sadekbaroudi/fingerpunch/firmware/README.md

# Firmware

This has moved to:
https://github.com/sadekbaroudi/qmk_firmware/tree/master/keyboards/fingerpunch/FIRMWARE.md

General readme for fingerpunch configuration options can be found here:
https://github.com/sadekbaroudi/qmk_firmware/tree/master/keyboards/fingerpunch/README.md
