sadekbaroudi/fingerpunch/keyboards/vikropad/README.md

# vikropad

The PCB and details can be found in the [vik github repository](https://github.com/sadekbaroudi/vik/tree/master/pcb/vikropad/)

The cases can be found in the `cases` directory in this repository.
