sadekbaroudi/fingerpunch/keycaps/CMY/README.md

# Cylindrical Minimal Y (CMY)

These are keycaps that are a standard 18mm width, but only 15.4mm height. The intent is to have some comfortable keycaps to be used with keyboard designs that utilize minimal Y spacing.

There is support for the following switch types:  
* MX
* Choc v1
* KS-27 and KS-33

Note: I do not recommend these for keyboards that have standard 19mm pcb vertical spacing. These will leave a gap between the keycaps, and will not be as comfortable. That said, you can definitely use them on standard spacing if you like!

## Build pics

MX:  
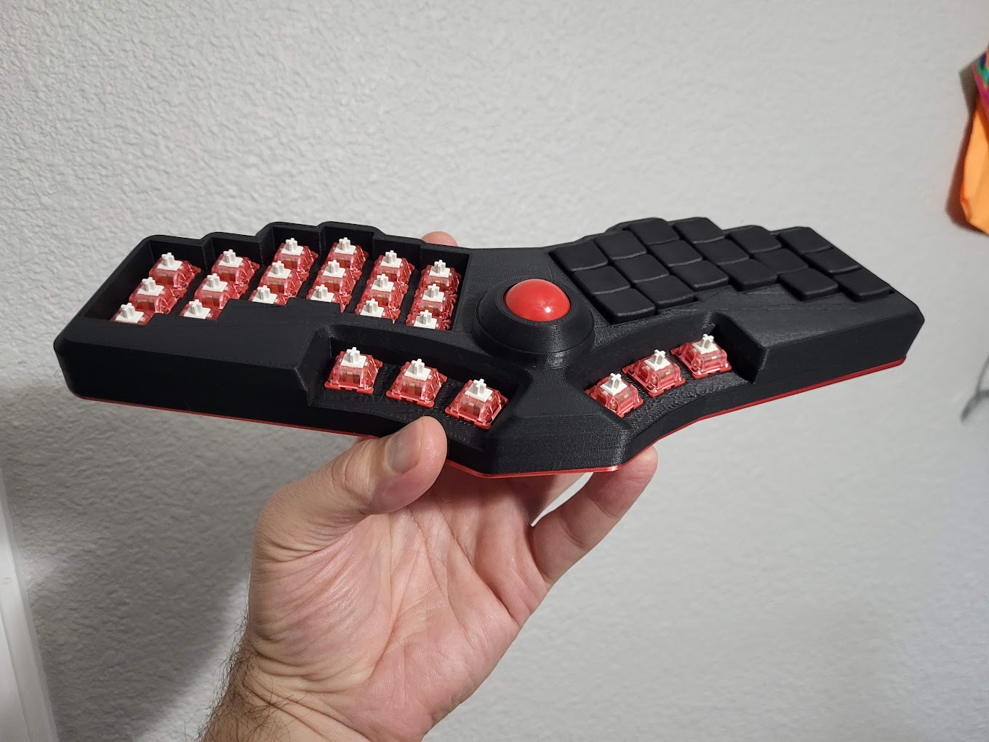
[picture p8: keycaps/CMY/images/build-mx-5-degree.jpg]
mx5


Choc:  
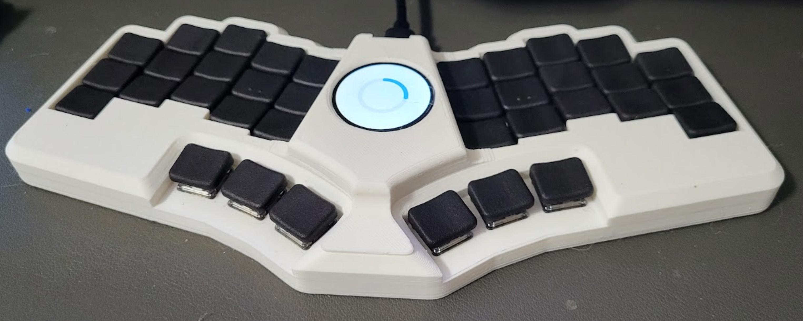
[picture p9: keycaps/CMY/images/build-choc-5-degree.jpg]
choc5


KS-33:  
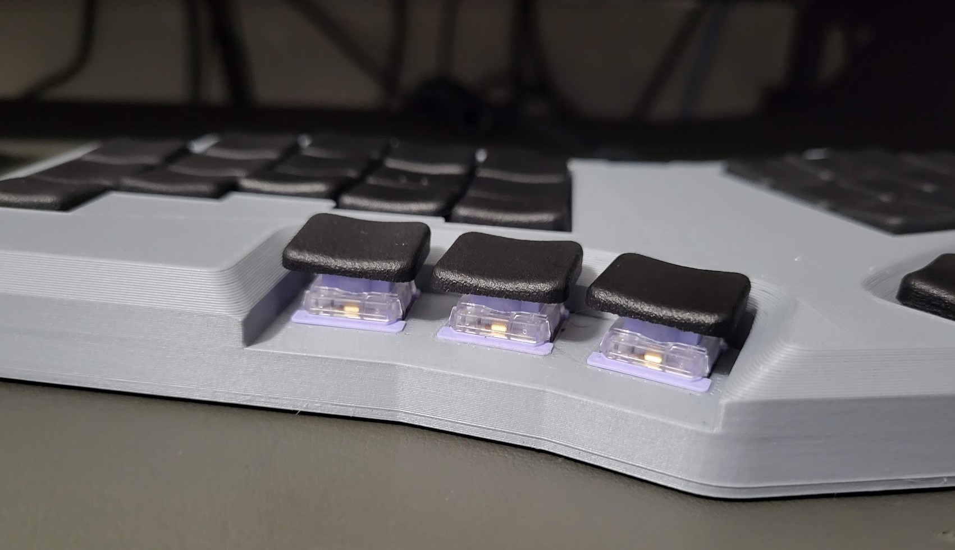
[picture p10: keycaps/CMY/images/build-ks33-5-degree.jpg]
ks33-5


## Renders

For the renders below, note that non-sculpted thumbs are not pictured. If you'd like to use non-sculpted thumbs, you can use the 12 degree R2/R4 keys. They make for good thumb keys.

### Homing

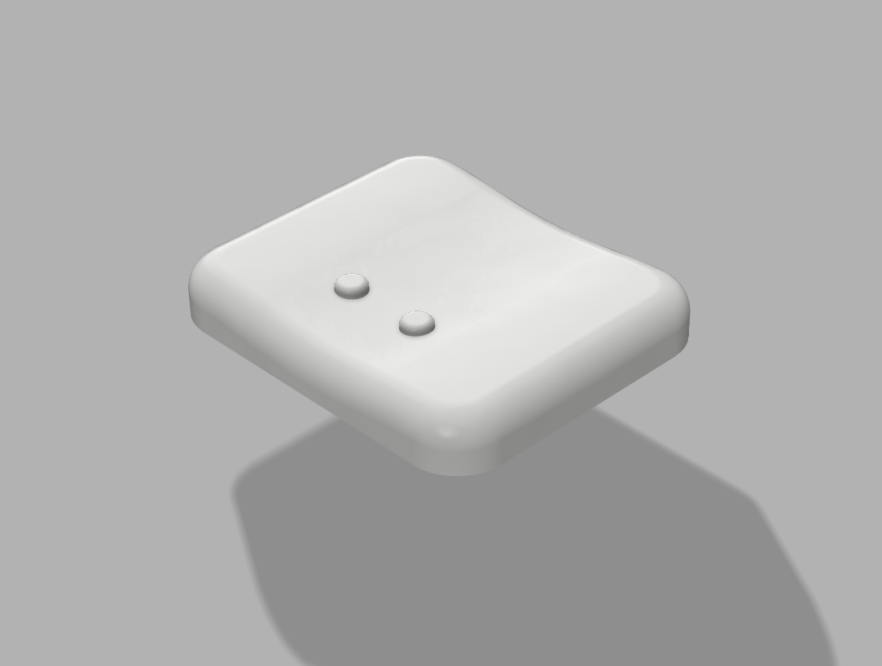
[picture p11: keycaps/CMY/images/CMY-homing.png]
CMY-homing


### 5 degree vertical tilt

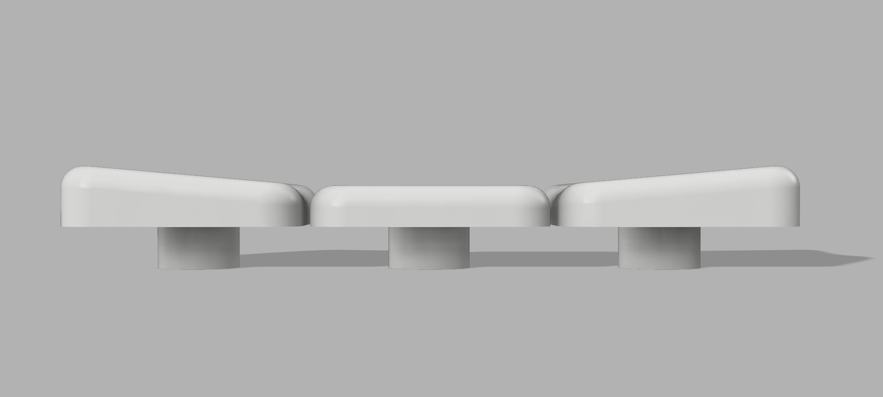
[picture p12: keycaps/CMY/images/CMY-5-lateral-side.png]
CMY-5-lateral-side


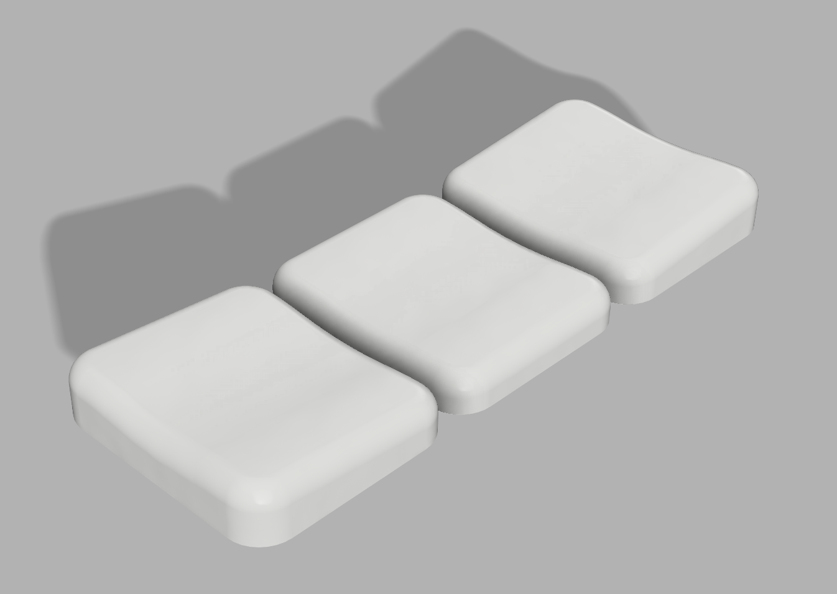
[picture p13: keycaps/CMY/images/CMY-5-lateral-45corner.png]
CMY-5-lateral-45corner


### 12 degree vertical tilt

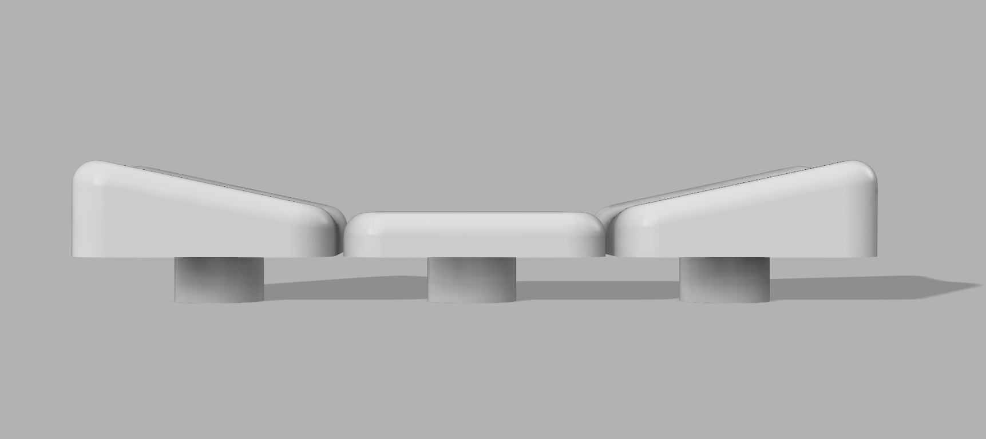
[picture p14: keycaps/CMY/images/CMY-12-lateral-side.png]
CMY-12-lateral-side


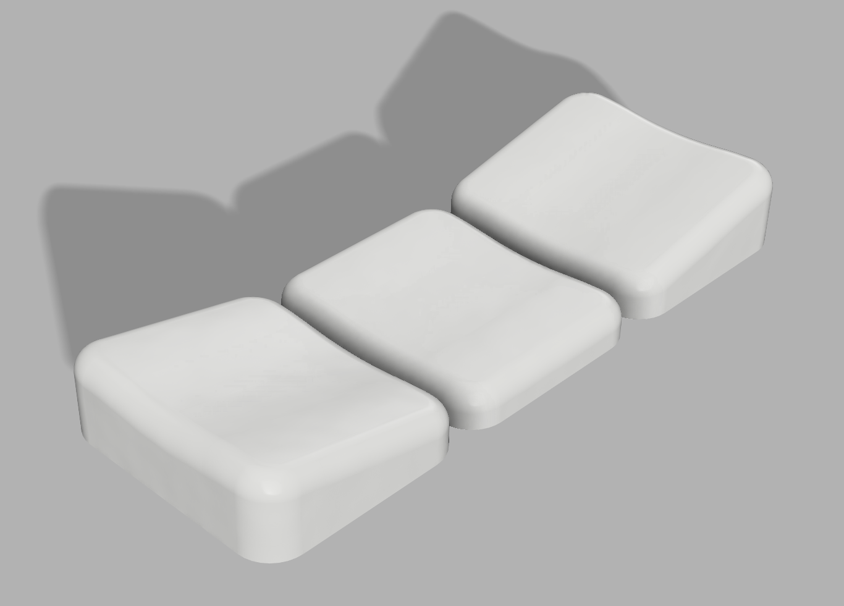
[picture p15: keycaps/CMY/images/CMY-12-lateral-45corner.png]
CMY-12-lateral-45corner


### 12 degree edge columns

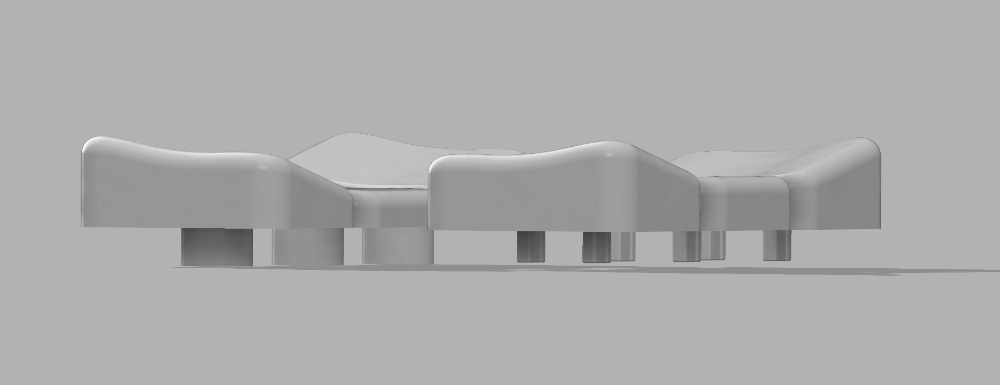
[picture p16: keycaps/CMY/images/CMY-12-edge-col-45flat.png]
CMY-12-edge-col-45flat


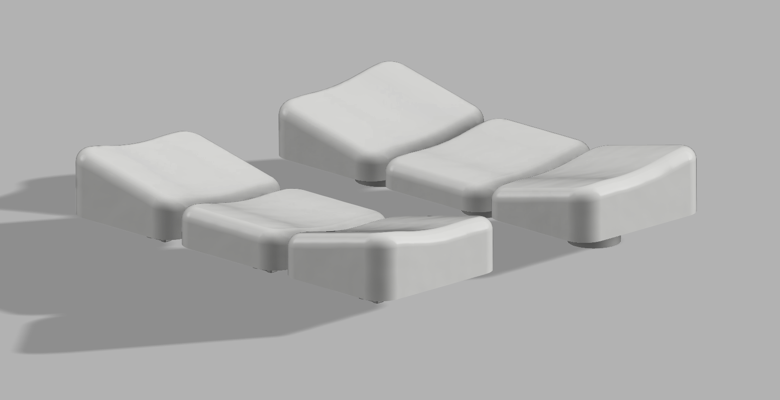
[picture p17: keycaps/CMY/images/CMY-12-edge-col-corner.png]
CMY-12-edge-col-corner


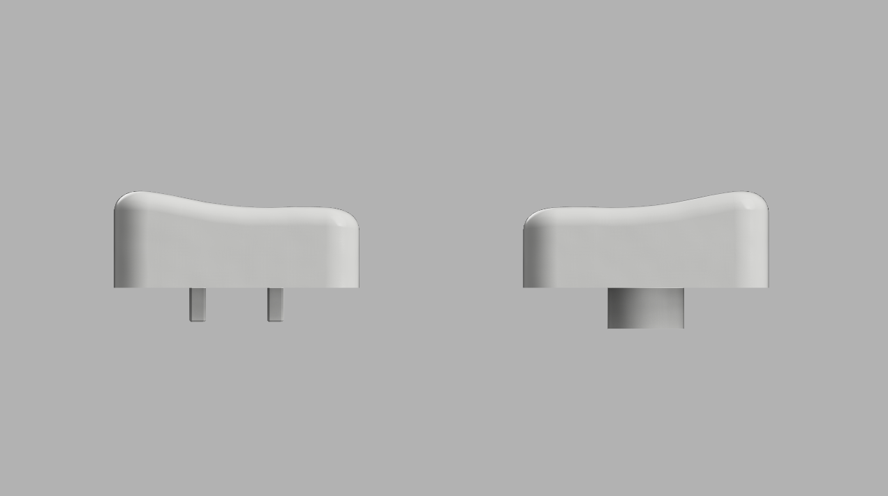
[picture p18: keycaps/CMY/images/CMY-12-edge-col-front.png]
CMY-12-edge-col-front


### 12 degree vertical tilt flat ends

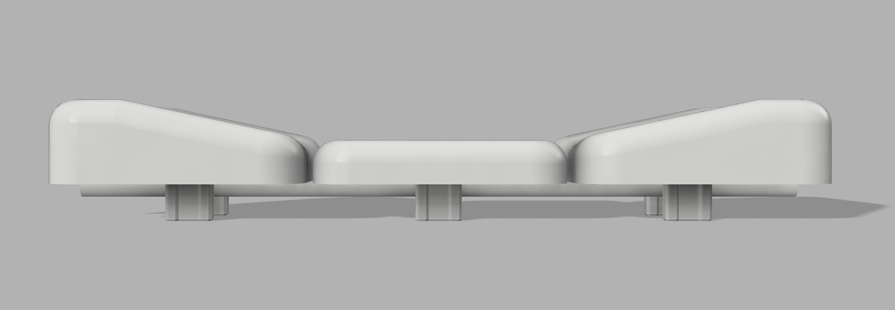
[picture p19: keycaps/CMY/images/CMY-12-flat-ends-lateral-side.png]
CMY-12-flat-ends-lateral-side


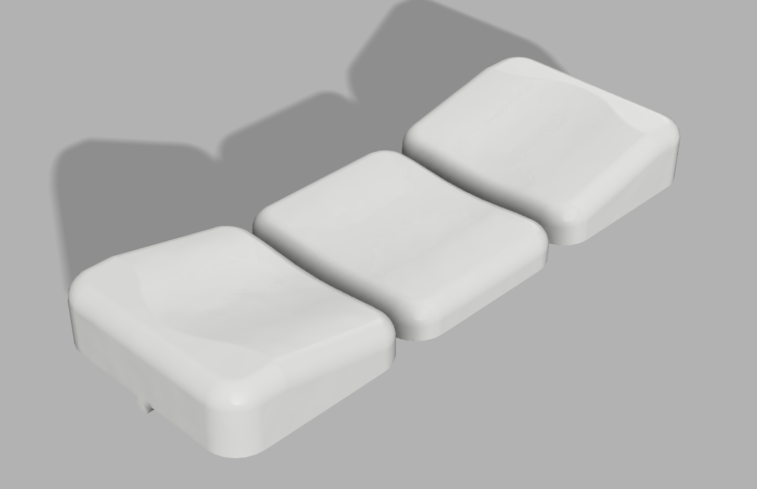
[picture p20: keycaps/CMY/images/CMY-12-flat-ends-lateral-45corner.png]
CMY-12-flat-ends-lateral-45corner


### Sculpted thumbs

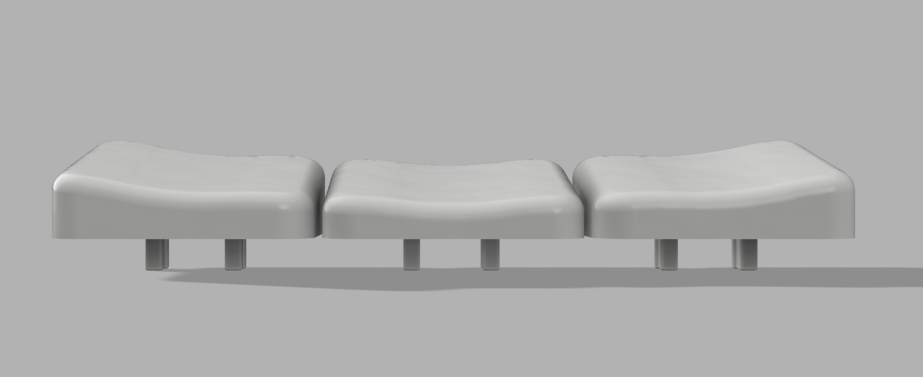
[picture p21: keycaps/CMY/images/CMY-12-sculpted-thumbs-front.png]
CMY-12-sculpted-thumbs-front


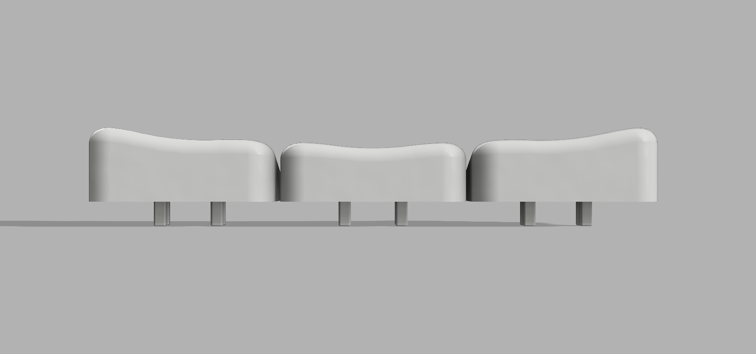
[picture p22: keycaps/CMY/images/CMY-12-sculpted-thumbs-back.png]
CMY-12-sculpted-thumbs-back


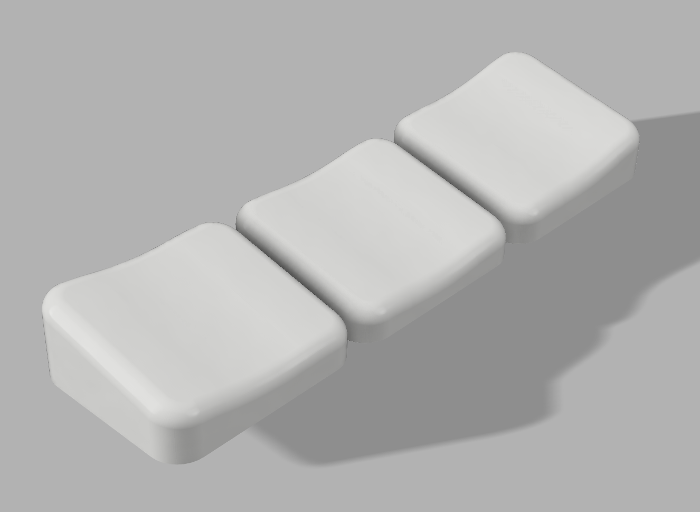
[picture p23: keycaps/CMY/images/CMY-12-sculpted-thumbs-45corner.png]
CMY-12-sculpted-thumbs-45corner


### Other

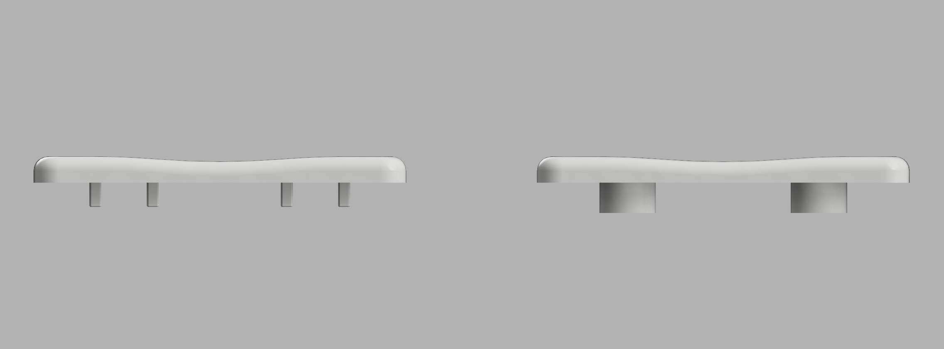
[picture p24: keycaps/CMY/images/CMY-2U-front.png]
CMY-2U-front


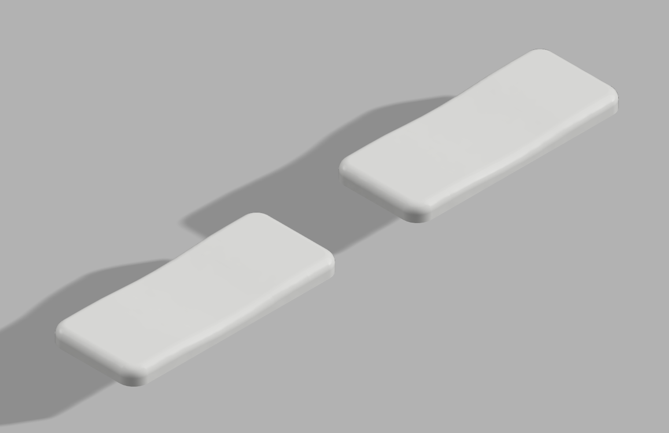
[picture p25: keycaps/CMY/images/CMY-2U-45corner.png]
CMY-2U-45corner
