sadekbaroudi/fingerpunch/keyboards/stenographobe/README.md

# stenographobe

http://fingerpunch.xyz/product/stenographobe
