sadekbaroudi/fingerpunch/keyboards/rock-on/README.md

# Rock On

https://fingerpunch.xyz/product/rock-on/
