sadekbaroudi/fingerpunch/keyboards/kucheza/byomcu/README.md

# kucheza byomcu

This is a limited edition pcb, very few of these were made, so it's very likely you should be looking at the other versions (e.g. v1 folder)
