sadekbaroudi/fingerpunch/3d-models/display-housings/ili9341/README.md

# ILI9341 display

This is a housing for a commonly found display. You can incorporate the housing into another object, and it accepts M2 heat set inserts to screw in the display. However, it is a press fit design, so you don't need them.

Purchased from:  
https://www.aliexpress.us/item/2251832829271342.html

## product image

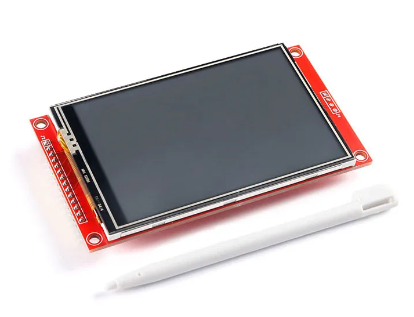
[picture p29: 3d-models/display-housings/ili9341/images/ili9341-4inch.png]
sample-image
