sadekbaroudi/fingerpunch/keyboards/vikropad/cases/README.md

# vikropad case

## choc and gateron low profile

### images

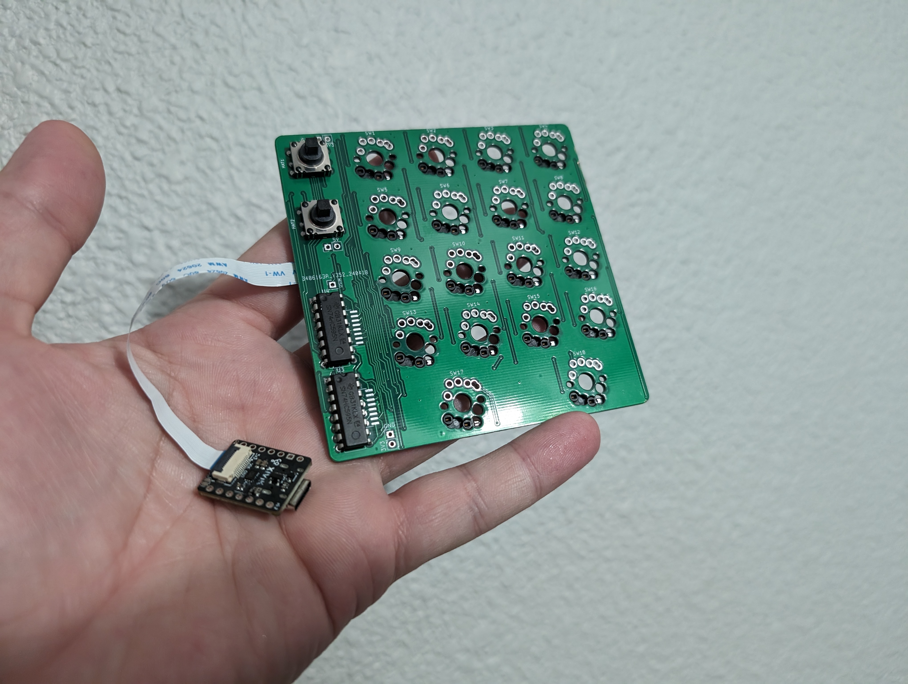
[picture p30: keyboards/vikropad/cases/choc-glp/images/vikropad-pcb-assembled.jpg]
vikropad-pcb-assembled

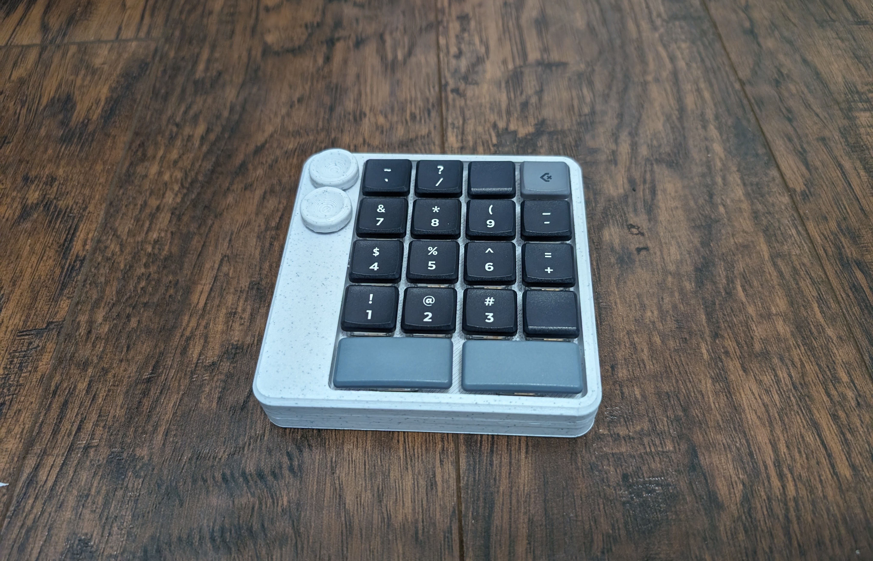
[picture p31: keyboards/vikropad/cases/choc-glp/images/vikropad-case-assembled-01.jpg]
vikropad-case-assembled-01

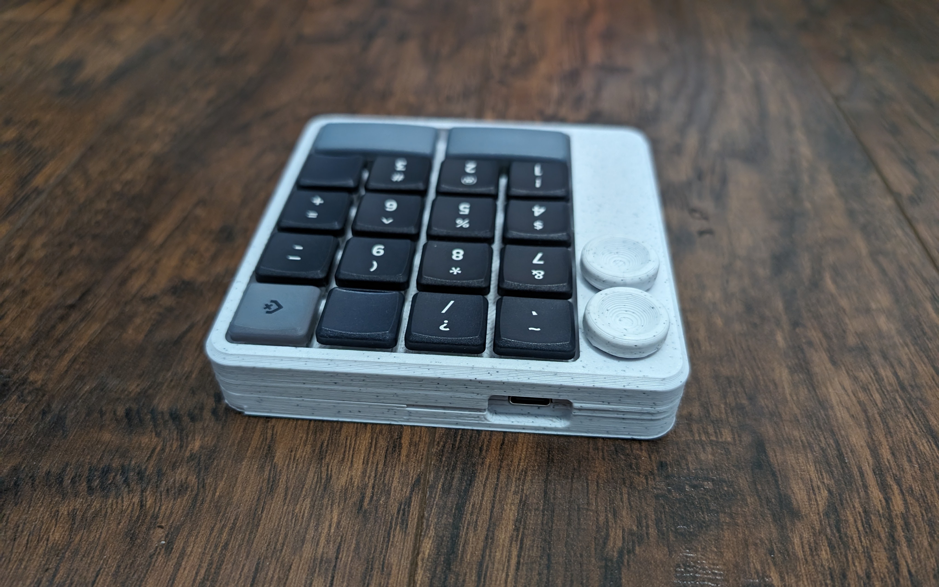
[picture p32: keyboards/vikropad/cases/choc-glp/images/vikropad-case-assembled-02.jpg]
vikropad-case-assembled-02
