sadekbaroudi/fingerpunch/keyboards/rock-on/cases/README.md

# rock on cases

I take no liability if these don't work as intended. I personally use them for the 3D printed cases on the website. I recheck them every time before I print, so I cannot ensure that they are perfect in their current state in this repository.
