sadekbaroudi/fingerpunch/keyboards/ffkb/cases/fr4/README.md

# ffkb fr4 plates

These are untested. They should be fine, as they are based on the PCB layout, but use at your own risk!
