sadekbaroudi/fingerpunch/keyboards/ffkb/cases/stls/v4/README.md

# ffkb v4

# bom

> **Note**
> This list is only for the case build, but not the entire ffkb keyboard build. You'll still need the ffkb pcb and all the components required for a typical ffkb build. See the [ffkb v4 usb-hub product page](https://fingerpunch.xyz/product/faux-fox-keyboard-v4)

To build this style case, you'll need:
* one of the case bodies
* the trackball holder
* the trackball cover
* bottom plate
* 8x - 8mm diameter by 3mm magnets
* 9x - 5mm M2 screws
* 9x - M2 4mm heat set inserts

# pictures

## 6 column

## mx trackball case with ec11 cutouts

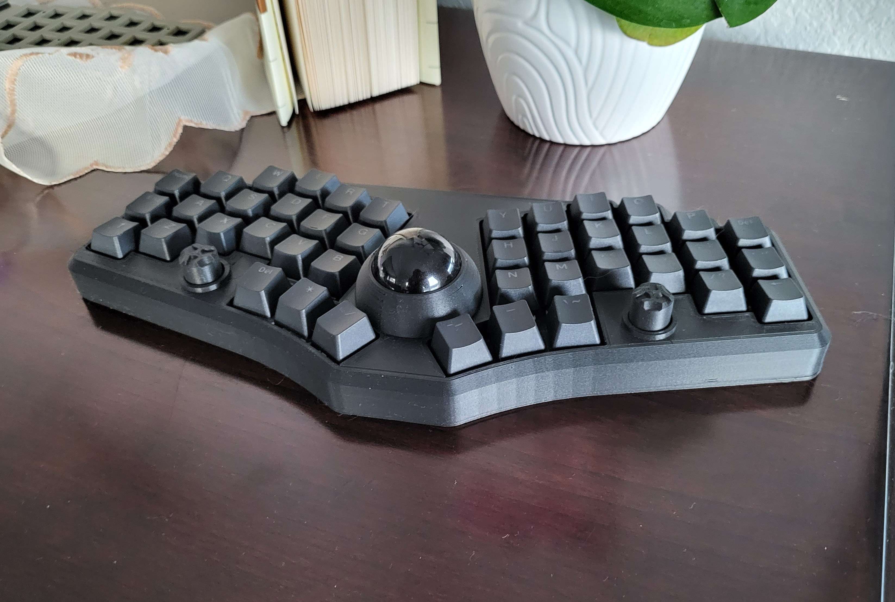
[picture p35: keyboards/ffkb/cases/stls/v4/images/ff-rp-u3-mx-6-tr-ec-01.png]
render ffkb mx trackball case 01


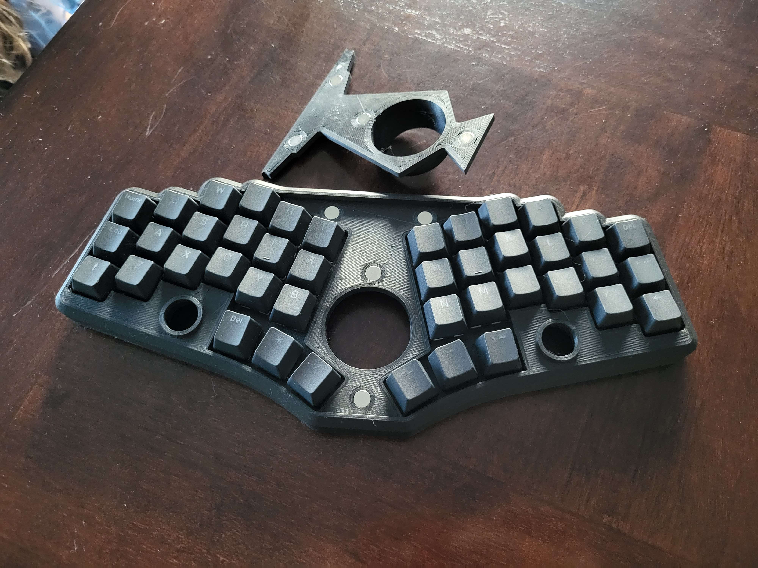
[picture p36: keyboards/ffkb/cases/stls/v4/images/ff-rp-u3-mx-6-tr-ec-02.png]
render ffkb mx trackball case 02


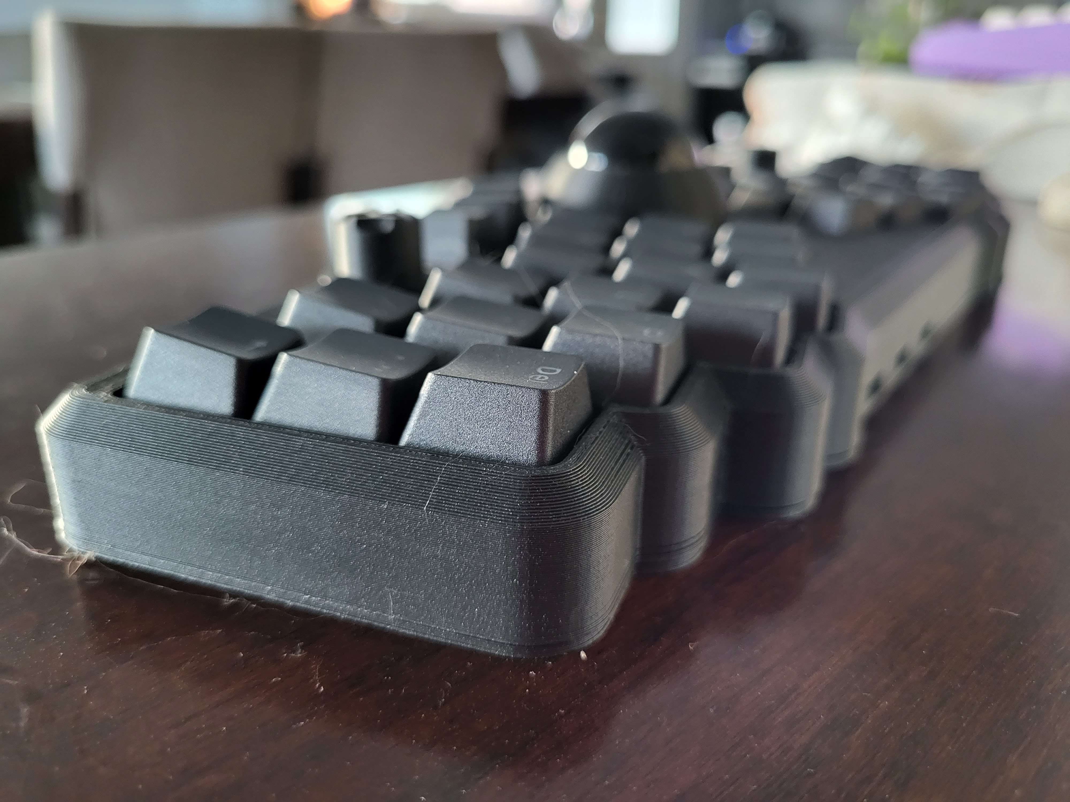
[picture p37: keyboards/ffkb/cases/stls/v4/images/ff-rp-u3-mx-6-tr-ec-03.png]
render ffkb mx trackball case 03


# renders

## 6 column

### choc trackball case with ec11 cutouts

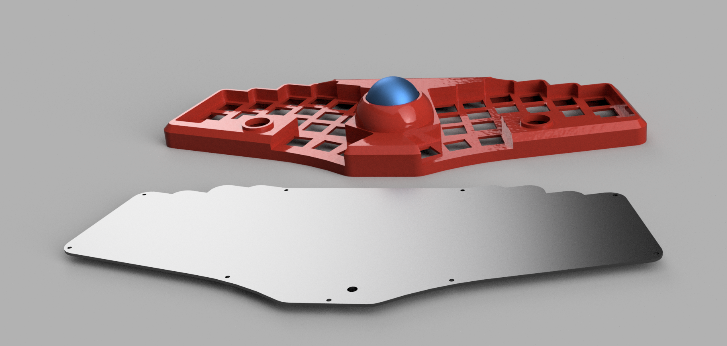
[picture p38: keyboards/ffkb/cases/stls/v4/images/ff-rp-u3-choc-6-tr-ec.png]
render ffkb choc trackball case


### choc trackball case with evq cutouts

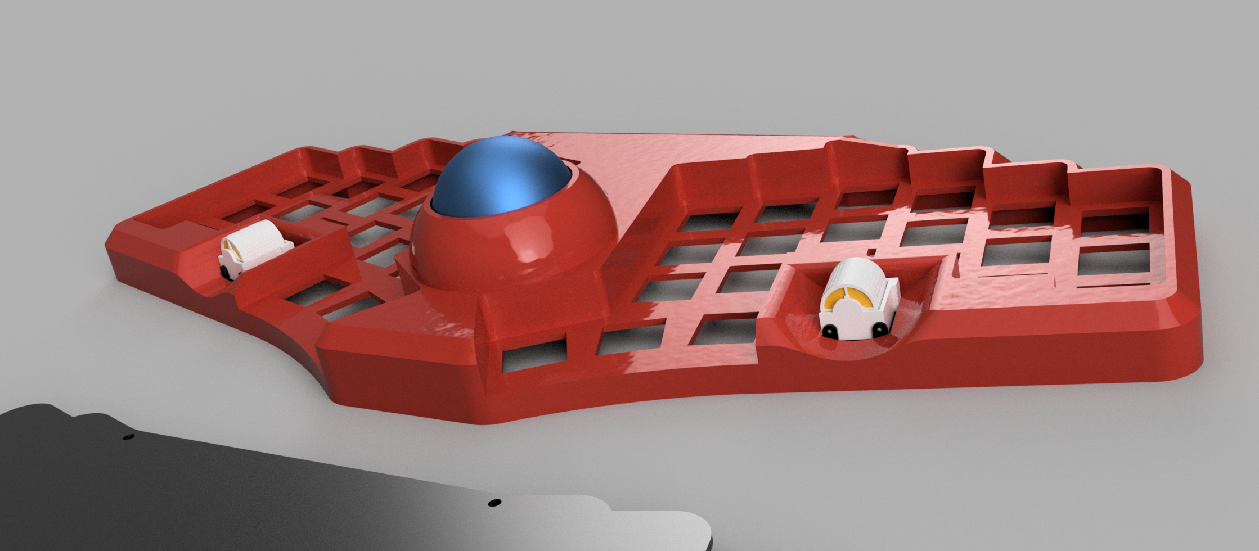
[picture p39: keyboards/ffkb/cases/stls/v4/images/ff-rp-u3-choc-6-tr-ev-01.png]
render ffkb choc trackball case with evq 01


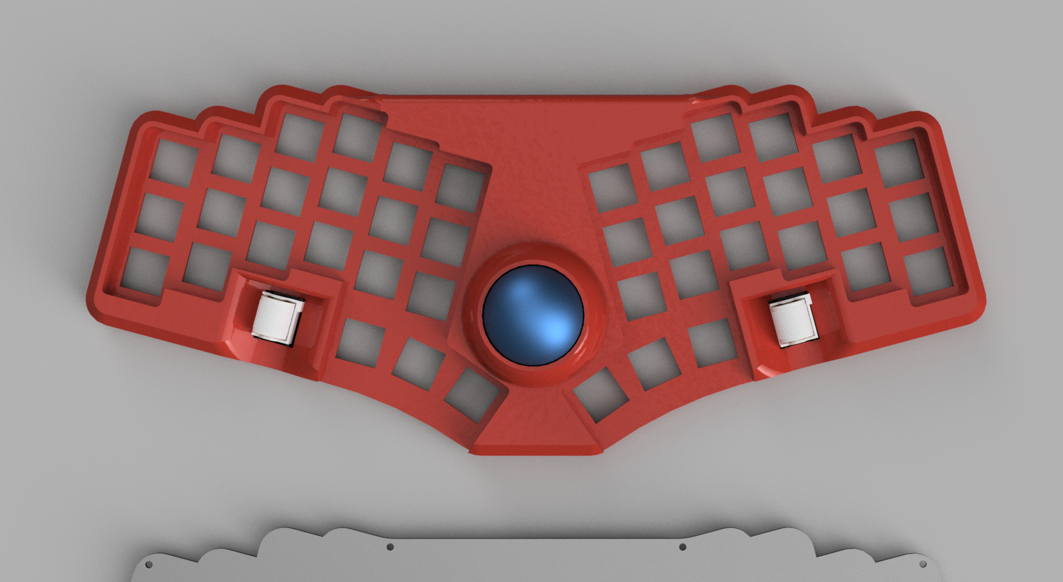
[picture p40: keyboards/ffkb/cases/stls/v4/images/ff-rp-u3-choc-6-tr-ev-02.png]
render ffkb choc trackball case with evq 02


## 5 column

### choc trackball case with evq cutouts

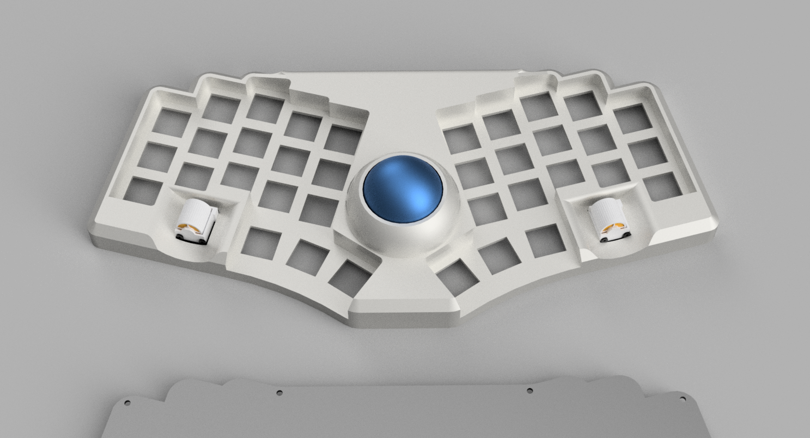
[picture p41: keyboards/ffkb/cases/stls/v4/images/ff-rp-u3-choc-5-tr-ev-01.png]
render ffkb 5 col choc trackball case with evq 01


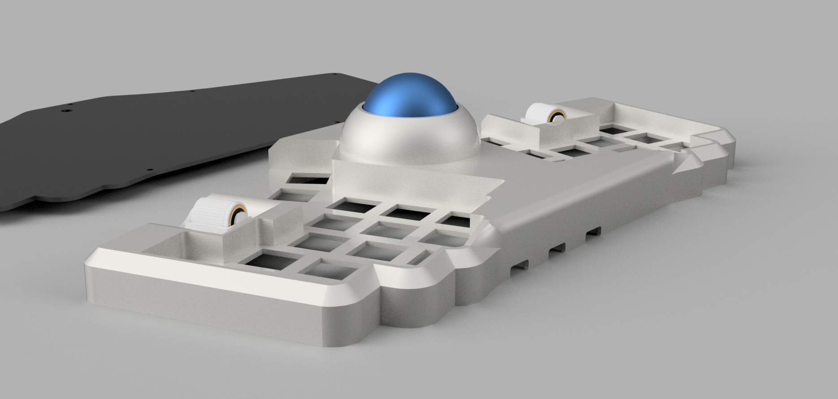
[picture p42: keyboards/ffkb/cases/stls/v4/images/ff-rp-u3-choc-5-tr-ev-02.png]
render ffkb 5 col choc trackball case with evq 02
