sadekbaroudi/fingerpunch/keyboards/ffkb/cases/stls/lowpro-chunky/README.md

# ffkb low pro chunky case

A simple ffkb case for low profile switches.

This will work nicely with all ffkb pcbs, provided you're not using any center components.

You can use the bottom plates from the lowpro-led-ring case.
