sadekbaroudi/fingerpunch/keyboards/ffkb/firmware/v1/byo-mcu/vial/readme.md

# These are untested, but committing as placeholder until tested.

Select the hex file based on the features you have on your board, and load it with QMK Toolbox

Once you have loaded it, you can use Vial to configure your keyboard:
https://get.vial.today/

Note that you can always manually create your firmware:
https://github.com/sadekbaroudi/qmk_firmware/

Specifically, look at the keyboards/fingerpunch/ffkb_byomcu directory
