sadekbaroudi/fingerpunch/keyboards/ffkb/cases/stls/v2/low-pro/README.md

# Build notes

## OLED on low pro case

First you want to put the OLED onto the pcb

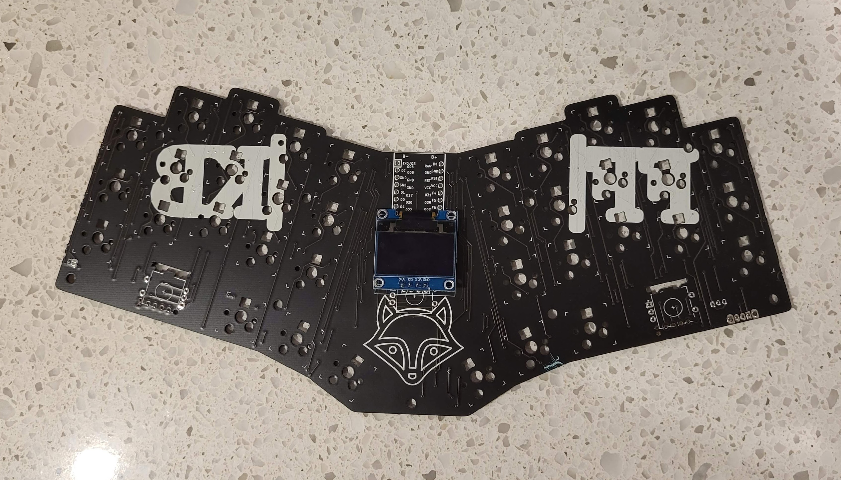
[picture p52: keyboards/ffkb/cases/stls/v2/low-pro/images/lowpro-oled-01.jpg]
lowpro-oled-01


***

Now you want to put 6 switches or so into the case to make sure the pcb is in the correct position

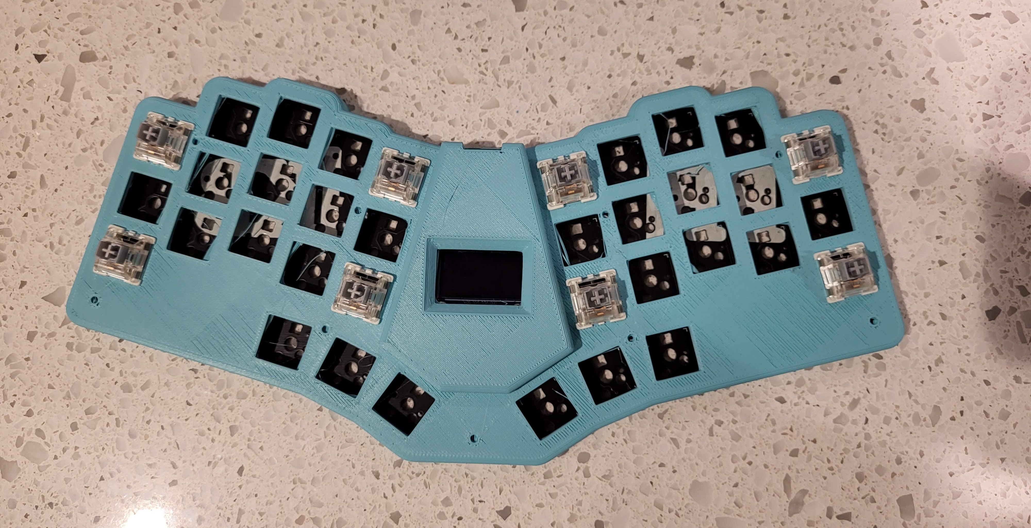
[picture p53: keyboards/ffkb/cases/stls/v2/low-pro/images/lowpro-oled-02.jpg]
lowpro-oled-02


***

Place the pcb into the case. This means that the OLED will be in the correct depth. Solder only 1 pin. Flip the board over to make sure that the OLED looks right. If it's a bit off, heat up the pin you soldered and move the OLED a bit. Repeat this until the OLED looks correct from the top. Now, solder the other 3 pins on the OLED

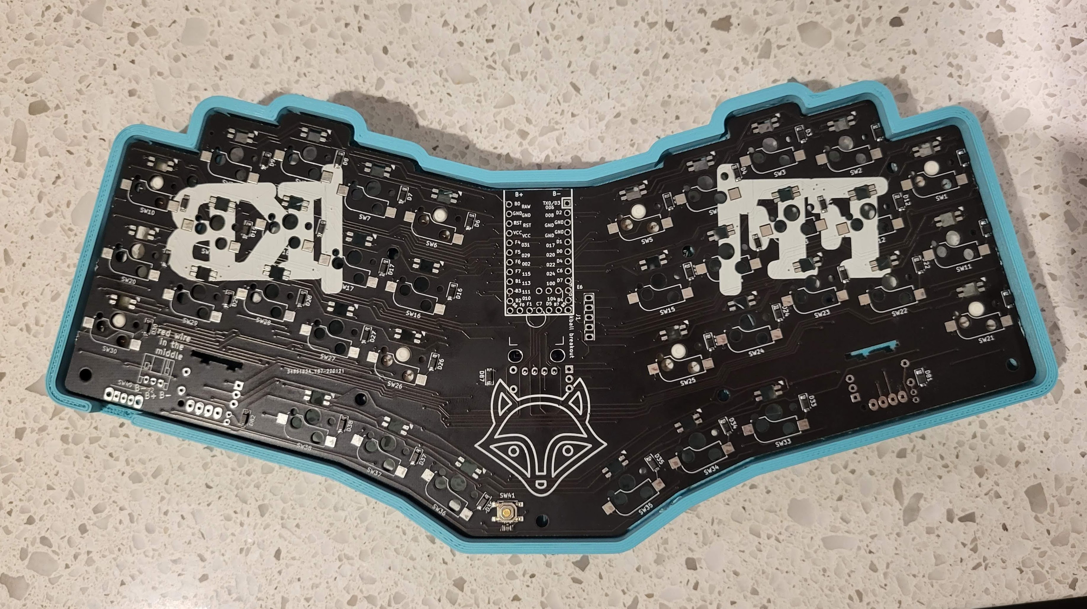
[picture p54: keyboards/ffkb/cases/stls/v2/low-pro/images/lowpro-oled-03.jpg]
lowpro-oled-03
