sadekbaroudi/fingerpunch/3d-models/trackball-thumb-helmet/images/M2-mounting-screws.png

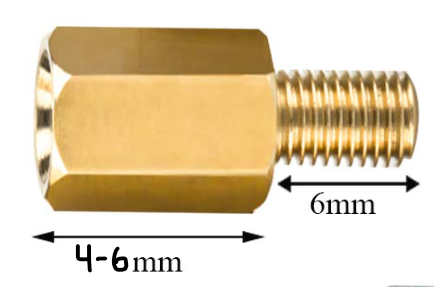
3d-models/trackball-thumb-helmet/images/M2-mounting-screws.png
