sadekbaroudi/fingerpunch/keyboards/pinkies-out/v2/images/pcb-controller.jpg

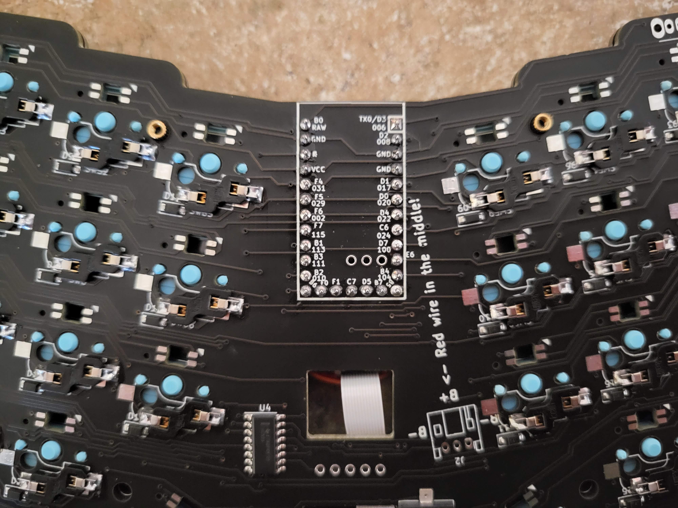
keyboards/pinkies-out/v2/images/pcb-controller.jpg
