sadekbaroudi/fingerpunch/keyboards/pinkies-out/v2/images/top-plate.png

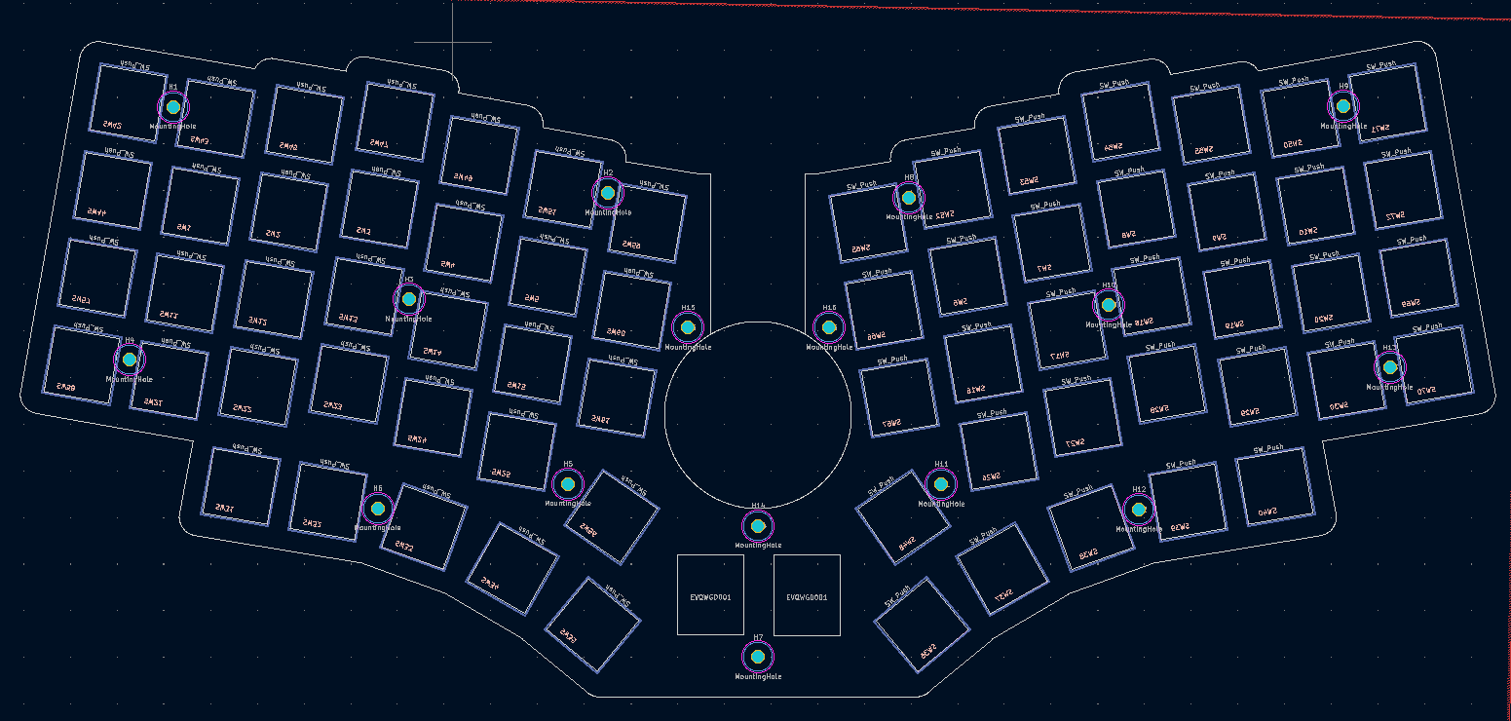
keyboards/pinkies-out/v2/images/top-plate.png
