sadekbaroudi/fingerpunch/keycaps/CMY/images/1.png

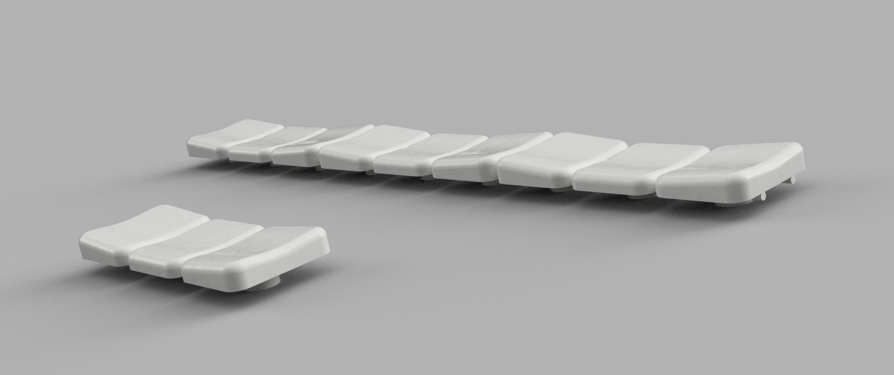
keycaps/CMY/images/1.png
