sadekbaroudi/fingerpunch/keycaps/CMY/images/2.png

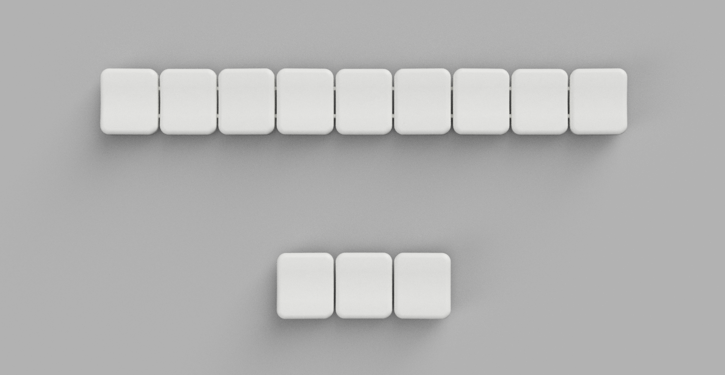
keycaps/CMY/images/2.png
