sadekbaroudi/fingerpunch/keycaps/CMY/images/CMY-12-flat-ends-lateral-45up.png

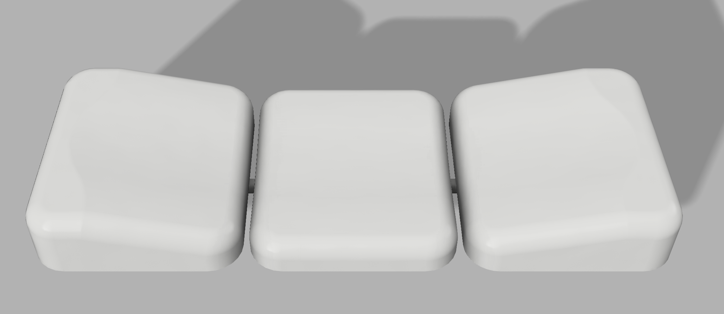
keycaps/CMY/images/CMY-12-flat-ends-lateral-45up.png
