sadekbaroudi/fingerpunch/3d-models/5-way-tactile-switch-knobs/5-way-flat-chamfer.step

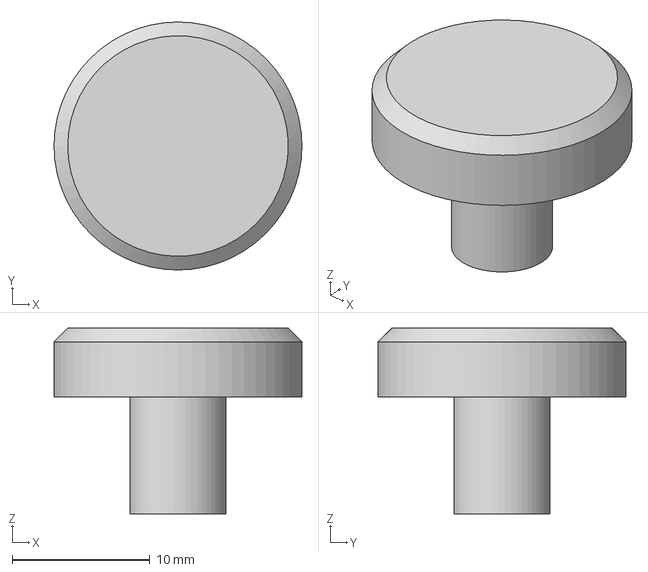
[picture p62: CAD file, 2024-04-17]
3d-models/5-way-tactile-switch-knobs/5-way-flat-chamfer.step
18.0 x 18.0 x 13.5 mm
