sadekbaroudi/fingerpunch/3d-models/display-housings/ili9341/ili9341-4inch-housing.step

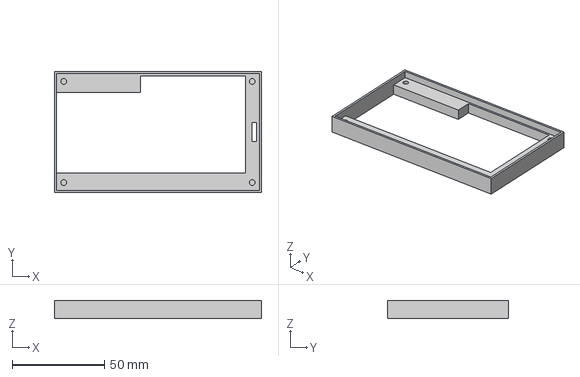
[picture p63: CAD file, 2024-06-14]
3d-models/display-housings/ili9341/ili9341-4inch-housing.step
112.4 x 65.7 x 10.0 mm
