sadekbaroudi/fingerpunch/3d-models/ec11-knobs/D/mushroom-6.1mm.stl

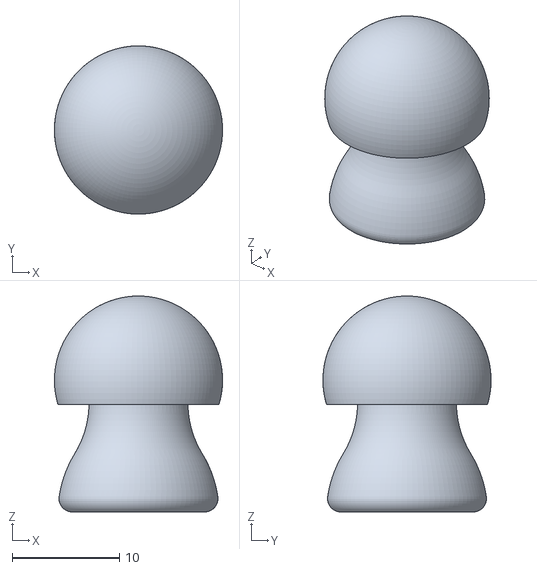
[picture p64: CAD file, 2023-10-12]
3d-models/ec11-knobs/D/mushroom-6.1mm.stl
15.7 x 15.7 x 20.1
