sadekbaroudi/fingerpunch/3d-models/fingerpunch-emblems/fingerpunch-emblem-45mm-diameter-35mm-plug.stl

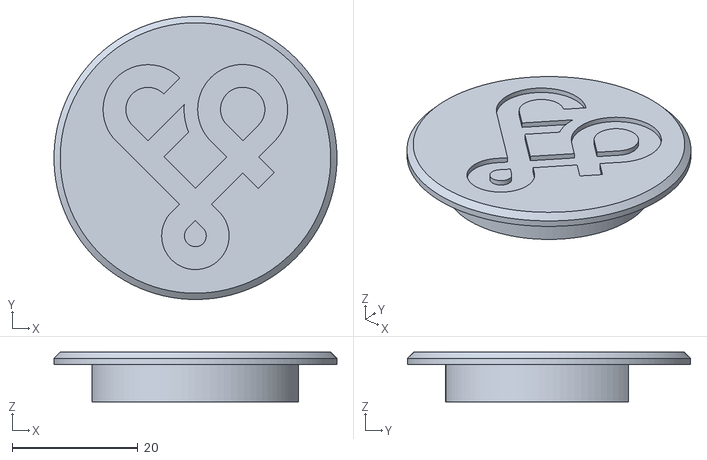
[picture p65: CAD file, 2024-02-02]
3d-models/fingerpunch-emblems/fingerpunch-emblem-45mm-diameter-35mm-plug.stl
45.0 x 45.0 x 7.90
