sadekbaroudi/fingerpunch/3d-models/per56-trackball/34mm/per56-34mm-trackball-cover.stl

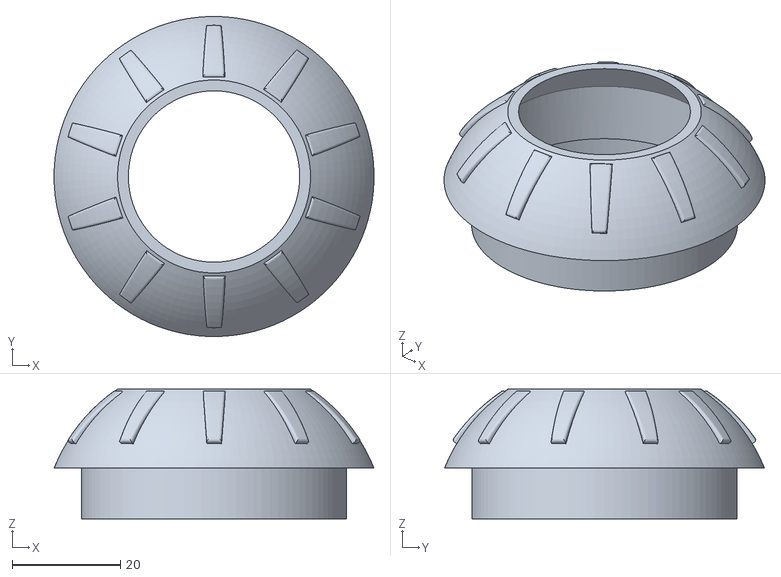
[picture p66: CAD file, 2023-10-06]
3d-models/per56-trackball/34mm/per56-34mm-trackball-cover.stl
59.1 x 59.1 x 24.0
