sadekbaroudi/fingerpunch/3d-models/per56-trackball/38mm/per56-38mm-trackball-housing-4mm-bearings.stl

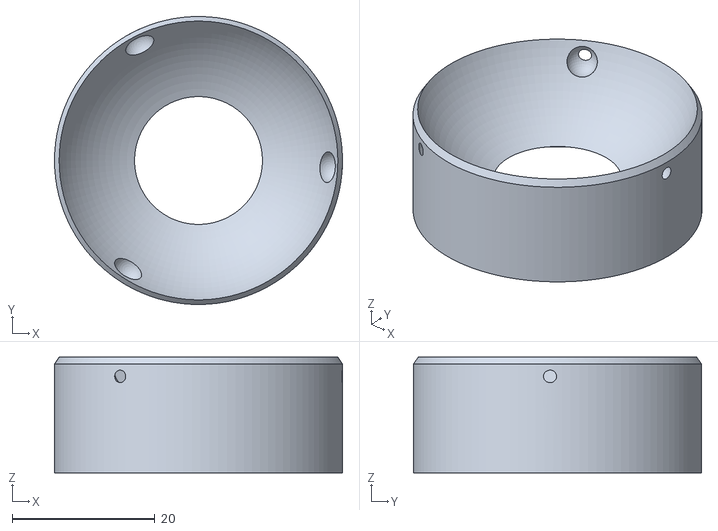
[picture p67: CAD file, 2023-09-24]
3d-models/per56-trackball/38mm/per56-38mm-trackball-housing-4mm-bearings.stl
40.3 x 40.3 x 16.2
