sadekbaroudi/fingerpunch/3d-models/solenoid/uxcell-a14092600ux0438/uxcell-a14092600ux0438-holder.stl

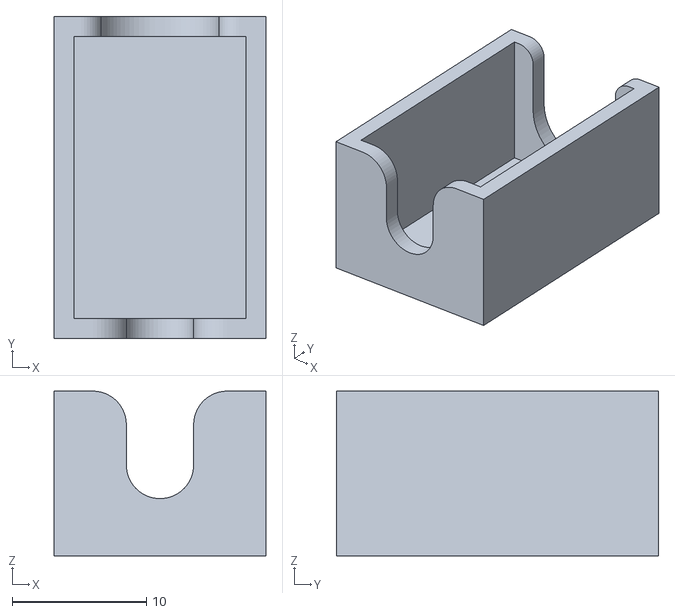
[picture p68: CAD file, 2024-06-04]
3d-models/solenoid/uxcell-a14092600ux0438/uxcell-a14092600ux0438-holder.stl
15.8 x 24.0 x 12.3
