sadekbaroudi/fingerpunch/3d-models/tenting/print-in-place/device-tenting-stand-70percent.stl

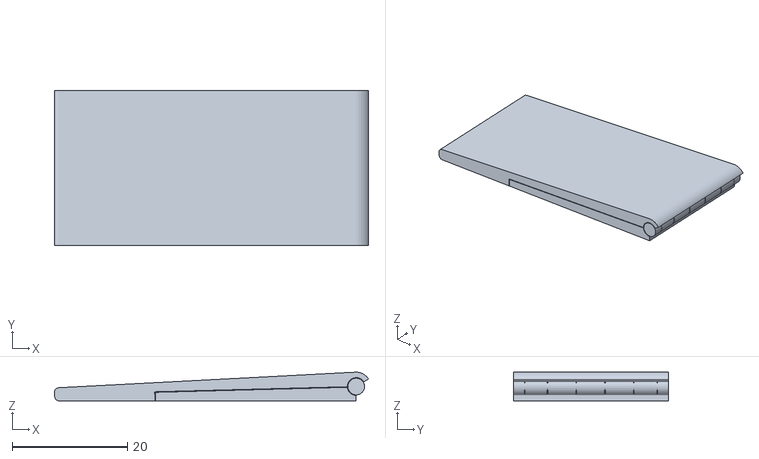
[picture p69: CAD file, 2024-01-10]
3d-models/tenting/print-in-place/device-tenting-stand-70percent.stl
54.6 x 27.0 x 5.00
