sadekbaroudi/fingerpunch/3d-models/trackball-thumb-helmet/trackball-thumb-helmet-housing-for-switch-cutouts-vik.stl

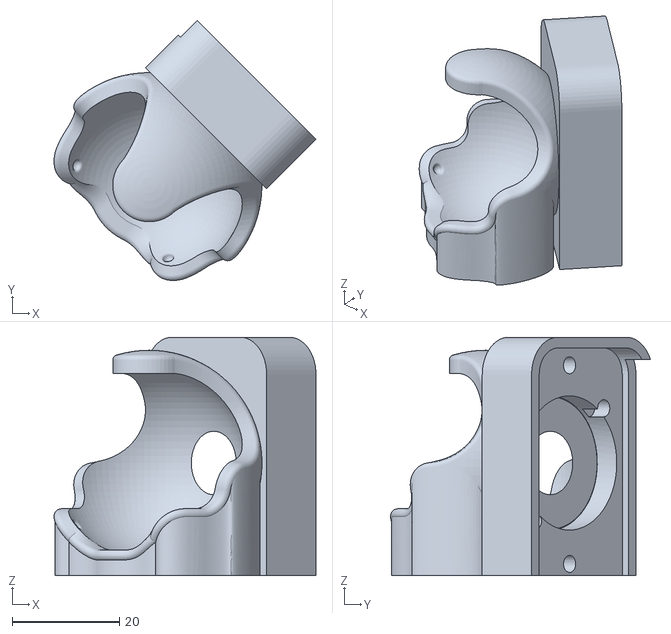
[picture p70: CAD file, 2024-05-14]
3d-models/trackball-thumb-helmet/trackball-thumb-helmet-housing-for-switch-cutouts-vik.stl
48.8 x 48.4 x 44.4
