sadekbaroudi/fingerpunch/3d-models/trackpoint/trackpoint-cover-labret-8Dx3Hx3mmCutout.stl

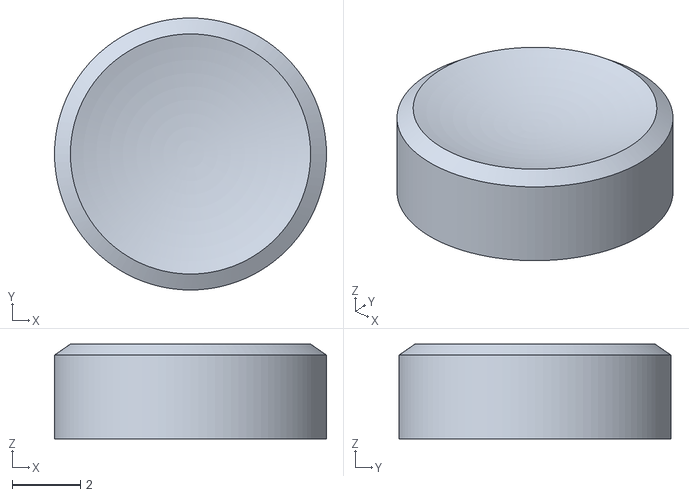
[picture p71: CAD file, 2024-02-26]
3d-models/trackpoint/trackpoint-cover-labret-8Dx3Hx3mmCutout.stl
8.00 x 8.00 x 2.79
