sadekbaroudi/fingerpunch/keyboards/bigbarobord/cases/stl/body-pimoroni.3mf

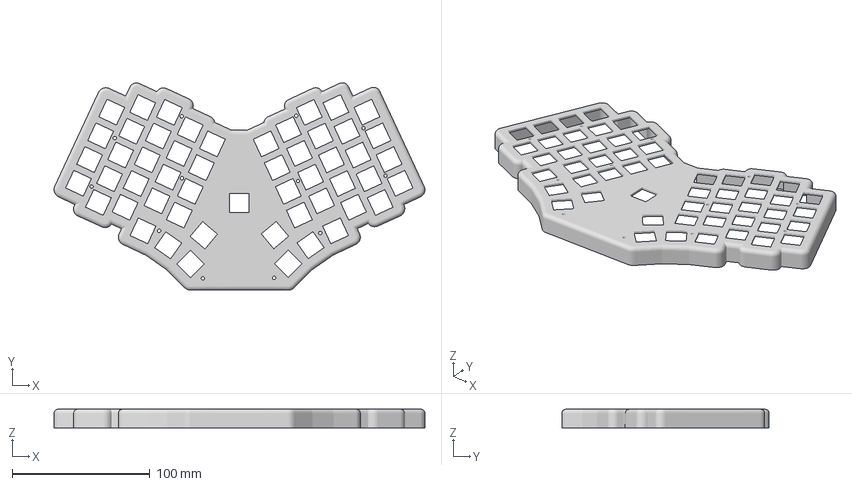
[picture p72: CAD file, 2022-08-29]
keyboards/bigbarobord/cases/stl/body-pimoroni.3mf
269.2 x 150.5 x 13.5 mm
