sadekbaroudi/fingerpunch/keyboards/bigbarobord/cases/svgs/general-template-brd.dxf

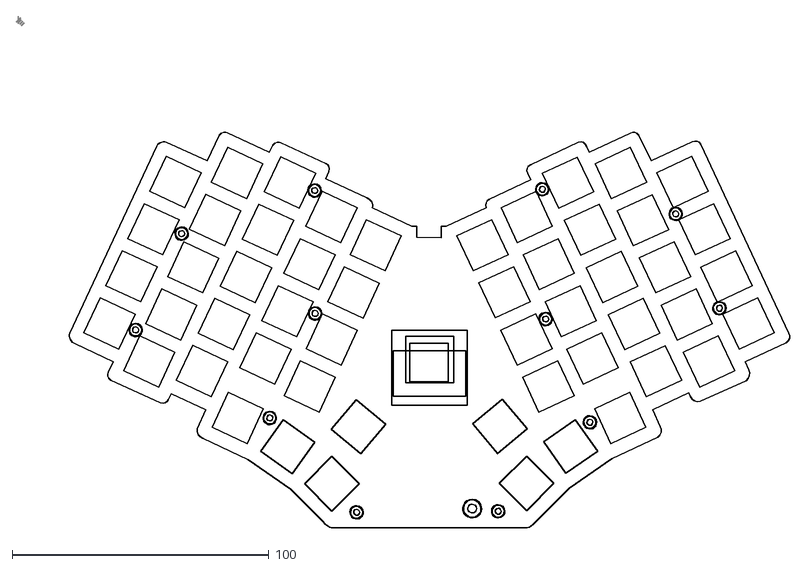
[picture p73: CAD file, 2022-08-29]
keyboards/bigbarobord/cases/svgs/general-template-brd.dxf
301.3 x 199.2
