sadekbaroudi/fingerpunch/keyboards/euclid36/cases/euclid36-bottom-plate-2mm.stl

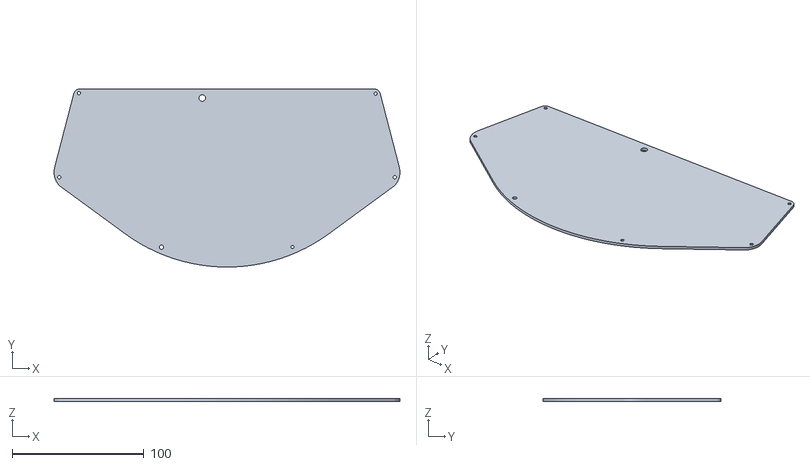
[picture p74: CAD file, 2023-08-09]
keyboards/euclid36/cases/euclid36-bottom-plate-2mm.stl
262.1 x 135.0 x 2.00
