sadekbaroudi/fingerpunch/keyboards/ffkb/cases/modular-plates/kicad/ffkb-switchplate-template-brd.dxf

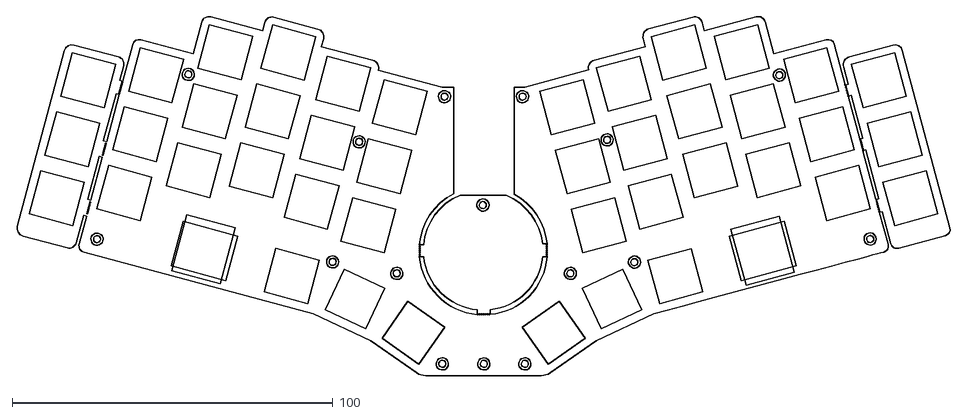
[picture p75: CAD file, 2022-09-06]
keyboards/ffkb/cases/modular-plates/kicad/ffkb-switchplate-template-brd.dxf
291.2 x 111.9
