sadekbaroudi/fingerpunch/keyboards/ffkb/cases/modular-plates/stls/ffkb-fr4-modular-cirque-cover.stl

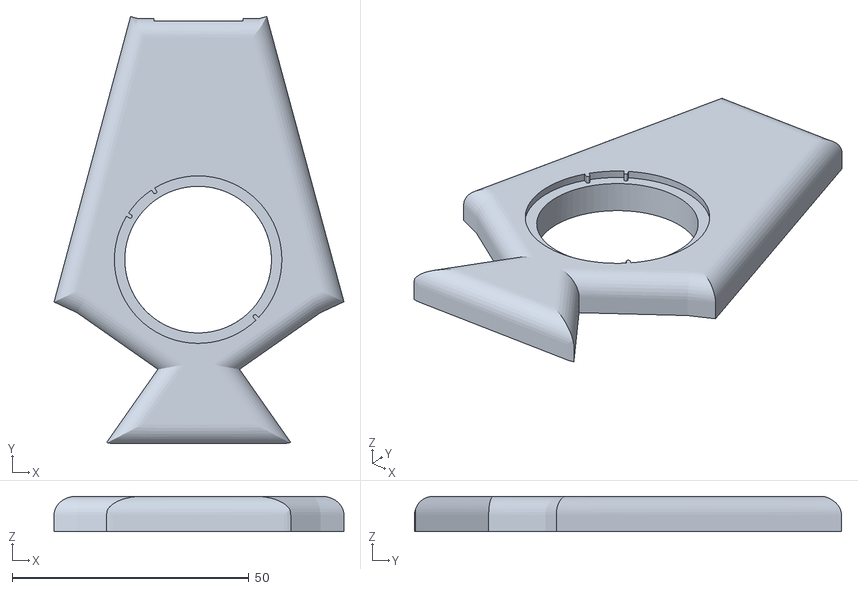
[picture p76: CAD file, 2022-09-06]
keyboards/ffkb/cases/modular-plates/stls/ffkb-fr4-modular-cirque-cover.stl
61.3 x 90.3 x 7.50
