sadekbaroudi/fingerpunch/keyboards/ffkb/cases/stls/encoder-addons/EC11-encoder-cap.3mf

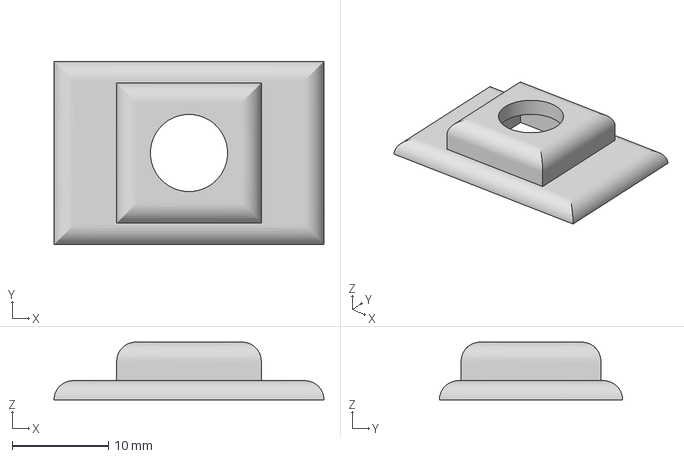
[picture p77: CAD file, 2022-08-29]
keyboards/ffkb/cases/stls/encoder-addons/EC11-encoder-cap.3mf
28.0 x 19.0 x 6.00 mm
