sadekbaroudi/fingerpunch/keyboards/ffkb/cases/stls/holyiot/ffkb-holyiot-6-mx-bottom.stl

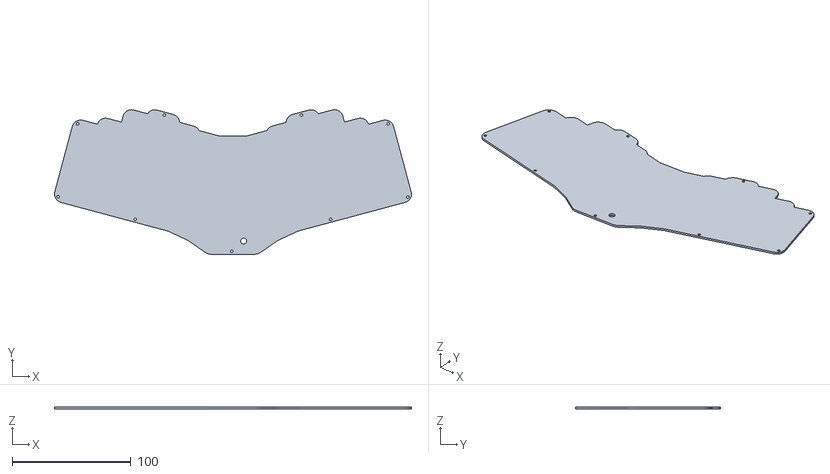
[picture p78: CAD file, 2024-04-29]
keyboards/ffkb/cases/stls/holyiot/ffkb-holyiot-6-mx-bottom.stl
300.7 x 121.8 x 1.60
