sadekbaroudi/fingerpunch/keyboards/ffkb/cases/stls/lite/min-y/ffkb-LMY-6-mx-wireless-25mm-trackball.stl

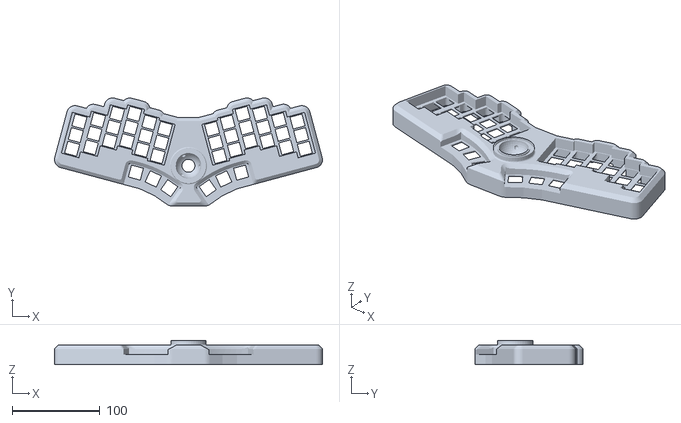
[picture p79: CAD file, 2024-08-12]
keyboards/ffkb/cases/stls/lite/min-y/ffkb-LMY-6-mx-wireless-25mm-trackball.stl
304.6 x 122.9 x 27.5
