sadekbaroudi/fingerpunch/keyboards/ffkb/cases/stls/lite/standard/ffkb-lite-5-bot-3.5mm-under-pcb.stl

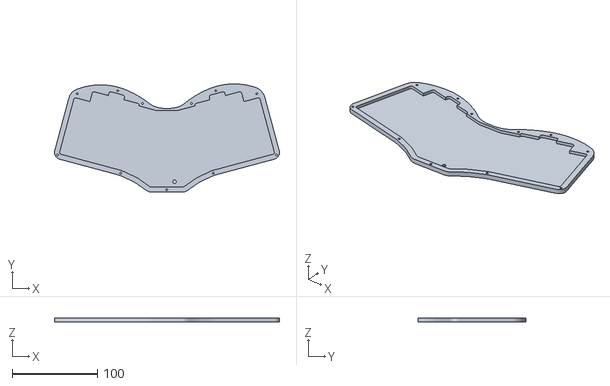
[picture p80: CAD file, 2024-06-14]
keyboards/ffkb/cases/stls/lite/standard/ffkb-lite-5-bot-3.5mm-under-pcb.stl
264.1 x 127.0 x 4.60
