sadekbaroudi/fingerpunch/keyboards/ffkb/cases/stls/lowpro-chunky/ff-lp-chunky-6-mx-body.stl

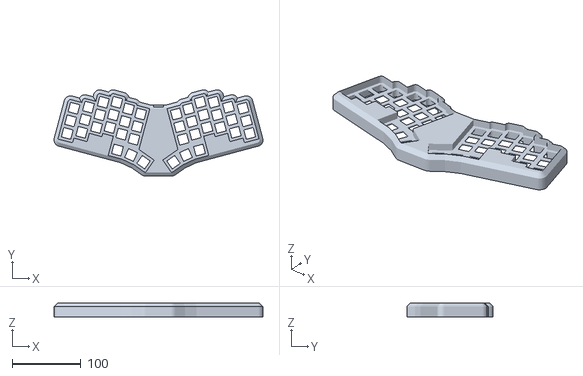
[picture p81: CAD file, 2023-08-10]
keyboards/ffkb/cases/stls/lowpro-chunky/ff-lp-chunky-6-mx-body.stl
304.6 x 125.8 x 20.0
