sadekbaroudi/fingerpunch/keyboards/ffkb/cases/stls/lowpro-led-ring/led-ring-arc-atari.stl

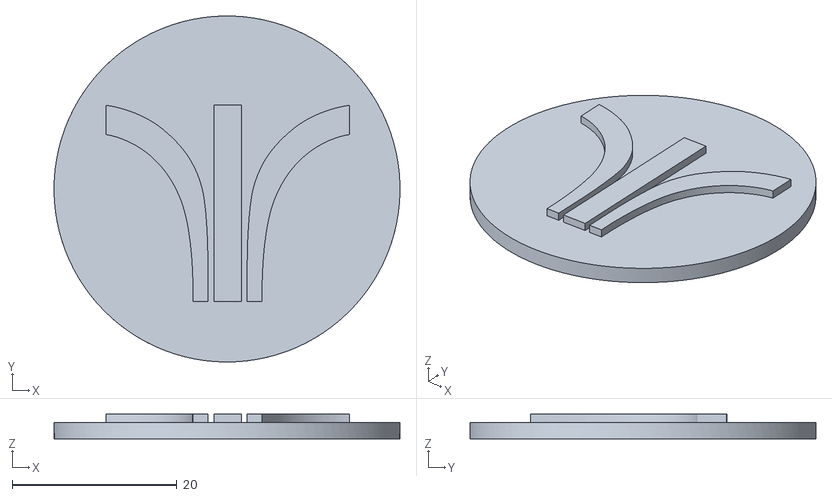
[picture p82: CAD file, 2023-02-23]
keyboards/ffkb/cases/stls/lowpro-led-ring/led-ring-arc-atari.stl
42.0 x 42.0 x 3.00
