sadekbaroudi/fingerpunch/keyboards/ffkb/cases/stls/v4/ff-rp-u3-trackball-cover-tri-exposure.stl

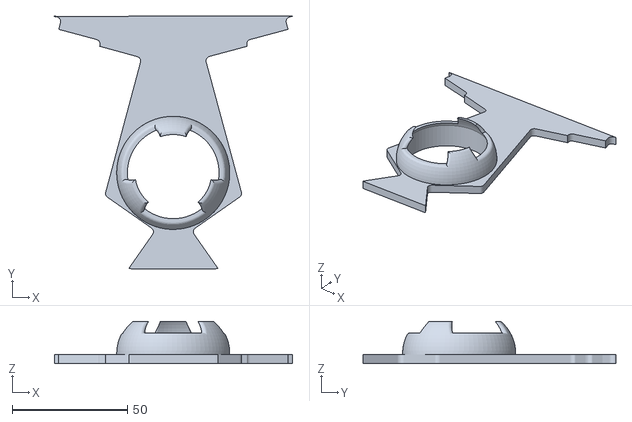
[picture p83: CAD file, 2025-07-31]
keyboards/ffkb/cases/stls/v4/ff-rp-u3-trackball-cover-tri-exposure.stl
103.1 x 109.4 x 18.2
