sadekbaroudi/fingerpunch/keyboards/ffkb/cases/stls/wireless-edition-v1/slim/ffkb-we-slim-5-bot.stl

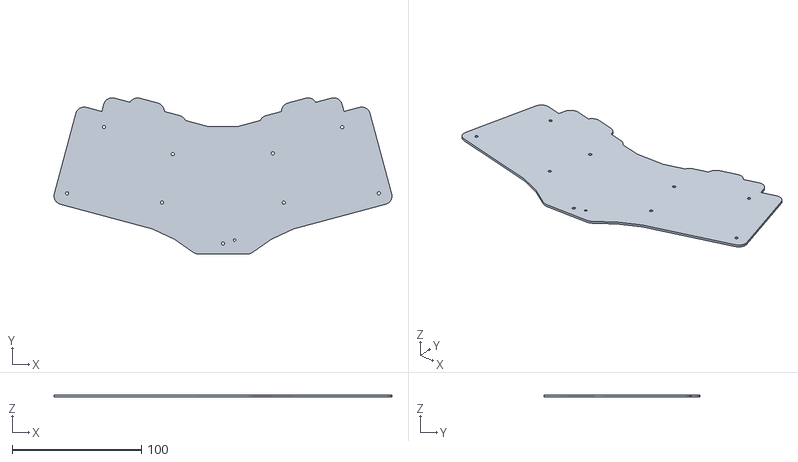
[picture p84: CAD file, 2025-07-29]
keyboards/ffkb/cases/stls/wireless-edition-v1/slim/ffkb-we-slim-5-bot.stl
261.1 x 120.8 x 1.60
