sadekbaroudi/fingerpunch/keyboards/ffkb/cases/stls/wireless-edition-v1/thick/ffkb-wireless-edition-5-flat-bot.stl

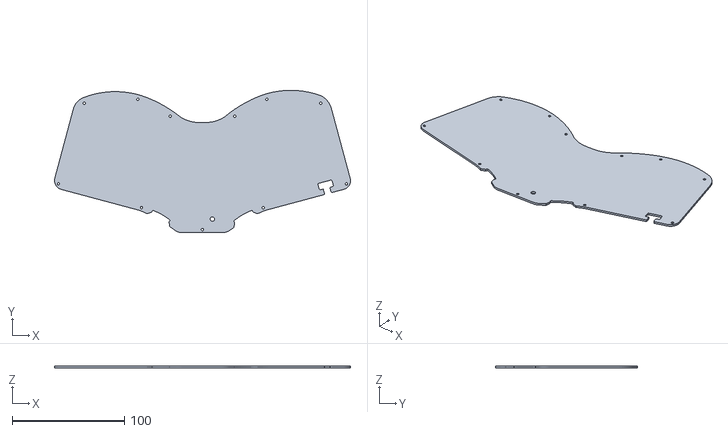
[picture p85: CAD file, 2025-04-09]
keyboards/ffkb/cases/stls/wireless-edition-v1/thick/ffkb-wireless-edition-5-flat-bot.stl
264.1 x 127.0 x 1.60
