sadekbaroudi/fingerpunch/keyboards/ffkb/plates/stl/ffkb-switch-alignment-template.stl

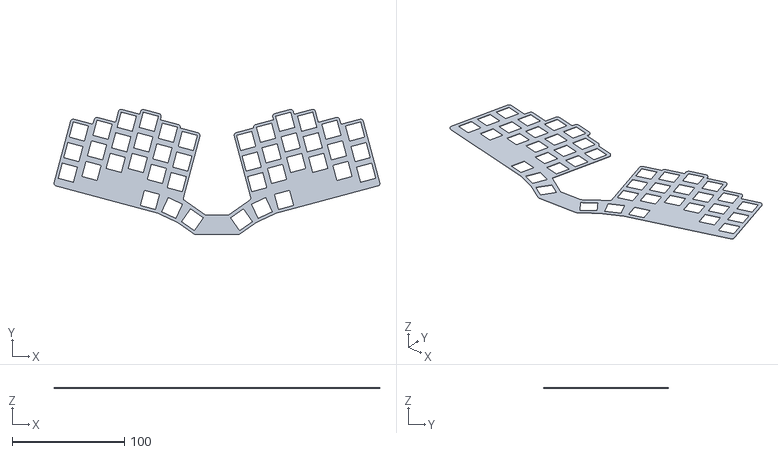
[picture p86: CAD file, 2023-08-05]
keyboards/ffkb/plates/stl/ffkb-switch-alignment-template.stl
290.7 x 111.8 x 1.00
