sadekbaroudi/fingerpunch/keyboards/ffkb/svgs/lite/min-y/ffkb-lite-min-y.dxf

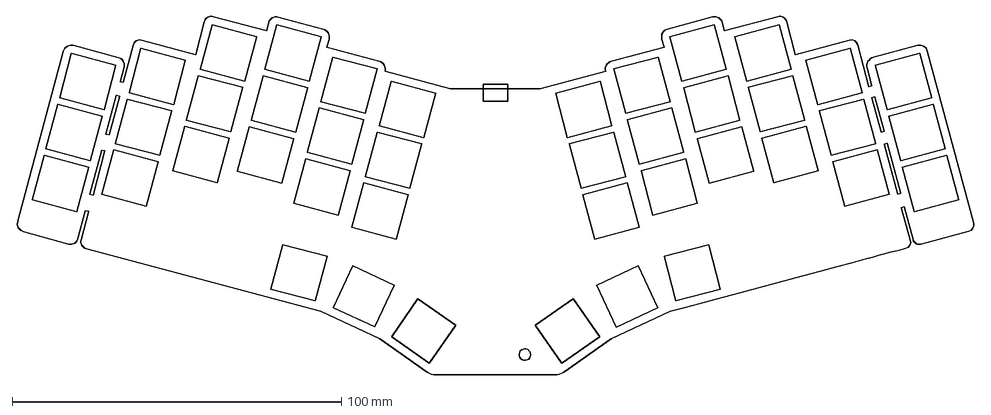
[picture p87: CAD file, 2023-10-03]
keyboards/ffkb/svgs/lite/min-y/ffkb-lite-min-y.dxf
291.2 x 109.0 mm
