sadekbaroudi/fingerpunch/keyboards/ffkb/svgs/v3/ffkb-v3-6col-trackball-template.dxf

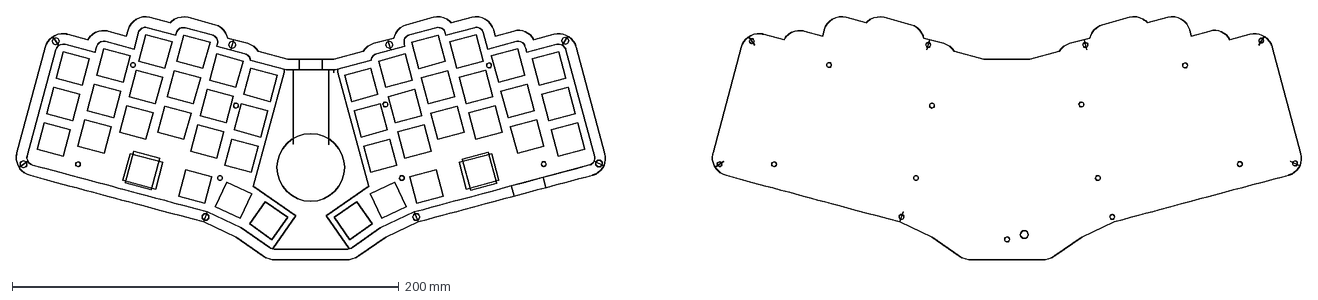
[picture p88: CAD file, 2022-08-30]
keyboards/ffkb/svgs/v3/ffkb-v3-6col-trackball-template.dxf
665.1 x 126.2 mm
