sadekbaroudi/fingerpunch/keyboards/fflx/plates/fflx-ec-c.stl

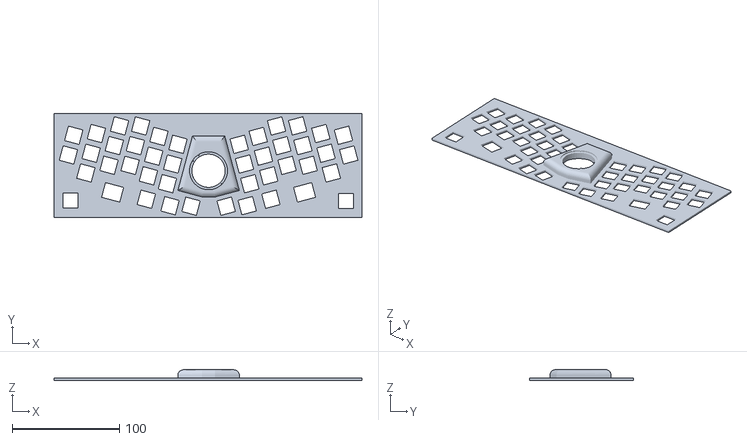
[picture p89: CAD file, 2022-07-11]
keyboards/fflx/plates/fflx-ec-c.stl
287.0 x 96.6 x 10.0
