sadekbaroudi/fingerpunch/keyboards/kucheza/byomcu/cases/kucheza-byomcu-bottom-plate.stl

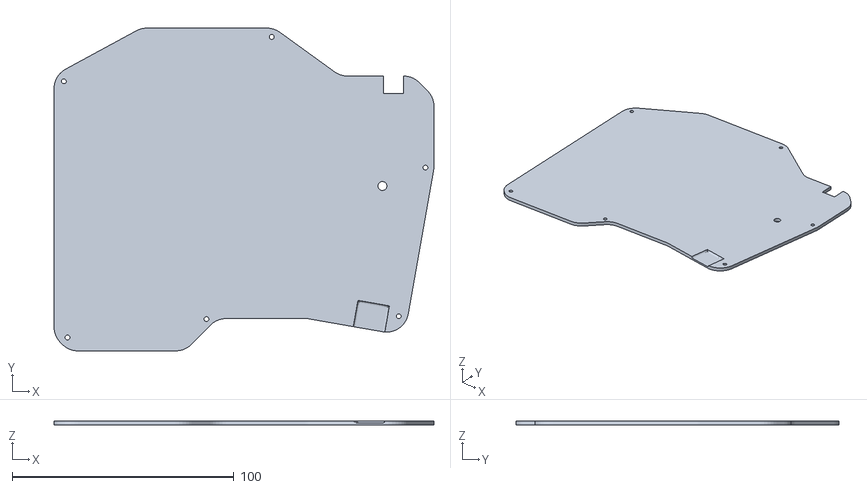
[picture p90: CAD file, 2024-09-01]
keyboards/kucheza/byomcu/cases/kucheza-byomcu-bottom-plate.stl
171.4 x 145.6 x 2.00
