sadekbaroudi/fingerpunch/keyboards/kucheza/v1/cases/kucheza-diffused-led-window.stl

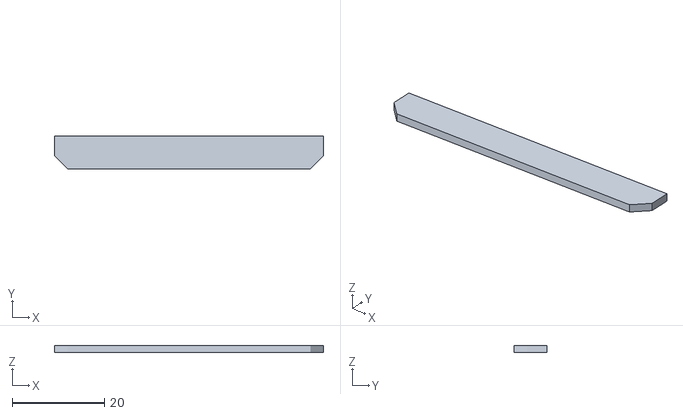
[picture p91: CAD file, 2024-03-11]
keyboards/kucheza/v1/cases/kucheza-diffused-led-window.stl
58.3 x 7.19 x 1.50
