sadekbaroudi/fingerpunch/keyboards/luakeeb/cases/5-column/bottom-plate.3mf

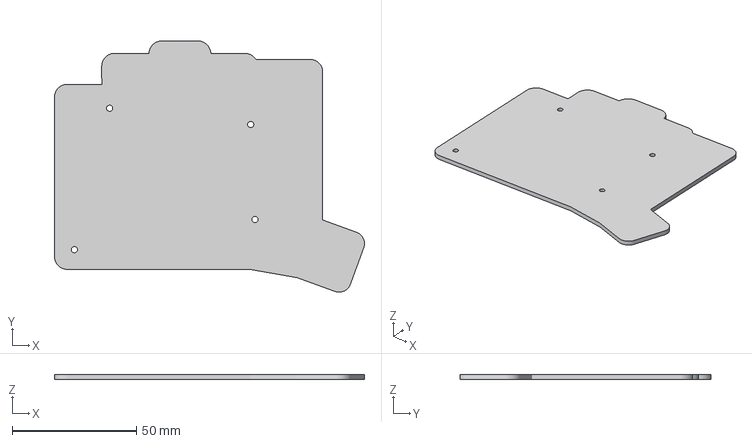
[picture p92: CAD file, 2022-11-08]
keyboards/luakeeb/cases/5-column/bottom-plate.3mf
124.8 x 101.2 x 2.00 mm
