sadekbaroudi/fingerpunch/keyboards/luakeeb/cases/6-column/bottom-plate-hp.stl

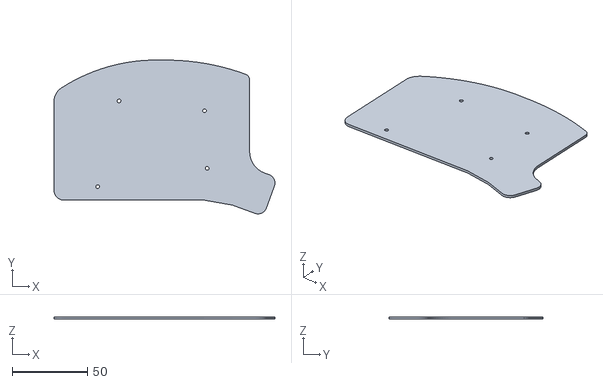
[picture p93: CAD file, 2023-03-28]
keyboards/luakeeb/cases/6-column/bottom-plate-hp.stl
146.9 x 102.2 x 1.60
