sadekbaroudi/fingerpunch/keyboards/personal/zazu/scroll-ring-for-fingerpunch-trackball-housing.stl

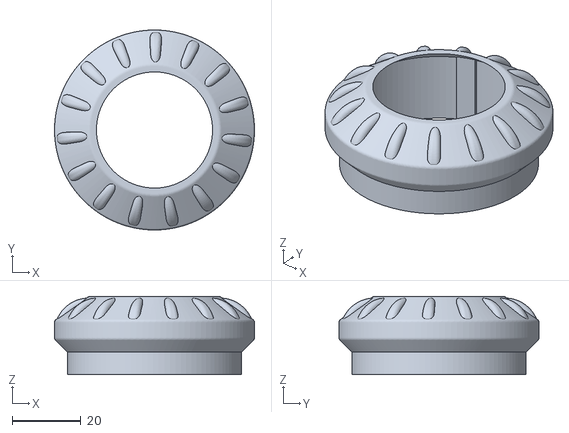
[picture p94: CAD file, 2023-01-24]
keyboards/personal/zazu/scroll-ring-for-fingerpunch-trackball-housing.stl
58.0 x 58.0 x 22.7
