sadekbaroudi/fingerpunch/keyboards/pinkies-out/cases/v3/po-v3-mx-body-non-modular-vik-blank-evq.stl

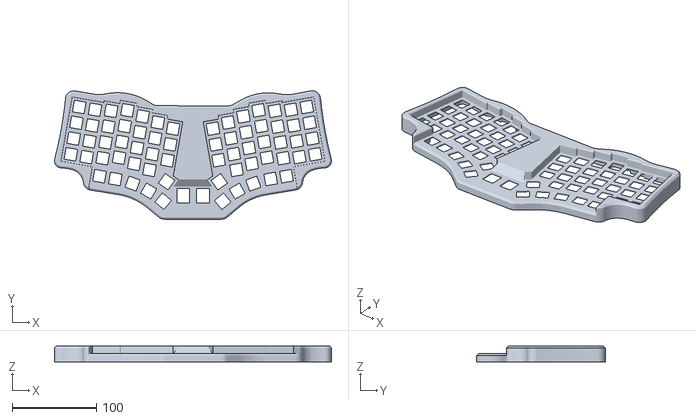
[picture p95: CAD file, 2024-08-30]
keyboards/pinkies-out/cases/v3/po-v3-mx-body-non-modular-vik-blank-evq.stl
328.5 x 152.4 x 18.6
