sadekbaroudi/fingerpunch/keyboards/pinkies-out/plates/modular-models/pinkies-out-v3-cirque-attachement-no-evq.stl

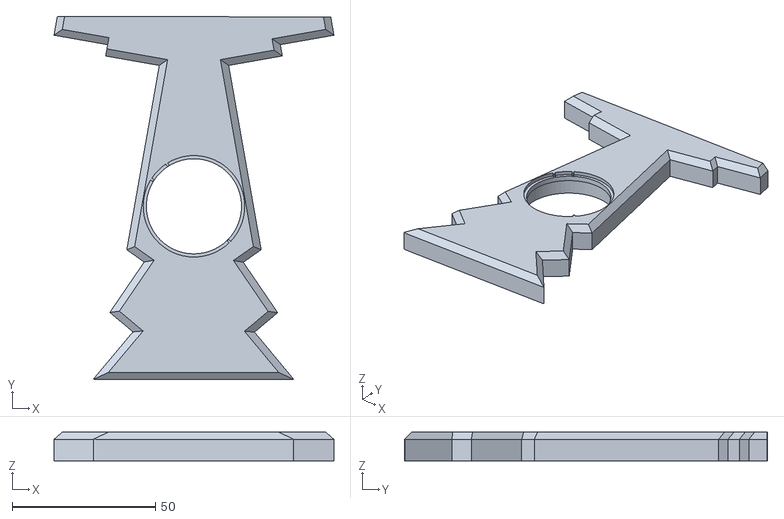
[picture p96: CAD file, 2024-11-18]
keyboards/pinkies-out/plates/modular-models/pinkies-out-v3-cirque-attachement-no-evq.stl
97.7 x 126.7 x 10.0
