sadekbaroudi/fingerpunch/keyboards/pinkies-out/plates/v3/pinkiesout-v3-bottom-plate-with-4mm-spacer-choc-border.stl

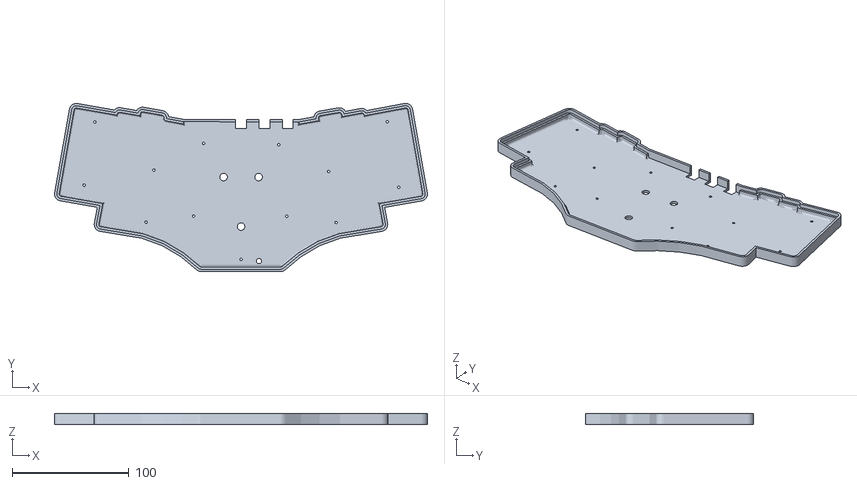
[picture p97: CAD file, 2024-06-27]
keyboards/pinkies-out/plates/v3/pinkiesout-v3-bottom-plate-with-4mm-spacer-choc-border.stl
320.0 x 144.4 x 9.25
