sadekbaroudi/fingerpunch/keyboards/rock-on/cases/stl/v3/high-pro-rectangular/ro-h3-cir-rectangular-bottom.stl

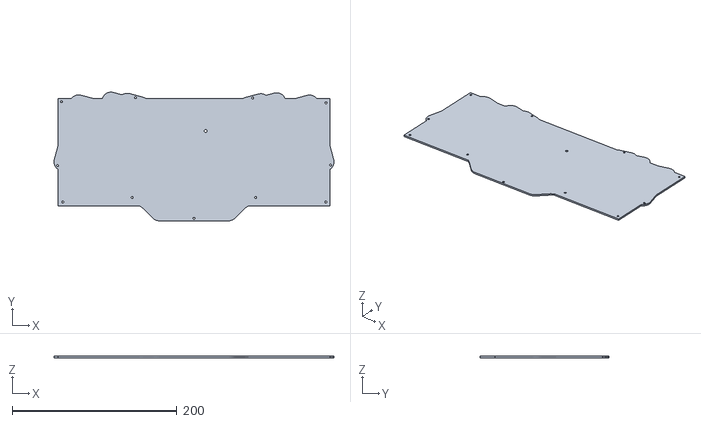
[picture p98: CAD file, 2023-05-16]
keyboards/rock-on/cases/stl/v3/high-pro-rectangular/ro-h3-cir-rectangular-bottom.stl
340.1 x 156.4 x 2.00
