sadekbaroudi/fingerpunch/keyboards/rock-on/cases/stl/v3/high-pro/ro-h3-mx-6-deg-tent-no-standoffs-bottom-plate.stl

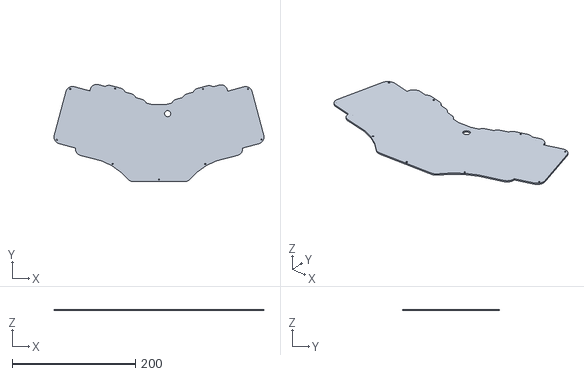
[picture p99: CAD file, 2025-02-07]
keyboards/rock-on/cases/stl/v3/high-pro/ro-h3-mx-6-deg-tent-no-standoffs-bottom-plate.stl
340.2 x 157.4 x 2.00
