sadekbaroudi/fingerpunch/keyboards/rock-on/cases/stl/v3/low-pro-rectangular/ro-v2-v3-choc-cirque-rectangular.step

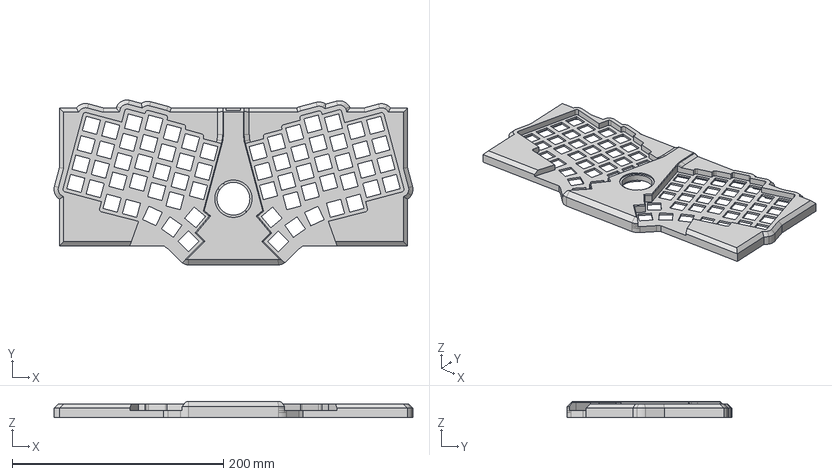
[picture p100: CAD file, 2024-09-30]
keyboards/rock-on/cases/stl/v3/low-pro-rectangular/ro-v2-v3-choc-cirque-rectangular.step
340.2 x 156.4 x 15.5 mm
