sadekbaroudi/fingerpunch/keyboards/rock-on/v3/svgs/v3-template.dxf

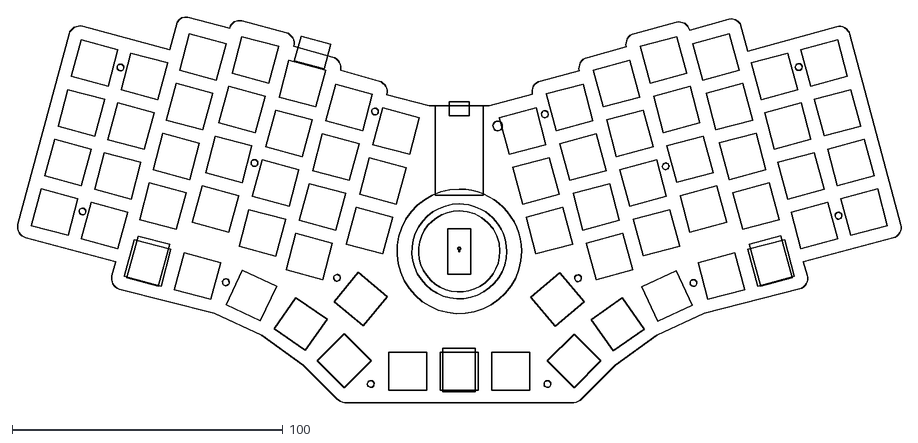
[picture p103: CAD file, 2022-12-26]
keyboards/rock-on/v3/svgs/v3-template.dxf
326.8 x 142.6
