sadekbaroudi/fingerpunch/keyboards/stenographobe/cases/stenographobe-plate-choc.stl

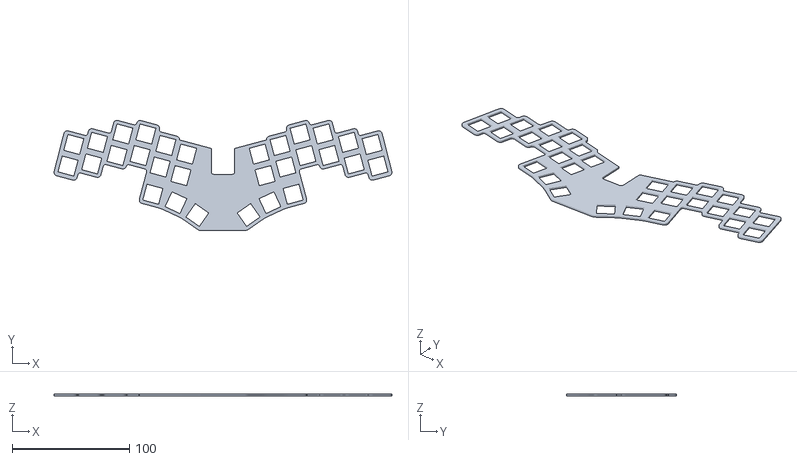
[picture p104: CAD file, 2023-03-20]
keyboards/stenographobe/cases/stenographobe-plate-choc.stl
288.0 x 93.9 x 1.60
