sadekbaroudi/fingerpunch/keyboards/tenbit/cases/v1/tenbit-5x12-bot.stl

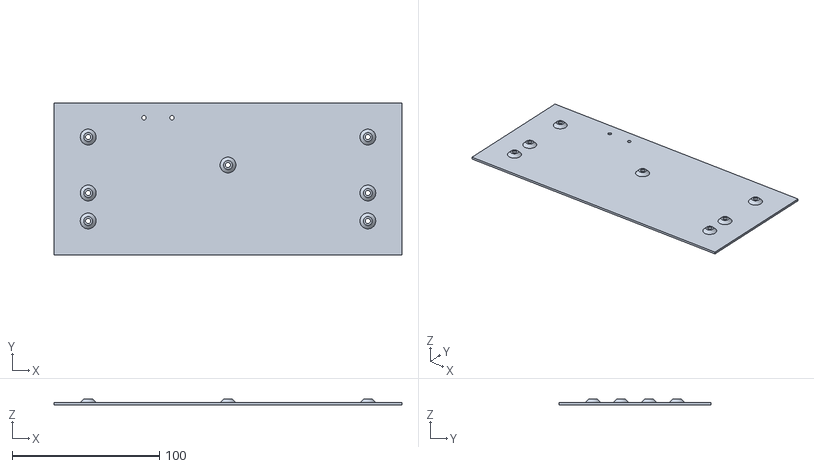
[picture p105: CAD file, 2024-02-01]
keyboards/tenbit/cases/v1/tenbit-5x12-bot.stl
236.4 x 103.4 x 4.00
