sadekbaroudi/fingerpunch/keyboards/vikropad/cases/choc-glp/vikropad-choc-glp-body.stl

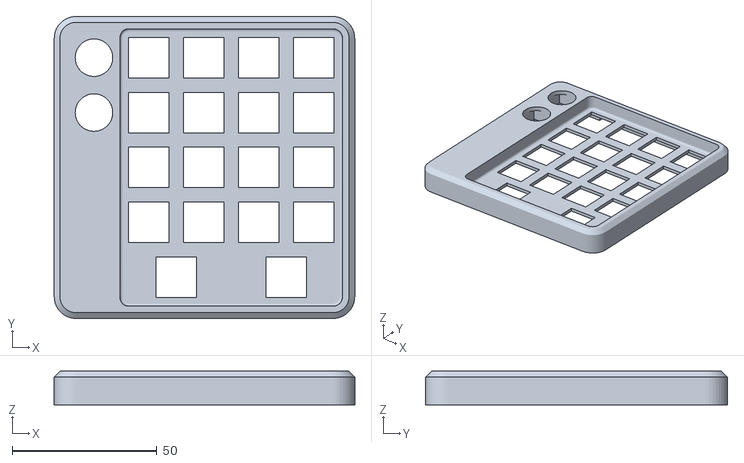
[picture p106: CAD file, 2024-05-06]
keyboards/vikropad/cases/choc-glp/vikropad-choc-glp-body.stl
104.0 x 104.5 x 11.6
