sadekbaroudi/fingerpunch/keyboards/vulpes-majora/v1/cases/stl/vmaj-5-mx-uni-tps65-5w-3wt.stl

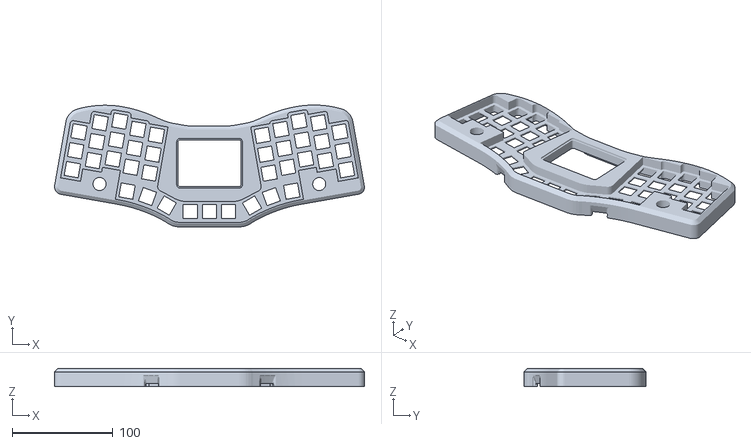
[picture p107: CAD file, 2023-11-09]
keyboards/vulpes-majora/v1/cases/stl/vmaj-5-mx-uni-tps65-5w-3wt.stl
307.0 x 120.8 x 18.0
