sadekbaroudi/fingerpunch/keyboards/ximega/v1/cases/ximega-base.stl

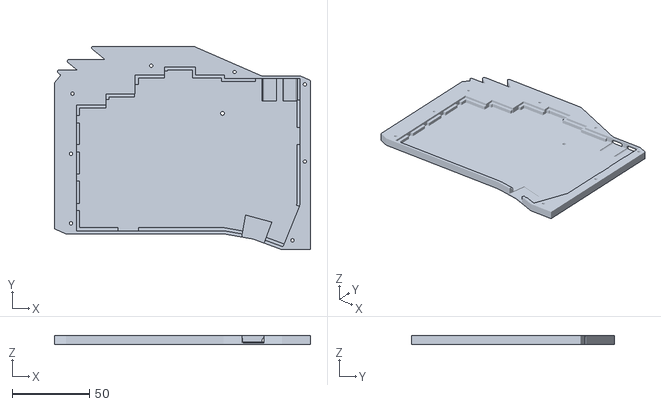
[picture p108: CAD file, 2024-07-24]
keyboards/ximega/v1/cases/ximega-base.stl
165.8 x 131.8 x 5.60
