sadekbaroudi/fingerpunch/keyboards/ximi/beta/cases/stl/xi-6-np-bot.stl

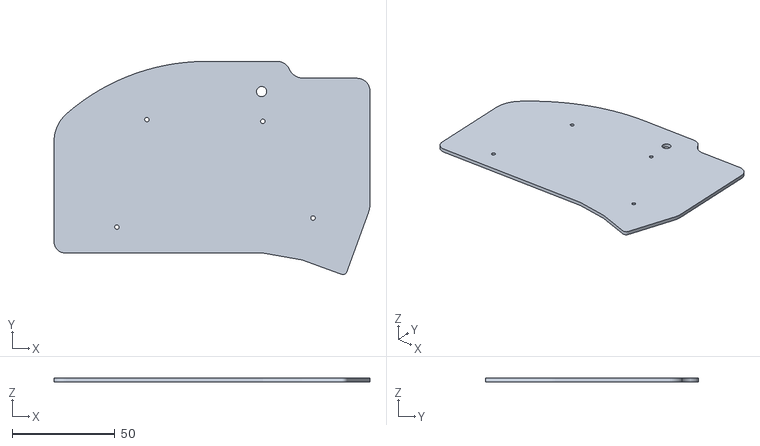
[picture p109: CAD file, 2023-08-06]
keyboards/ximi/beta/cases/stl/xi-6-np-bot.stl
153.7 x 103.7 x 2.00
