sadekbaroudi/fingerpunch/keyboards/ximi/v2/cases/xi-6-mx-ec-vik-waveshare-22224-3wt-left.stl

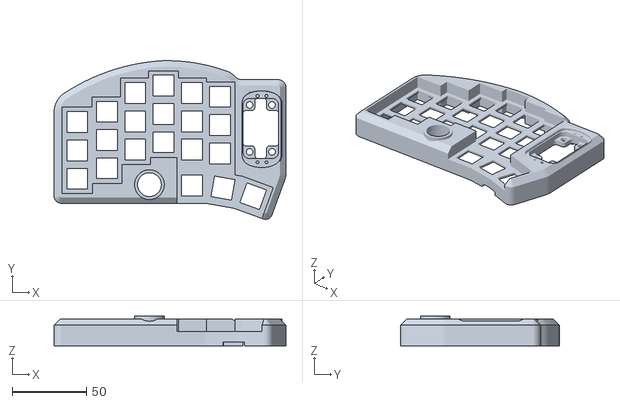
[picture p110: CAD file, 2024-05-18]
keyboards/ximi/v2/cases/xi-6-mx-ec-vik-waveshare-22224-3wt-left.stl
155.9 x 106.6 x 20.0
