sadekbaroudi/fingerpunch/keycaps/CMY/12-degree-flat-ends/CMY-MX-R2-R4.stl

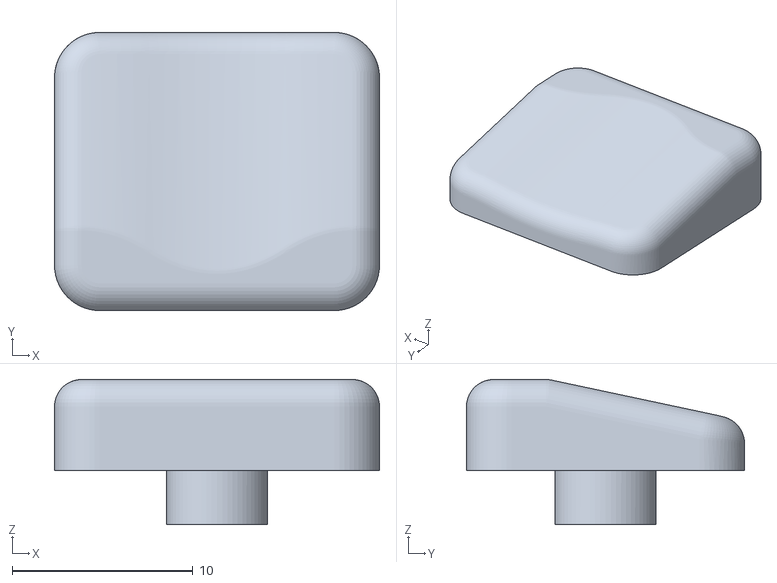
[picture p111: CAD file, 2024-02-02]
keycaps/CMY/12-degree-flat-ends/CMY-MX-R2-R4.stl
18.0 x 15.4 x 8.03
