sadekbaroudi/fingerpunch/keycaps/CMY/12-degree/CMY-MX-R3.stl

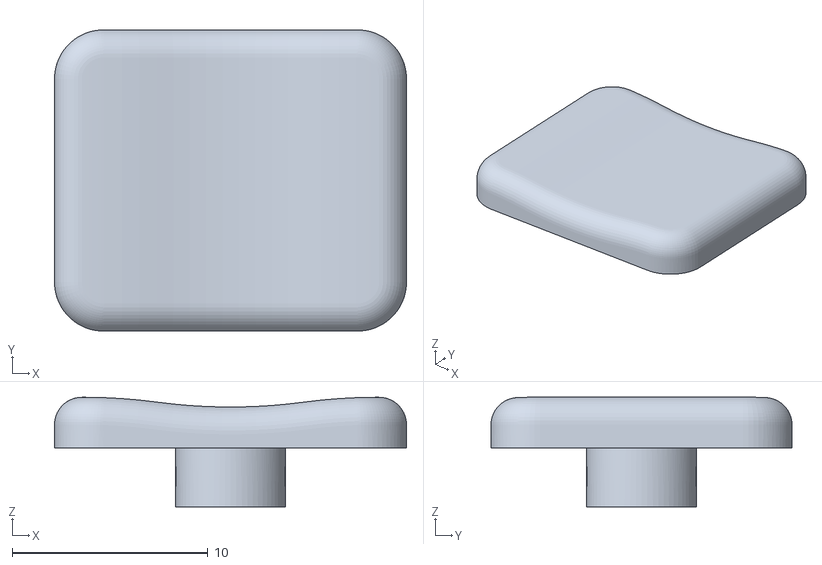
[picture p112: CAD file, 2024-02-02]
keycaps/CMY/12-degree/CMY-MX-R3.stl
18.0 x 15.4 x 5.60
