sadekbaroudi/fingerpunch/keycaps/CMY/other/CMY-MX-2U-2POS.stl

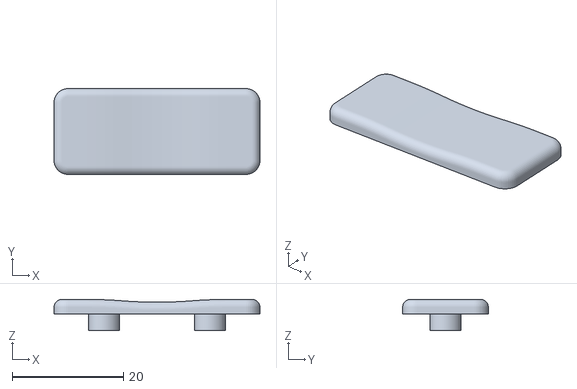
[picture p114: CAD file, 2024-02-02]
keycaps/CMY/other/CMY-MX-2U-2POS.stl
37.0 x 15.4 x 5.60
