sadekbaroudi/fingerpunch/keycaps/CMY/sculpted-thumbs/CMY-MX-thumb-tilt-R.stl

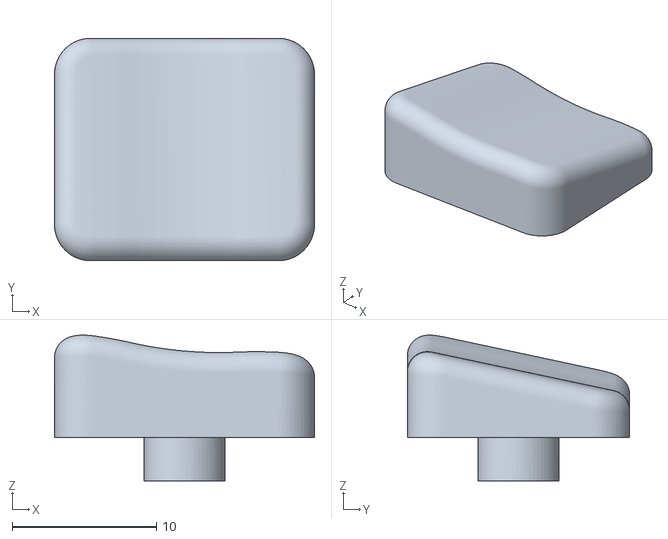
[picture p115: CAD file, 2024-02-02]
keycaps/CMY/sculpted-thumbs/CMY-MX-thumb-tilt-R.stl
18.0 x 15.4 x 10.1
