sadekbaroudi/fingerpunch/kicad/step/HRO_TYPE-C-31-M-12.step

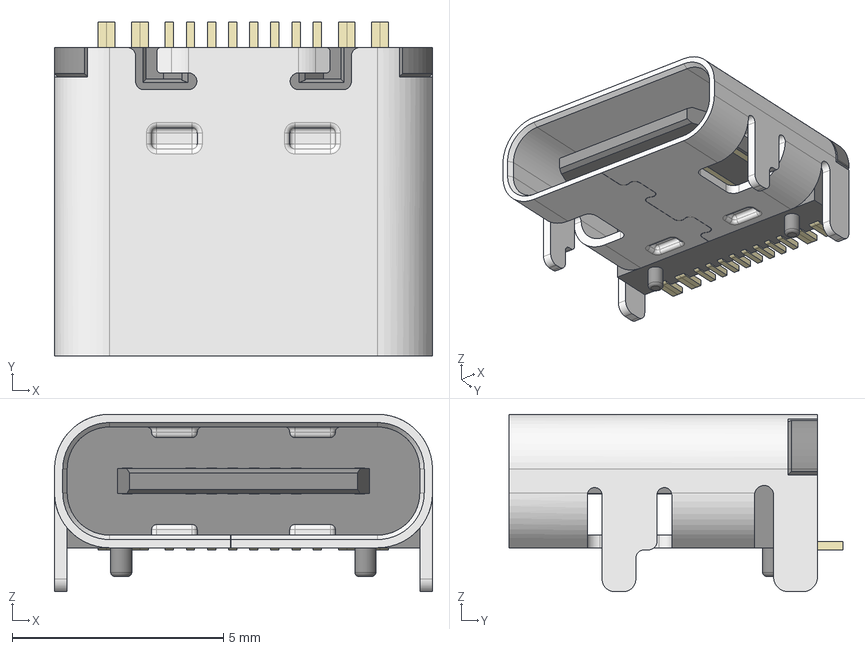
[picture p116: CAD file, 2023-12-05]
kicad/step/HRO_TYPE-C-31-M-12.step
8.95 x 7.90 x 4.20 mm
