sadekbaroudi/fingerpunch/3d-models/5-way-tactile-switch-knobs/5-way-mushroom-directional.step

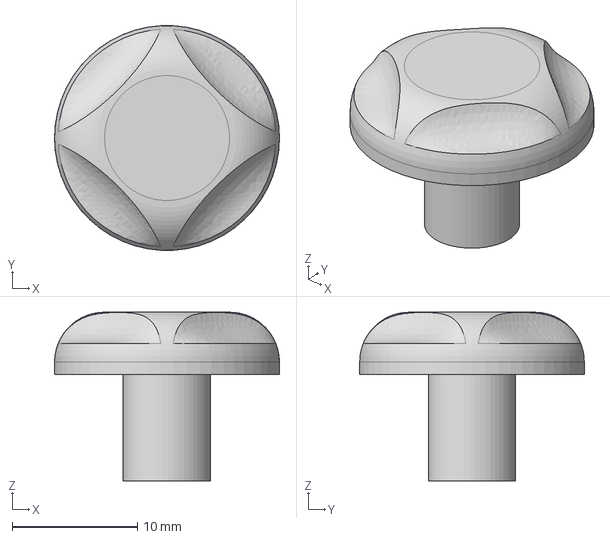
[picture p117: CAD file, 2024-04-17]
3d-models/5-way-tactile-switch-knobs/5-way-mushroom-directional.step
18.0 x 18.0 x 13.5 mm
