sadekbaroudi/fingerpunch/3d-models/display-housings/ili9341/ili9341-4inch-cover.step

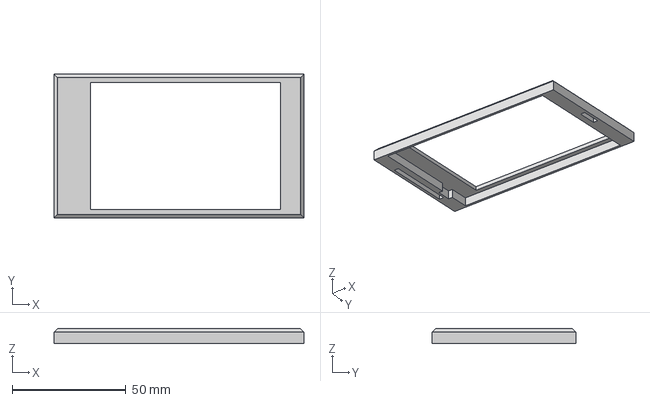
[picture p118: CAD file, 2024-06-14]
3d-models/display-housings/ili9341/ili9341-4inch-cover.step
110.0 x 63.3 x 6.40 mm
