sadekbaroudi/fingerpunch/3d-models/ec11-knobs/D/bulb-6.1mm.stl

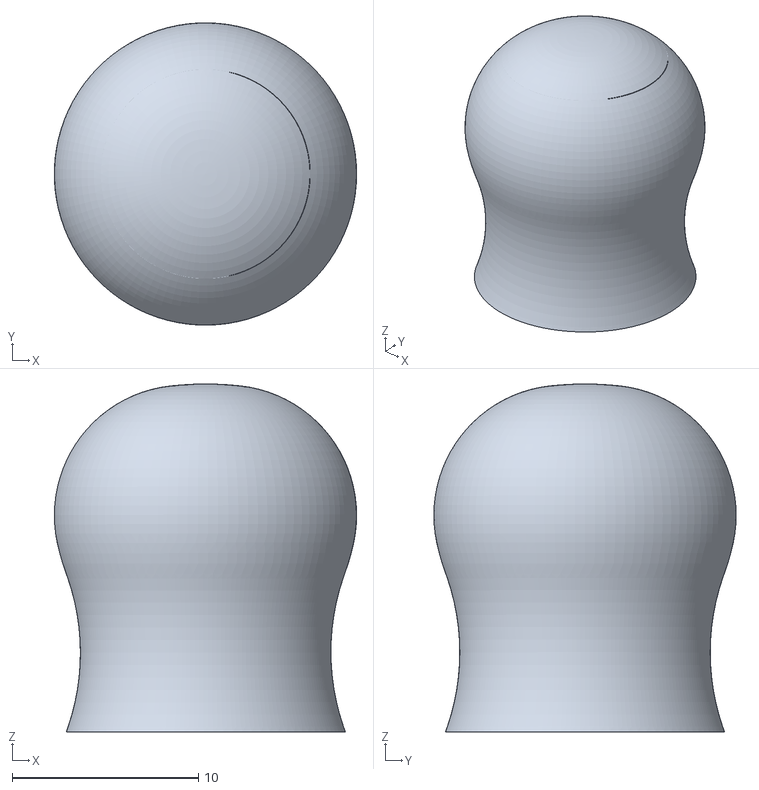
[picture p119: CAD file, 2023-10-12]
3d-models/ec11-knobs/D/bulb-6.1mm.stl
16.2 x 16.2 x 18.7
