sadekbaroudi/fingerpunch/3d-models/per56-trackball/34mm/per56-34mm-trackball-housing-4mm-bearings.stl

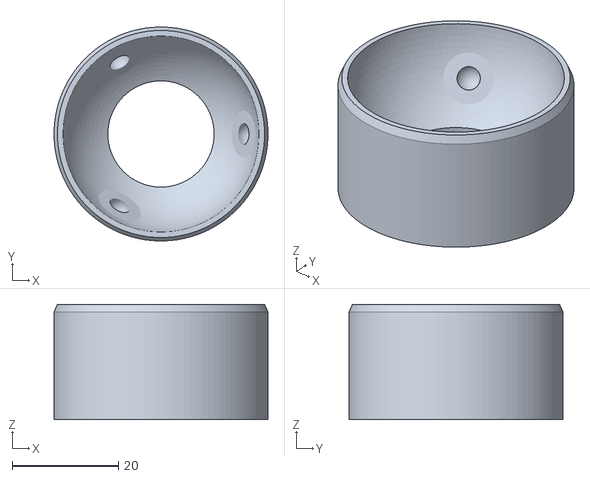
[picture p120: CAD file, 2023-10-06]
3d-models/per56-trackball/34mm/per56-34mm-trackball-housing-4mm-bearings.stl
40.3 x 40.3 x 21.7
