sadekbaroudi/fingerpunch/3d-models/per56-trackball/38mm/per56-38mm-trackball-cover.stl

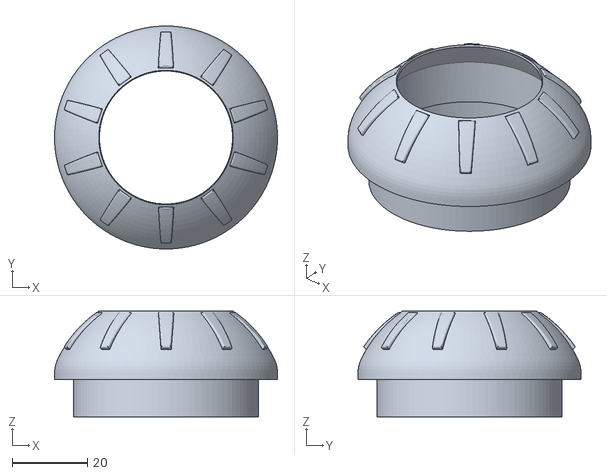
[picture p121: CAD file, 2023-09-24]
3d-models/per56-trackball/38mm/per56-38mm-trackball-cover.stl
59.1 x 59.1 x 28.0
