sadekbaroudi/fingerpunch/3d-models/trackball-thumb-helmet/trackball-thumb-helmet-vik-controller-optional-battery-backpack-w-switch-cutouts.stl

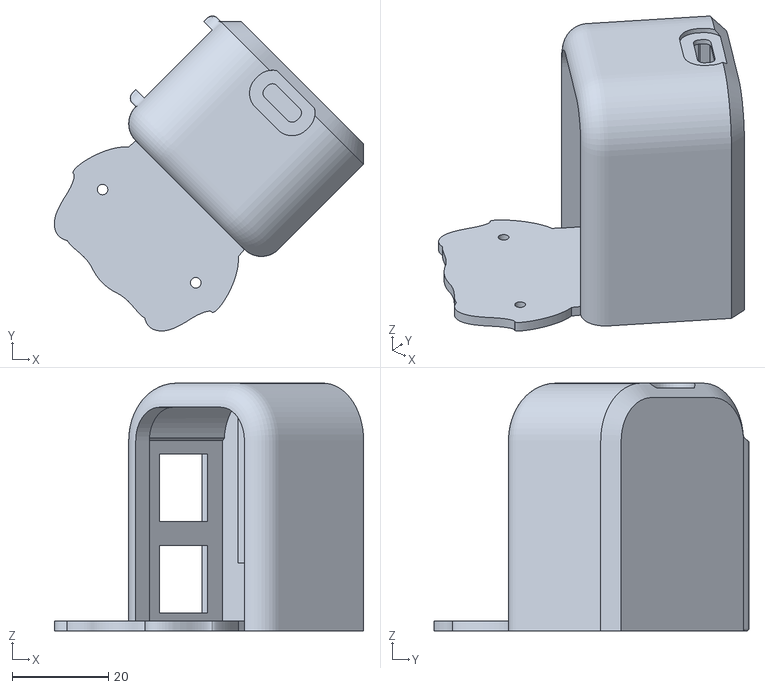
[picture p123: CAD file, 2024-05-13]
3d-models/trackball-thumb-helmet/trackball-thumb-helmet-vik-controller-optional-battery-backpack-w-switch-cutouts.stl
64.2 x 65.4 x 51.4
