sadekbaroudi/fingerpunch/3d-models/trackpoint/trackpoint-cover-labret-5Dx3Hx3mmCutout.stl

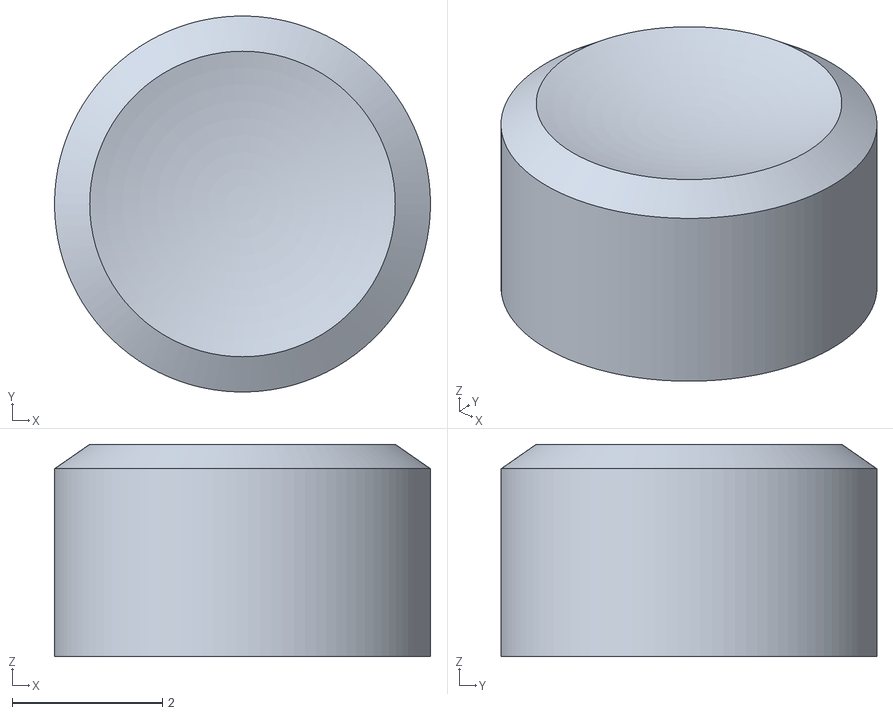
[picture p124: CAD file, 2024-02-26]
3d-models/trackpoint/trackpoint-cover-labret-5Dx3Hx3mmCutout.stl
5.00 x 5.00 x 2.83
