sadekbaroudi/fingerpunch/keyboards/euclid36/cases/euclid36-7deg-tent-bottom-plate.stl

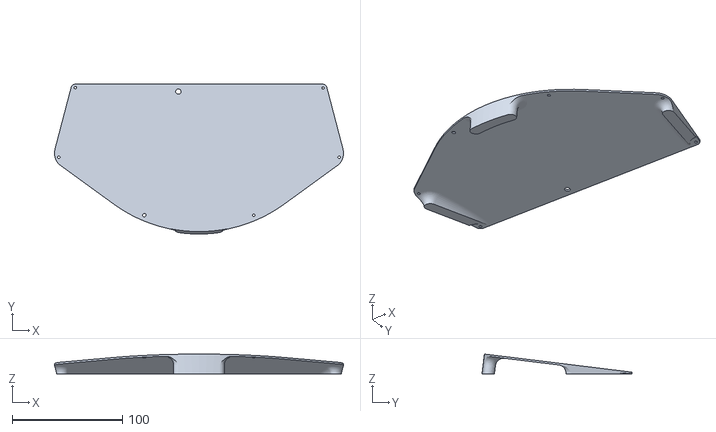
[picture p125: CAD file, 2023-04-27]
keyboards/euclid36/cases/euclid36-7deg-tent-bottom-plate.stl
262.2 x 136.2 x 18.0
