sadekbaroudi/fingerpunch/keyboards/ffkb/cases/modular-plates/stls/ffkb-fr4-modular-trackball-cover.stl

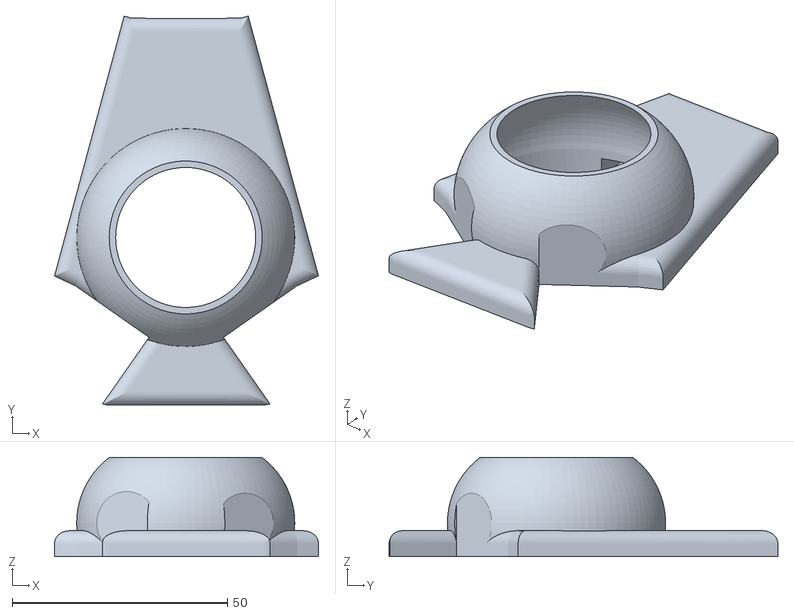
[picture p126: CAD file, 2022-09-06]
keyboards/ffkb/cases/modular-plates/stls/ffkb-fr4-modular-trackball-cover.stl
61.3 x 90.3 x 23.0
