sadekbaroudi/fingerpunch/keyboards/ffkb/cases/stls/encoder-addons/encoder-plug-v2.stl

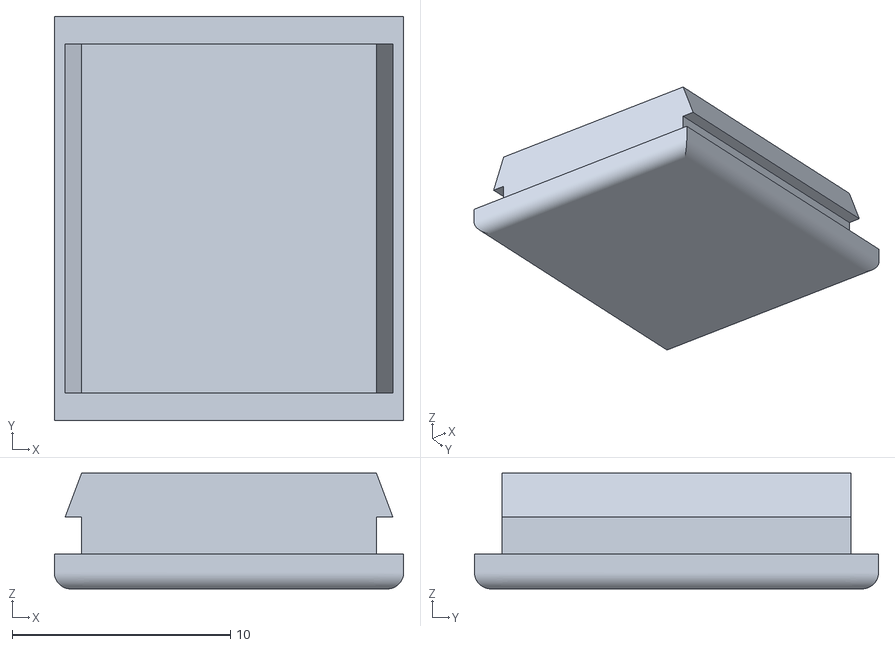
[picture p127: CAD file, 2022-08-29]
keyboards/ffkb/cases/stls/encoder-addons/encoder-plug-v2.stl
16.0 x 18.5 x 5.30
