sadekbaroudi/fingerpunch/keyboards/ffkb/cases/stls/holyiot/ffkb-holyiot-6-mx-ec-LR-body.stl

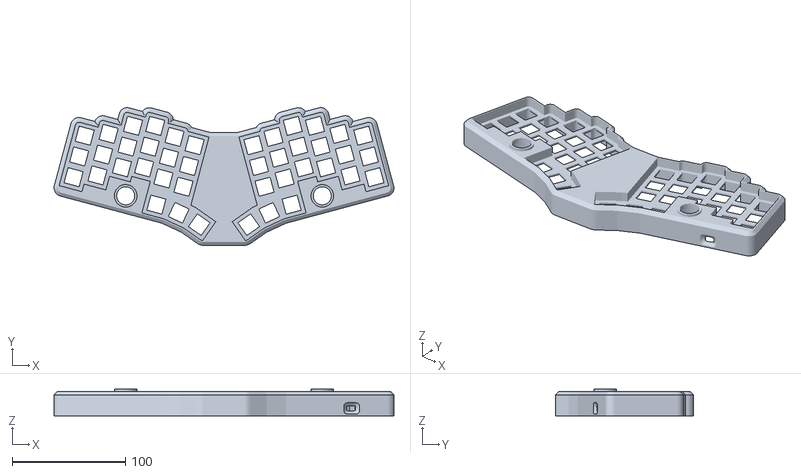
[picture p128: CAD file, 2024-04-29]
keyboards/ffkb/cases/stls/holyiot/ffkb-holyiot-6-mx-ec-LR-body.stl
300.7 x 121.8 x 23.6
