sadekbaroudi/fingerpunch/keyboards/ffkb/cases/stls/lite/min-y/ffkb-LMY-6-mx-solenoid-25mm-tr.stl

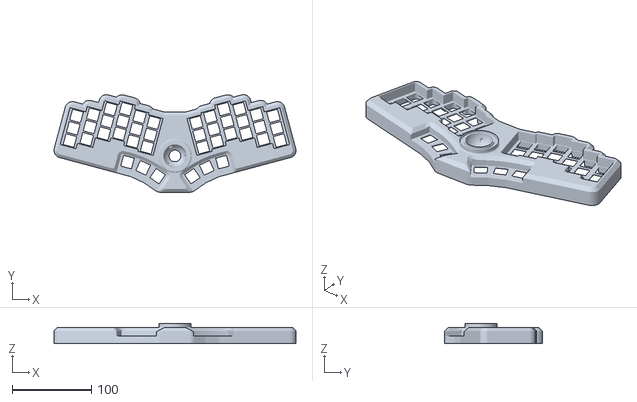
[picture p129: CAD file, 2024-06-04]
keyboards/ffkb/cases/stls/lite/min-y/ffkb-LMY-6-mx-solenoid-25mm-tr.stl
304.6 x 122.9 x 25.5
