sadekbaroudi/fingerpunch/keyboards/ffkb/cases/stls/lite/standard/ffkb-lite-mx-5-solenoid-body.stl

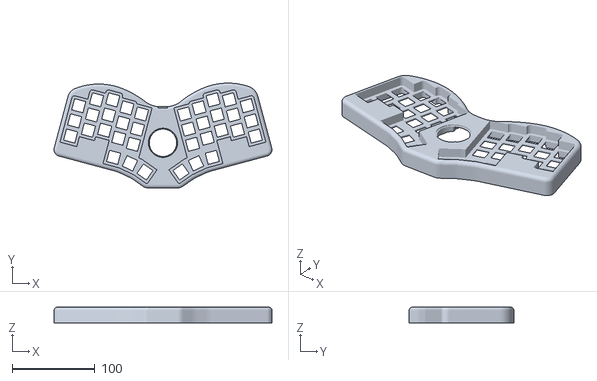
[picture p130: CAD file, 2024-06-13]
keyboards/ffkb/cases/stls/lite/standard/ffkb-lite-mx-5-solenoid-body.stl
264.1 x 127.0 x 19.0
