sadekbaroudi/fingerpunch/keyboards/ffkb/cases/stls/lowpro-chunky/ff-lp-chunky-5-mx-body.stl

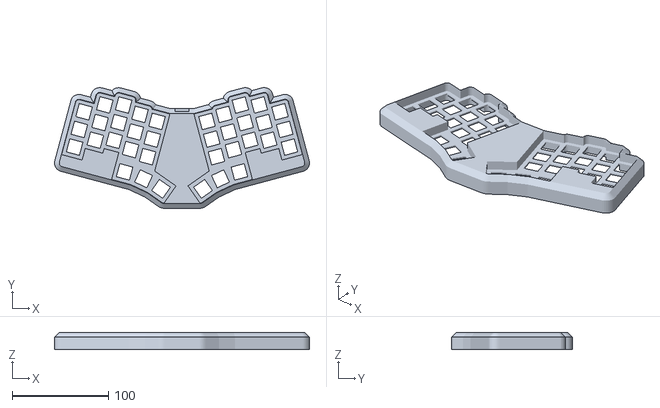
[picture p131: CAD file, 2023-08-10]
keyboards/ffkb/cases/stls/lowpro-chunky/ff-lp-chunky-5-mx-body.stl
265.6 x 125.8 x 18.0
