sadekbaroudi/fingerpunch/keyboards/ffkb/cases/stls/lowpro-led-ring/led-ring-cover-storytel.stl

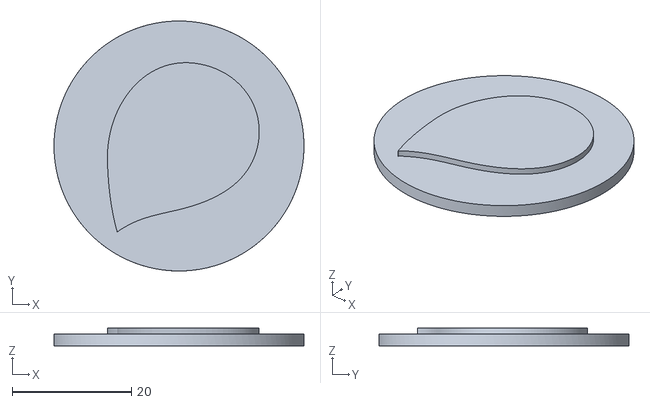
[picture p132: CAD file, 2023-02-22]
keyboards/ffkb/cases/stls/lowpro-led-ring/led-ring-cover-storytel.stl
42.0 x 42.0 x 3.00
