sadekbaroudi/fingerpunch/keyboards/ffkb/cases/stls/v4/ff-rp-u3-choc-6-c-ev-lowpro-2.stl

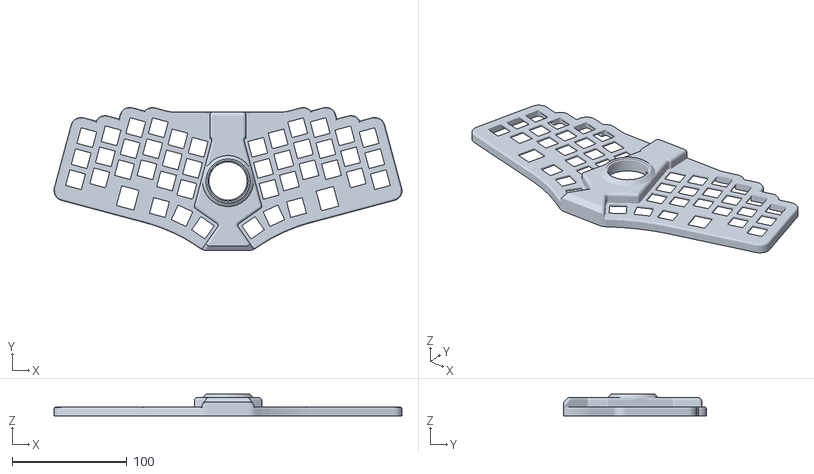
[picture p133: CAD file, 2024-07-06]
keyboards/ffkb/cases/stls/v4/ff-rp-u3-choc-6-c-ev-lowpro-2.stl
303.7 x 124.8 x 19.1
