sadekbaroudi/fingerpunch/keyboards/ffkb/cases/stls/wireless-edition-v1/slim/ffkb-we-slim-6-bot.stl

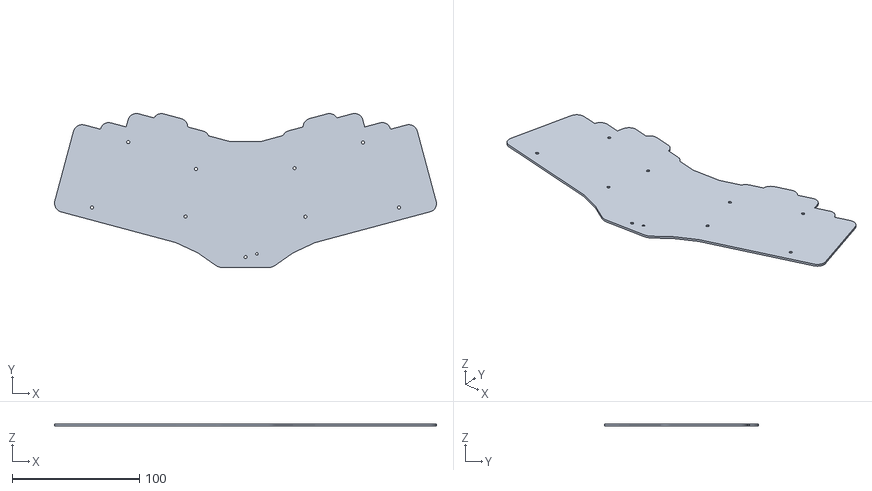
[picture p134: CAD file, 2025-07-29]
keyboards/ffkb/cases/stls/wireless-edition-v1/slim/ffkb-we-slim-6-bot.stl
299.7 x 120.8 x 1.60
