sadekbaroudi/fingerpunch/keyboards/ffkb/cases/stls/wireless-edition-v1/thick/ffkb-wireless-edition-6-flat-bot.stl

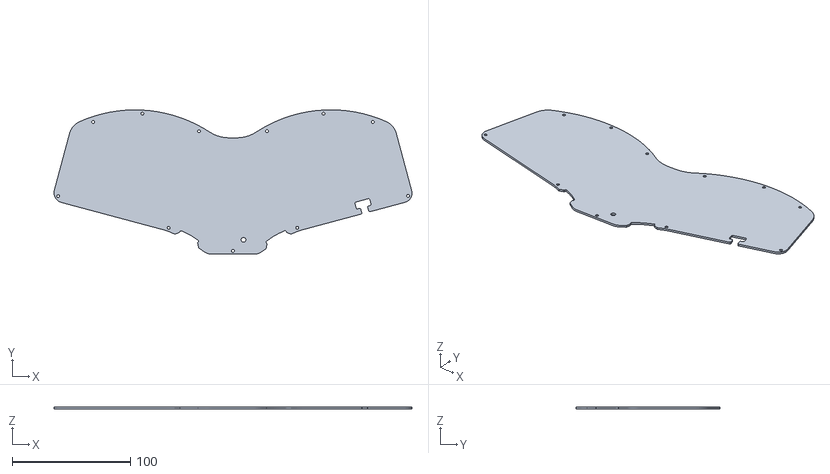
[picture p135: CAD file, 2025-04-09]
keyboards/ffkb/cases/stls/wireless-edition-v1/thick/ffkb-wireless-edition-6-flat-bot.stl
302.6 x 122.0 x 1.60
