sadekbaroudi/fingerpunch/keyboards/ffkb/plates/stl/ffkb-topmount-switchplate-5col-EC11x2.stl

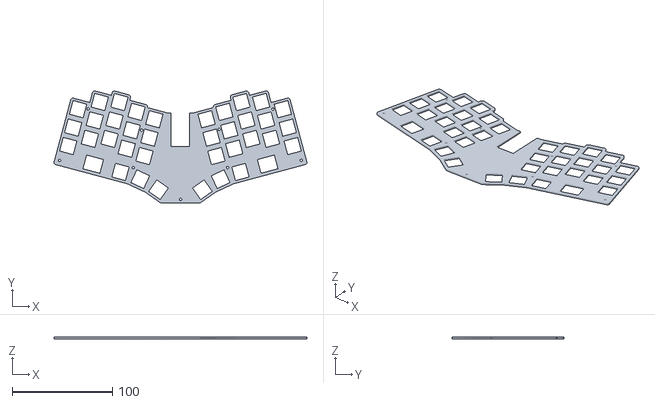
[picture p136: CAD file, 2022-12-23]
keyboards/ffkb/plates/stl/ffkb-topmount-switchplate-5col-EC11x2.stl
252.2 x 111.8 x 1.60
