sadekbaroudi/fingerpunch/keyboards/fflx/plates/fflx-ev.stl

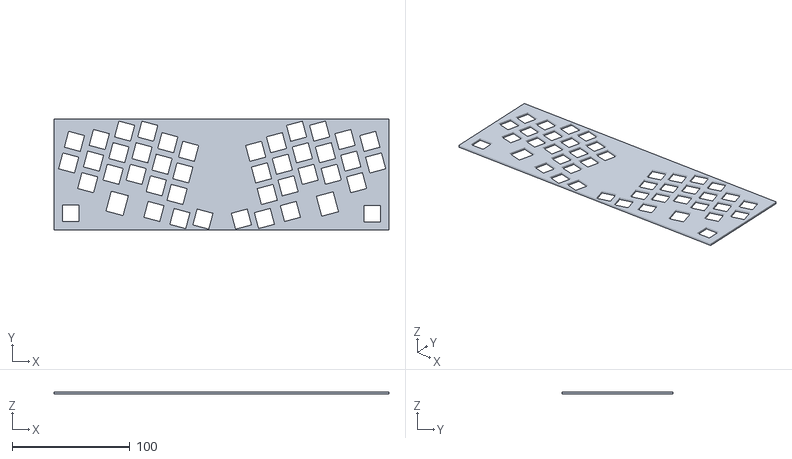
[picture p137: CAD file, 2022-07-11]
keyboards/fflx/plates/fflx-ev.stl
285.0 x 94.6 x 2.00
