sadekbaroudi/fingerpunch/keyboards/kucheza/byomcu/cases/kucheza-byomcu-choc-body-3wt-5way-trrs-wireless.stl

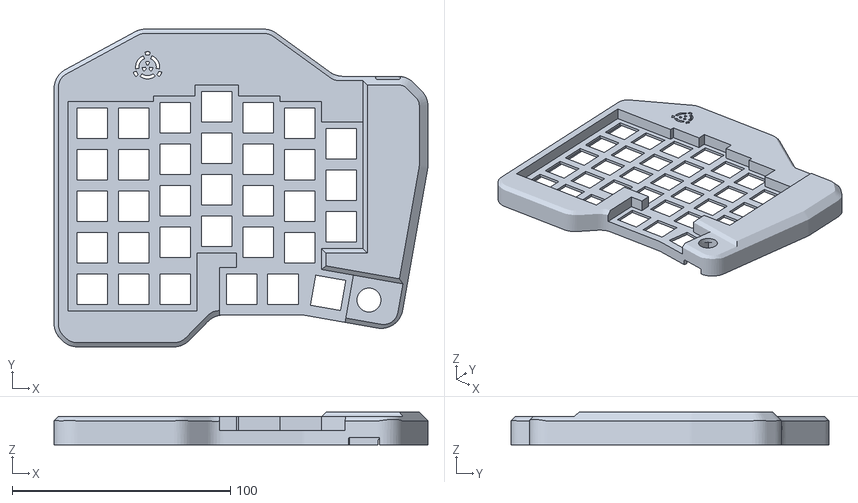
[picture p138: CAD file, 2024-09-01]
keyboards/kucheza/byomcu/cases/kucheza-byomcu-choc-body-3wt-5way-trrs-wireless.stl
171.4 x 145.6 x 15.0
