sadekbaroudi/fingerpunch/keyboards/kucheza/v1/cases/kucheza-choc-body-3wt-5way-trrs-diffused-leds.stl

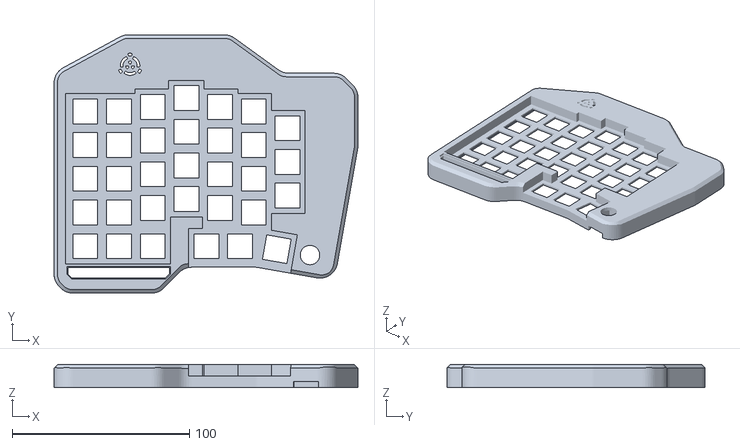
[picture p139: CAD file, 2024-03-11]
keyboards/kucheza/v1/cases/kucheza-choc-body-3wt-5way-trrs-diffused-leds.stl
171.4 x 145.6 x 13.0
