sadekbaroudi/fingerpunch/keyboards/luakeeb/cases/5-column/body.3mf

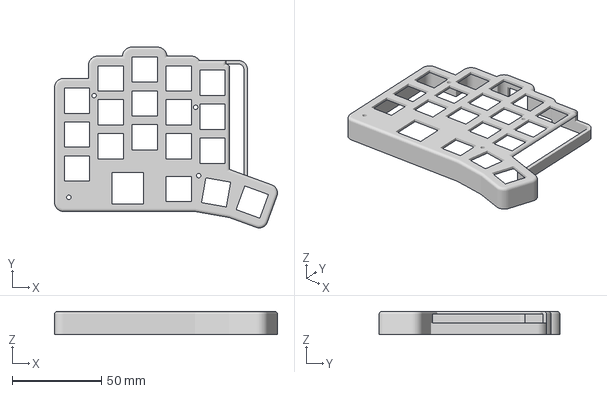
[picture p140: CAD file, 2022-11-08]
keyboards/luakeeb/cases/5-column/body.3mf
124.8 x 101.2 x 13.0 mm
