sadekbaroudi/fingerpunch/keyboards/luakeeb/cases/6-column/body-hp.stl

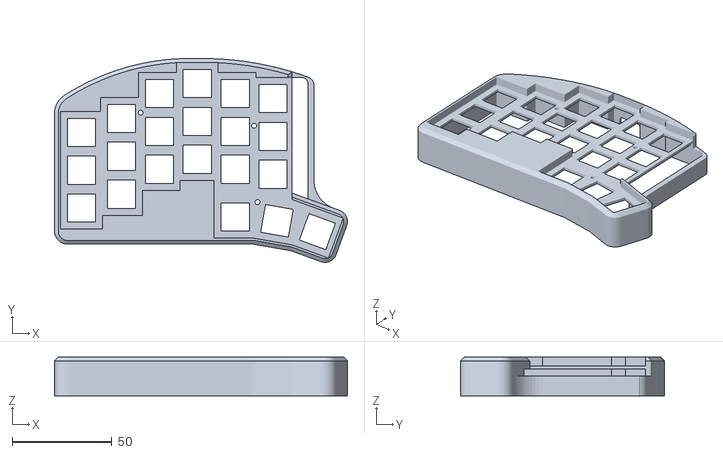
[picture p141: CAD file, 2023-03-28]
keyboards/luakeeb/cases/6-column/body-hp.stl
146.9 x 102.2 x 19.4
