sadekbaroudi/fingerpunch/keyboards/pinkies-out/cases/v3/po-v3-mx-bottom-plate.stl

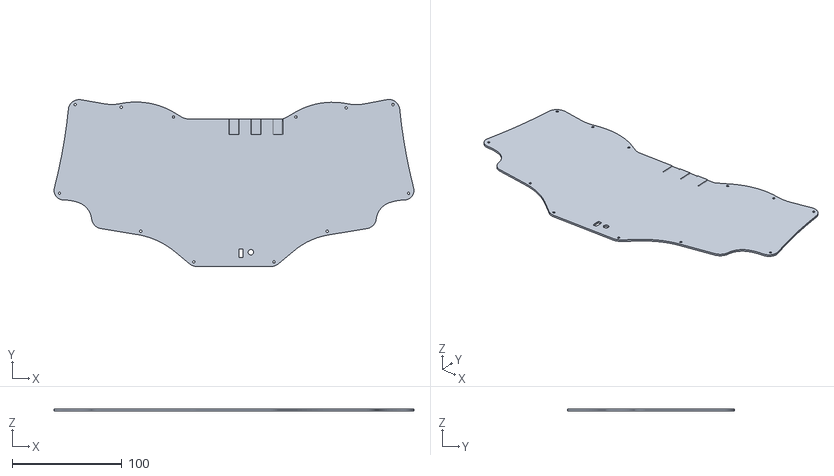
[picture p142: CAD file, 2024-08-10]
keyboards/pinkies-out/cases/v3/po-v3-mx-bottom-plate.stl
328.5 x 152.4 x 1.60
