sadekbaroudi/fingerpunch/keyboards/pinkies-out/plates/modular-models/pinkies-out-v3-trackball-25mm-attachment.stl

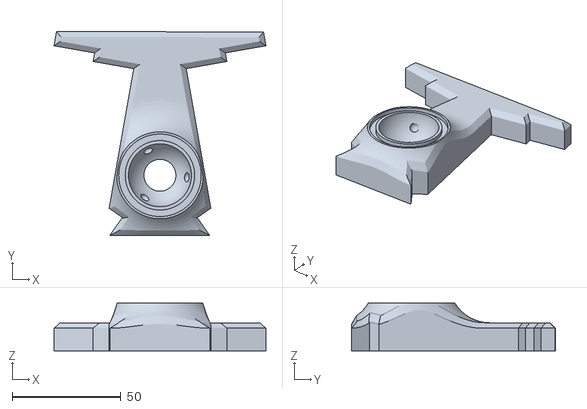
[picture p143: CAD file, 2024-11-18]
keyboards/pinkies-out/plates/modular-models/pinkies-out-v3-trackball-25mm-attachment.stl
97.7 x 93.9 x 22.1
