sadekbaroudi/fingerpunch/keyboards/pinkies-out/plates/v3/pinkiesout-v3-bottom-plate-with-4mm-spacer.stl

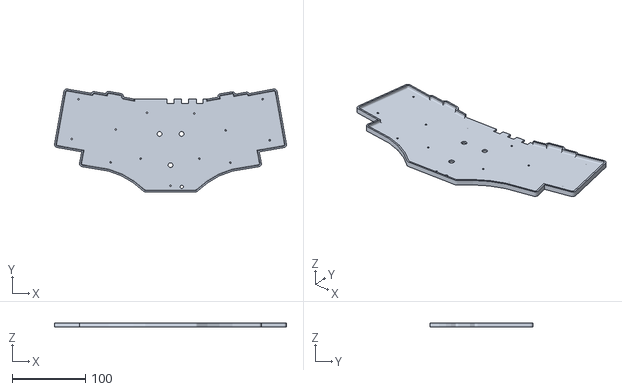
[picture p144: CAD file, 2023-07-28]
keyboards/pinkies-out/plates/v3/pinkiesout-v3-bottom-plate-with-4mm-spacer.stl
316.0 x 140.4 x 6.00
