sadekbaroudi/fingerpunch/keyboards/rock-on/cases/stl/v3/high-pro/ro-h3-mx-6-deg-tent-no-standoffs-modular.stl

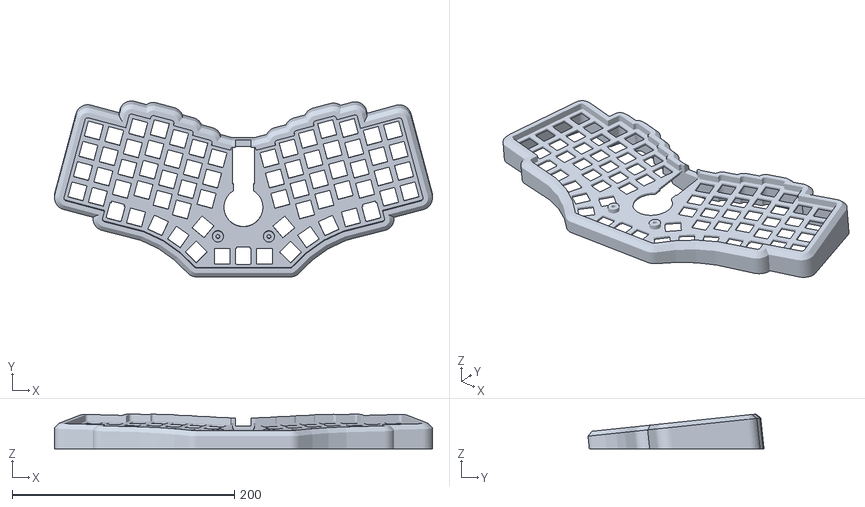
[picture p145: CAD file, 2025-02-07]
keyboards/rock-on/cases/stl/v3/high-pro/ro-h3-mx-6-deg-tent-no-standoffs-modular.stl
340.2 x 158.4 x 31.4
