sadekbaroudi/fingerpunch/keyboards/rock-on/cases/stl/v3/trackball/trackball-housing-trimmed.stl

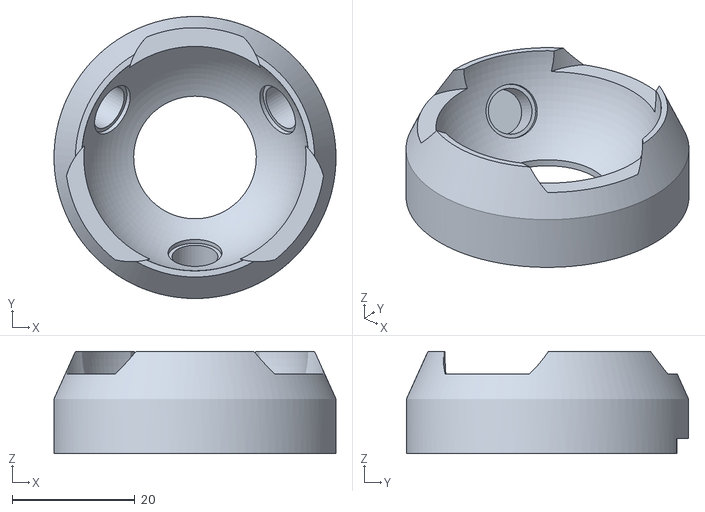
[picture p147: CAD file, 2022-11-08]
keyboards/rock-on/cases/stl/v3/trackball/trackball-housing-trimmed.stl
46.0 x 46.0 x 16.7
