sadekbaroudi/fingerpunch/keyboards/stenographobe/cases/stenographobe-fatplate-mx.stl

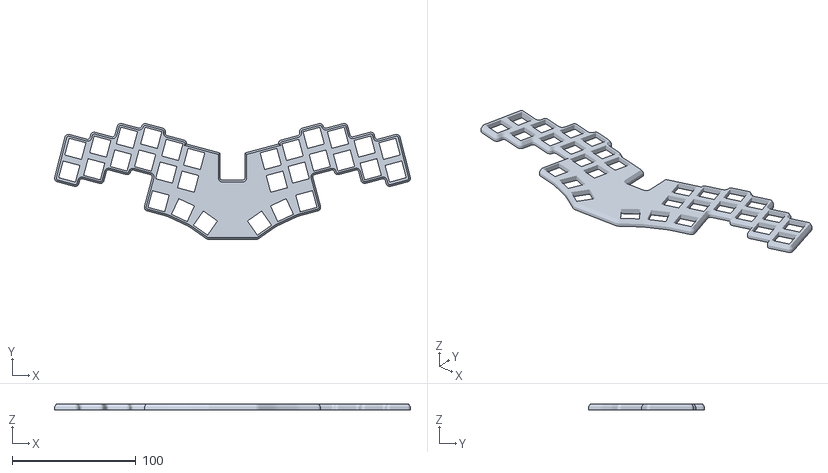
[picture p148: CAD file, 2023-03-20]
keyboards/stenographobe/cases/stenographobe-fatplate-mx.stl
288.0 x 93.9 x 5.00
