sadekbaroudi/fingerpunch/keyboards/tenbit/cases/v1/tenbit-5x12-choc.stl

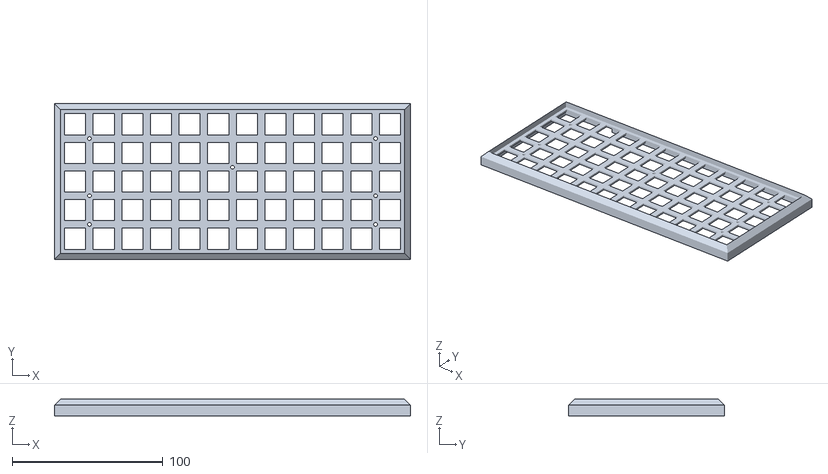
[picture p149: CAD file, 2024-02-01]
keyboards/tenbit/cases/v1/tenbit-5x12-choc.stl
236.4 x 103.4 x 11.0
