sadekbaroudi/fingerpunch/keyboards/vikropad/cases/choc-glp/vikropad-choc-glp-bottom-xivik.stl

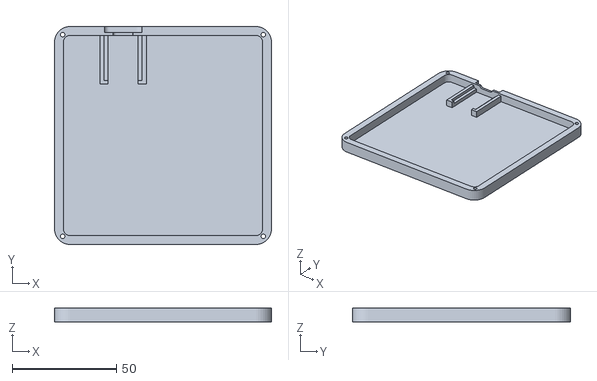
[picture p150: CAD file, 2024-05-06]
keyboards/vikropad/cases/choc-glp/vikropad-choc-glp-bottom-xivik.stl
104.0 x 104.5 x 6.52
