sadekbaroudi/fingerpunch/keyboards/vulpes-majora/v1/cases/stl/vmaj-6-mx-uni-tps65-5w-3wt.stl

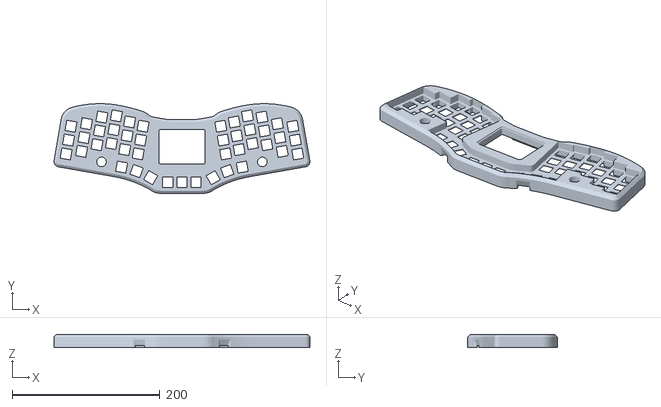
[picture p151: CAD file, 2023-11-09]
keyboards/vulpes-majora/v1/cases/stl/vmaj-6-mx-uni-tps65-5w-3wt.stl
346.2 x 121.4 x 18.0
