sadekbaroudi/fingerpunch/keyboards/ximega/v1/cases/ximega-mx-cover-vik-gc9a01-display.stl

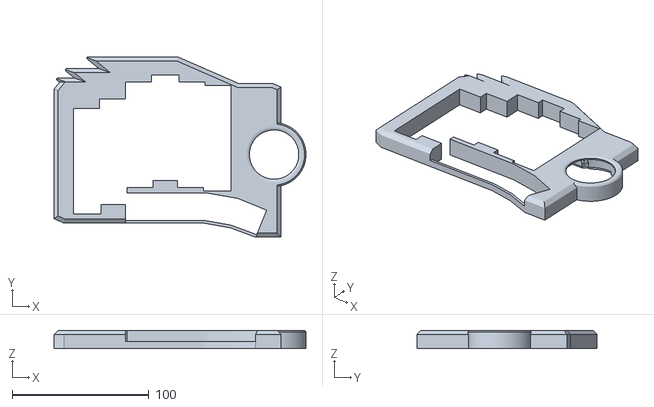
[picture p152: CAD file, 2024-06-27]
keyboards/ximega/v1/cases/ximega-mx-cover-vik-gc9a01-display.stl
184.0 x 131.8 x 13.2
