sadekbaroudi/fingerpunch/keyboards/ximi/beta/cases/stl/xi-6-cc-bot.stl

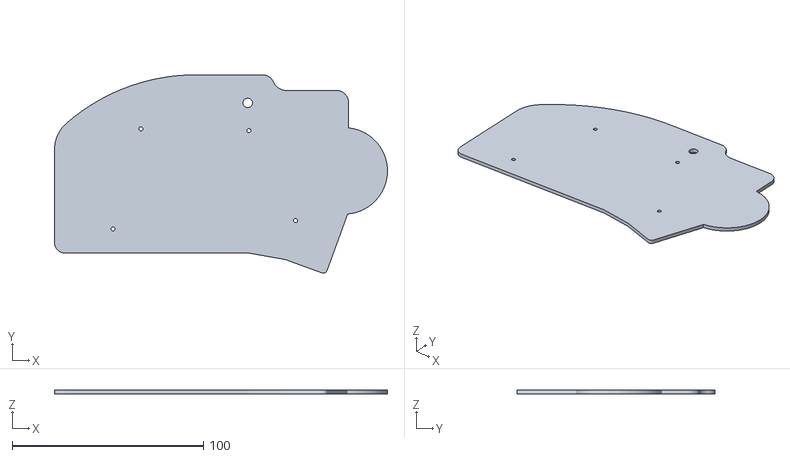
[picture p153: CAD file, 2023-08-06]
keyboards/ximi/beta/cases/stl/xi-6-cc-bot.stl
174.1 x 103.7 x 2.00
