sadekbaroudi/fingerpunch/keyboards/ximi/v2/cases/waveshare-22224-cover.stl

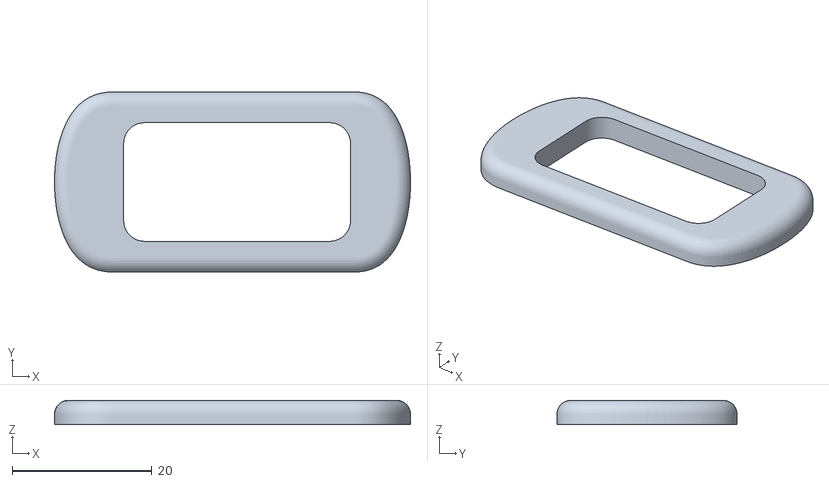
[picture p154: CAD file, 2024-05-18]
keyboards/ximi/v2/cases/waveshare-22224-cover.stl
51.0 x 25.8 x 3.50
