sadekbaroudi/fingerpunch/keycaps/CMY/5-degree/CMY-CHOC-R1.stl

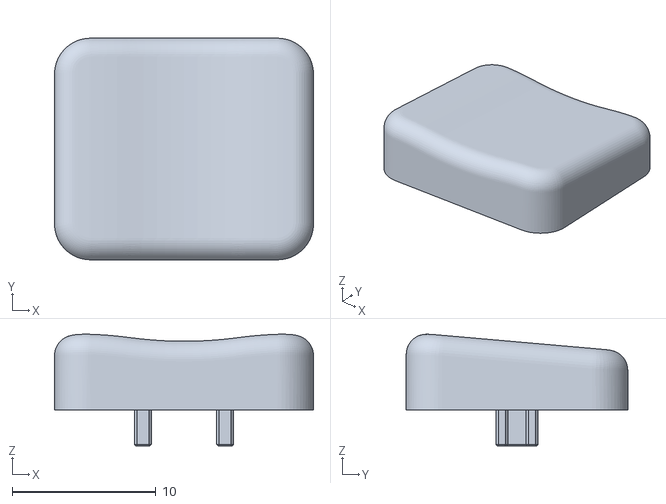
[picture p156: CAD file, 2024-03-06]
keycaps/CMY/5-degree/CMY-CHOC-R1.stl
18.0 x 15.4 x 7.76
