sadekbaroudi/fingerpunch/keycaps/CMY/other/CMY-CHOC-2U-2POS.stl

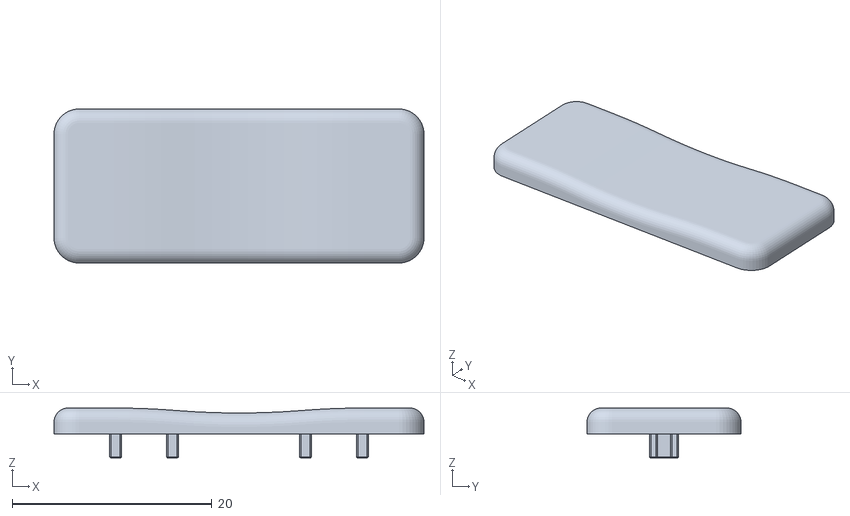
[picture p157: CAD file, 2023-10-27]
keycaps/CMY/other/CMY-CHOC-2U-2POS.stl
37.0 x 15.4 x 5.00
