sadekbaroudi/fingerpunch/keycaps/CMY/sculpted-thumbs/CMY-MX-thumb-C.stl

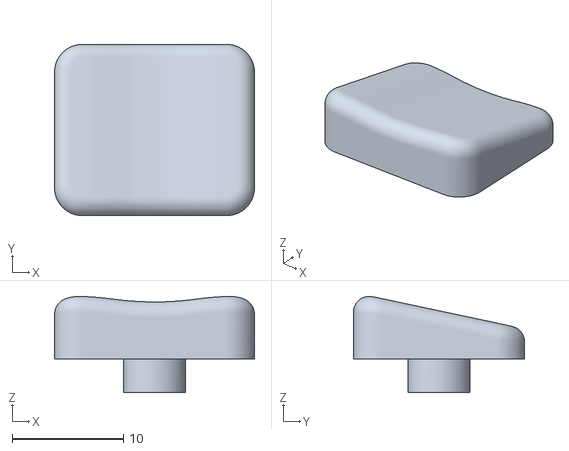
[picture p158: CAD file, 2024-02-02]
keycaps/CMY/sculpted-thumbs/CMY-MX-thumb-C.stl
18.0 x 15.4 x 8.65
