sadekbaroudi/fingerpunch/3d-models/5-way-tactile-switch-knobs/5-way-rounded.step

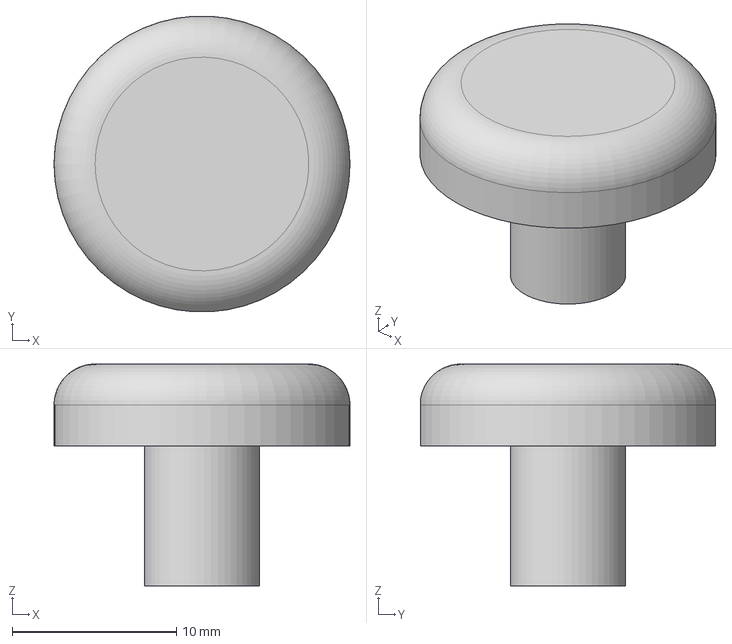
[picture p159: CAD file, 2024-04-17]
3d-models/5-way-tactile-switch-knobs/5-way-rounded.step
18.0 x 18.0 x 13.5 mm
