sadekbaroudi/fingerpunch/3d-models/ec11-knobs/D/angry-robot-6.1mm.stl

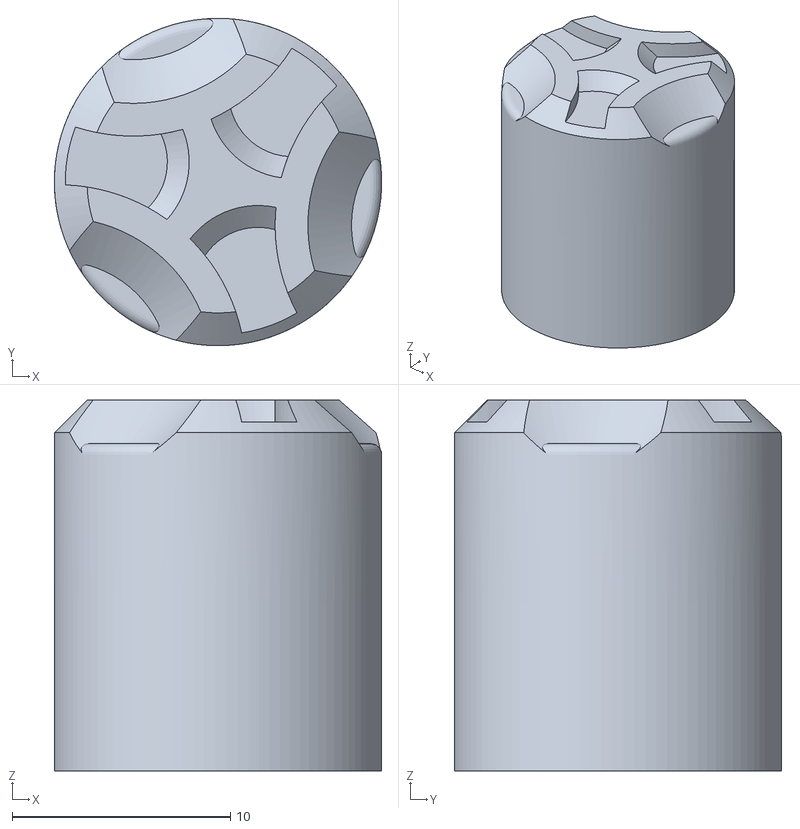
[picture p160: CAD file, 2023-10-12]
3d-models/ec11-knobs/D/angry-robot-6.1mm.stl
15.0 x 15.0 x 17.0
