sadekbaroudi/fingerpunch/3d-models/trackball-thumb-helmet/trackball-thumb-helmet-vik-controller-optional-battery-backpack.step

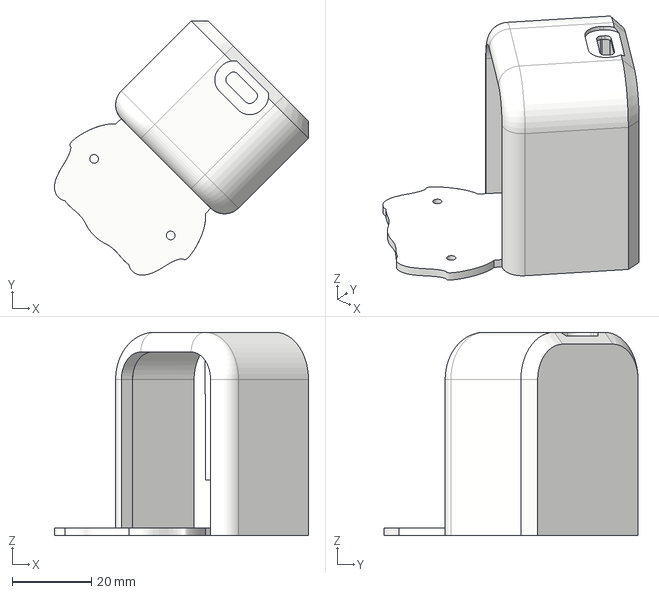
[picture p162: CAD file, 2024-04-19]
3d-models/trackball-thumb-helmet/trackball-thumb-helmet-vik-controller-optional-battery-backpack.step
64.2 x 64.2 x 51.4 mm
