sadekbaroudi/fingerpunch/keyboards/bigbarobord/cases/stl/bottomplate.3mf

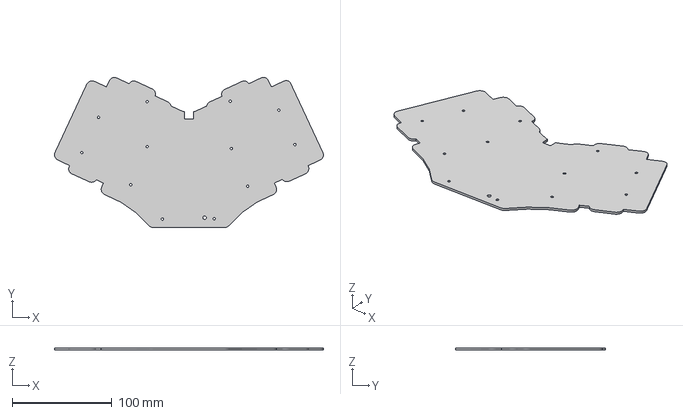
[picture p163: CAD file, 2022-08-29]
keyboards/bigbarobord/cases/stl/bottomplate.3mf
269.2 x 150.5 x 2.00 mm
