sadekbaroudi/fingerpunch/keyboards/euclid36/cases/euclid36-large-hole-cover.stl

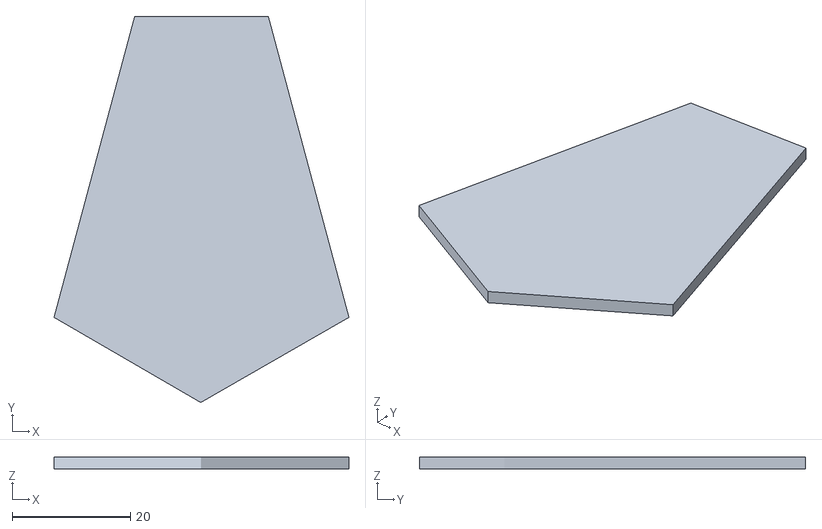
[picture p164: CAD file, 2023-03-30]
keyboards/euclid36/cases/euclid36-large-hole-cover.stl
49.8 x 65.2 x 2.00
