sadekbaroudi/fingerpunch/keyboards/ffkb/cases/stls/encoder-addons/EC11-encoder-cap-small.3mf

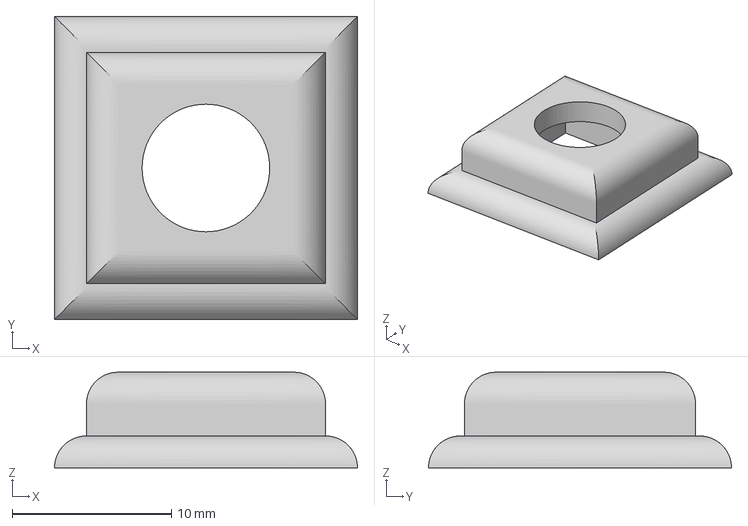
[picture p165: CAD file, 2022-08-29]
keyboards/ffkb/cases/stls/encoder-addons/EC11-encoder-cap-small.3mf
19.0 x 19.0 x 6.00 mm
