sadekbaroudi/fingerpunch/keyboards/ffkb/cases/stls/holyiot/ffkb-holyiot-6-mx-body.stl

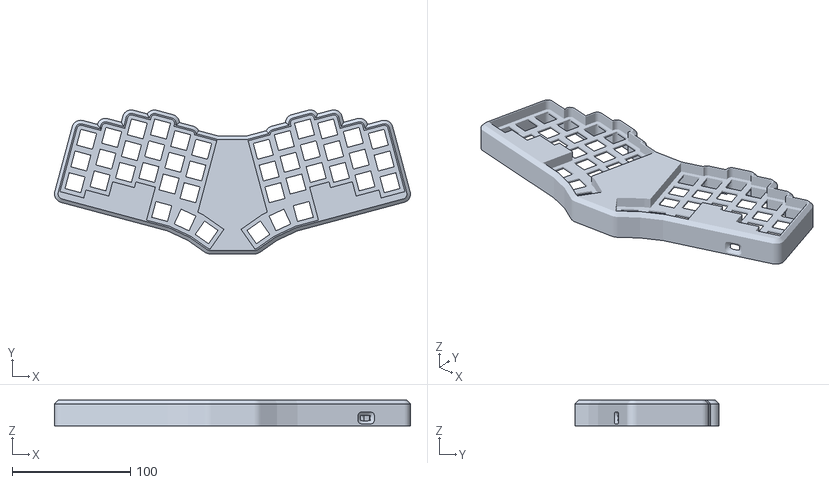
[picture p166: CAD file, 2024-04-29]
keyboards/ffkb/cases/stls/holyiot/ffkb-holyiot-6-mx-body.stl
300.7 x 121.8 x 21.6
