sadekbaroudi/fingerpunch/keyboards/ffkb/cases/stls/lite/min-y/ffkb-LMY-6-bot-raisedlip-bumpon7.5mm-cutouts.stl

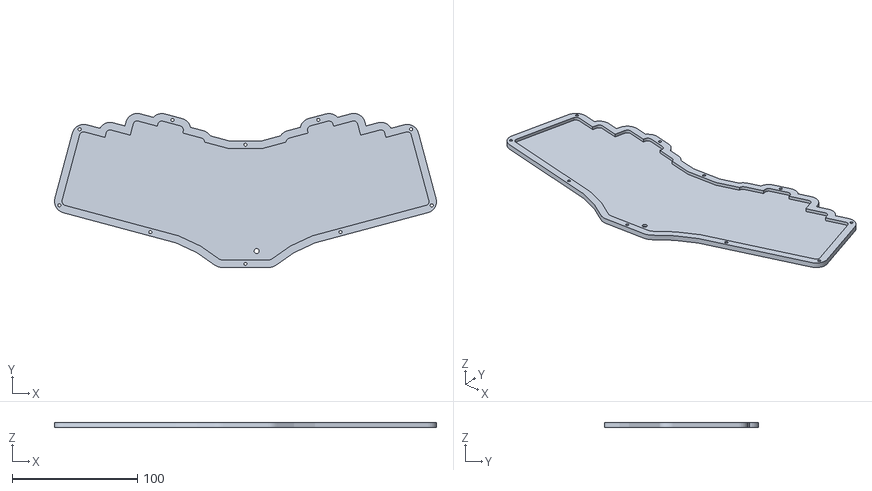
[picture p167: CAD file, 2024-03-26]
keyboards/ffkb/cases/stls/lite/min-y/ffkb-LMY-6-bot-raisedlip-bumpon7.5mm-cutouts.stl
304.6 x 122.9 x 4.00
