sadekbaroudi/fingerpunch/keyboards/ffkb/cases/stls/lite/standard/ffkb-lite-choc-5-wireless-cirque-35mm-body.stl

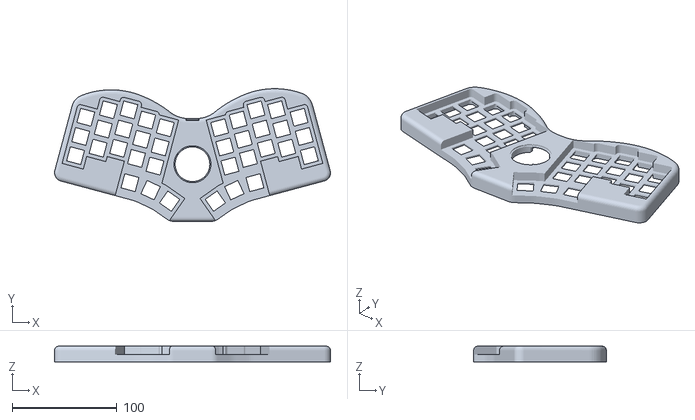
[picture p168: CAD file, 2024-05-08]
keyboards/ffkb/cases/stls/lite/standard/ffkb-lite-choc-5-wireless-cirque-35mm-body.stl
264.1 x 127.0 x 15.0
