sadekbaroudi/fingerpunch/keyboards/ffkb/cases/stls/lowpro-chunky/ff-lp-chunky-5-body-rectangle-unrecessed-thumb.stl

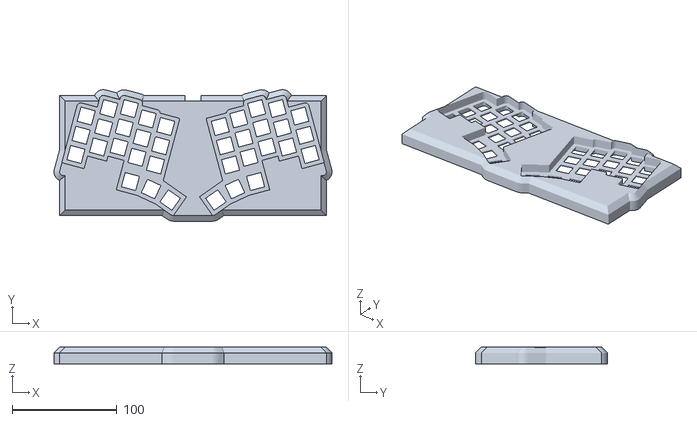
[picture p169: CAD file, 2023-02-04]
keyboards/ffkb/cases/stls/lowpro-chunky/ff-lp-chunky-5-body-rectangle-unrecessed-thumb.stl
265.6 x 125.8 x 16.0
