sadekbaroudi/fingerpunch/keyboards/ffkb/cases/stls/lowpro-led-ring/led-ring-arc-reactor.stl

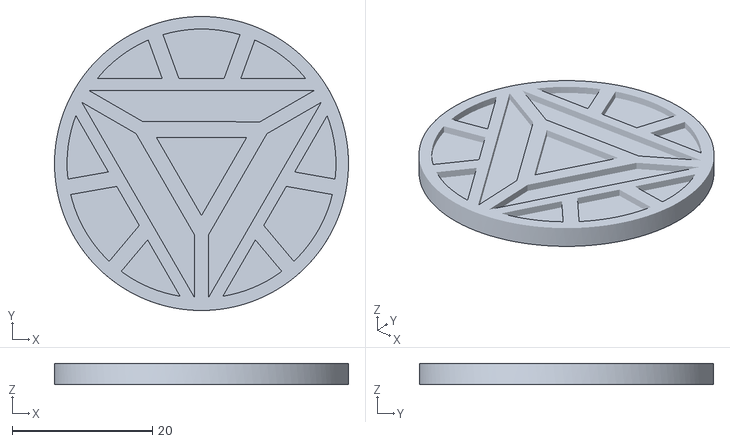
[picture p170: CAD file, 2023-02-12]
keyboards/ffkb/cases/stls/lowpro-led-ring/led-ring-arc-reactor.stl
42.0 x 42.0 x 3.00
