sadekbaroudi/fingerpunch/keyboards/ffkb/cases/stls/wireless-edition-v1/slim/ffkb-we-choc-slim-5-battery-on-top-no-cirque.stl

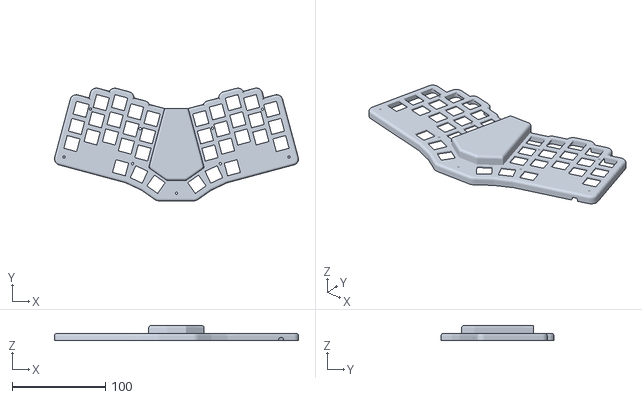
[picture p172: CAD file, 2025-04-07]
keyboards/ffkb/cases/stls/wireless-edition-v1/slim/ffkb-we-choc-slim-5-battery-on-top-no-cirque.stl
261.1 x 120.8 x 16.1
