sadekbaroudi/fingerpunch/keyboards/ffkb/cases/stls/wireless-edition-v1/thick/ffkb-wireless-edition-6-mid-bot.stl

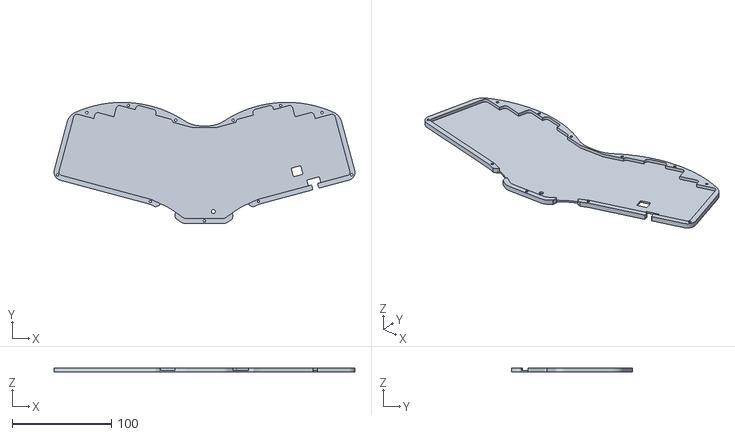
[picture p173: CAD file, 2025-04-09]
keyboards/ffkb/cases/stls/wireless-edition-v1/thick/ffkb-wireless-edition-6-mid-bot.stl
302.7 x 122.0 x 4.40
