sadekbaroudi/fingerpunch/keyboards/fflx/plates/fflx-ev-split-right.stl

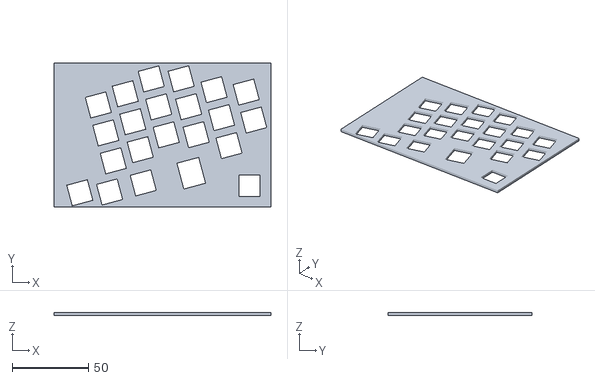
[picture p174: CAD file, 2022-07-11]
keyboards/fflx/plates/fflx-ev-split-right.stl
142.5 x 94.6 x 2.00
