sadekbaroudi/fingerpunch/keyboards/luakeeb/cases/6-column/body-hp-ec11.stl

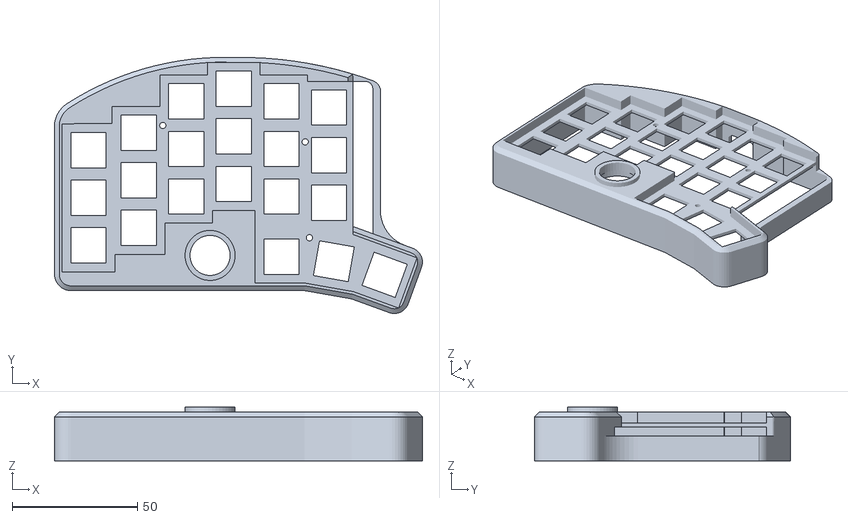
[picture p175: CAD file, 2023-03-28]
keyboards/luakeeb/cases/6-column/body-hp-ec11.stl
146.9 x 102.2 x 21.4
