sadekbaroudi/fingerpunch/keyboards/pinkies-out/cases/v3/po-v3-mx-body-non-modular-24mm-vik-xs.stl

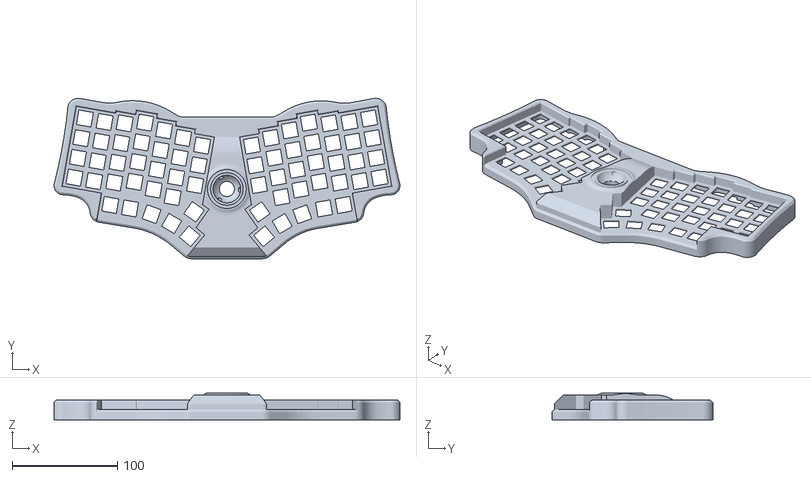
[picture p176: CAD file, 2024-08-06]
keyboards/pinkies-out/cases/v3/po-v3-mx-body-non-modular-24mm-vik-xs.stl
328.5 x 152.4 x 25.2
