sadekbaroudi/fingerpunch/keyboards/pinkies-out/plates/modular-models/pinkies-out-v2-pcb-v3-plates-center-cover.stl

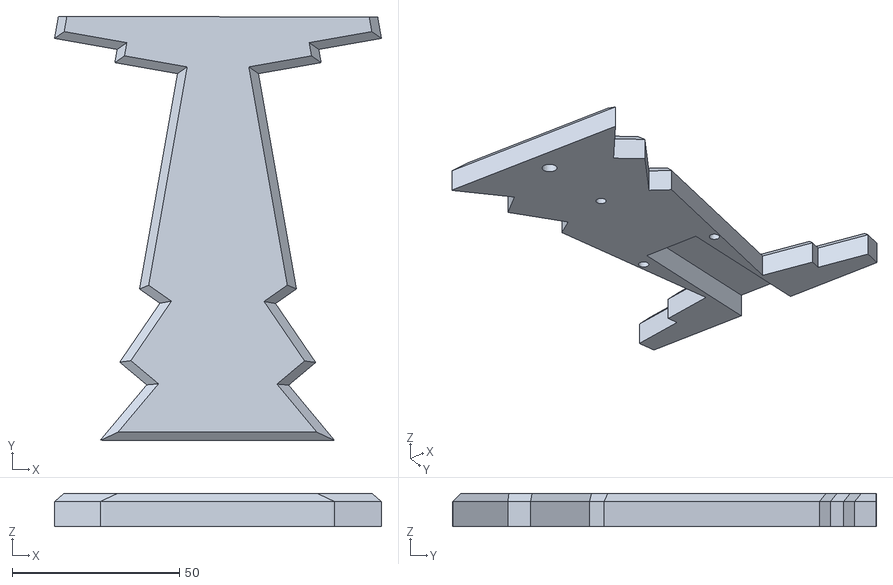
[picture p177: CAD file, 2024-05-20]
keyboards/pinkies-out/plates/modular-models/pinkies-out-v2-pcb-v3-plates-center-cover.stl
97.7 x 126.7 x 10.0
