sadekbaroudi/fingerpunch/keyboards/rock-on/cases/stl/v3/high-pro/ro-h3-mx-no-standoffs-modular.stl

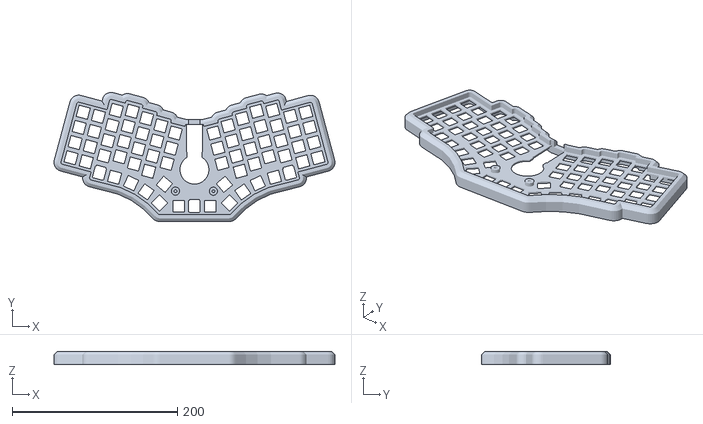
[picture p178: CAD file, 2024-04-23]
keyboards/rock-on/cases/stl/v3/high-pro/ro-h3-mx-no-standoffs-modular.stl
340.1 x 156.4 x 16.0
