sadekbaroudi/fingerpunch/keyboards/rock-on/cases/stl/v3/low-pro/ro-v3-ul-cir-mx-w.stl

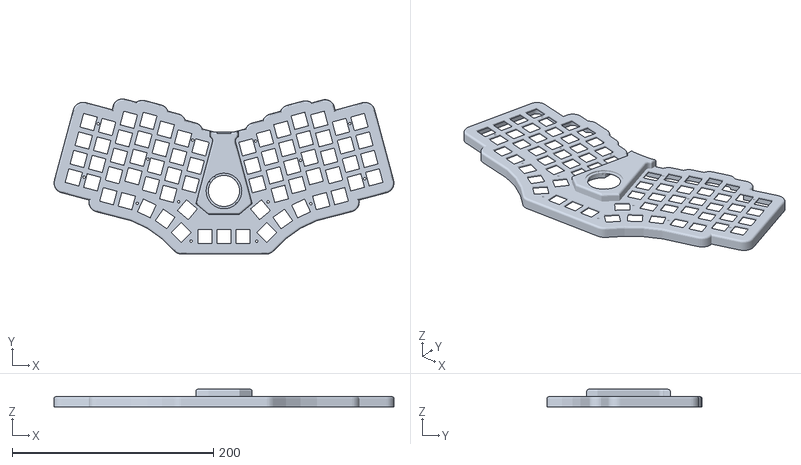
[picture p179: CAD file, 2025-03-11]
keyboards/rock-on/cases/stl/v3/low-pro/ro-v3-ul-cir-mx-w.stl
338.2 x 154.4 x 17.5
