sadekbaroudi/fingerpunch/keyboards/stenographobe/cases/stenographobe-body-mx.stl

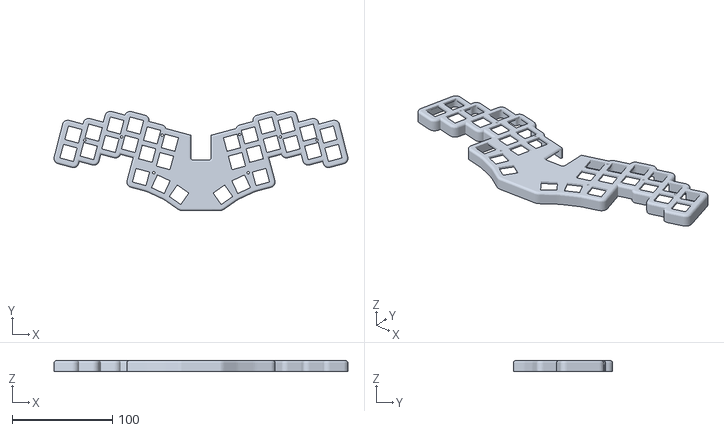
[picture p180: CAD file, 2023-02-02]
keyboards/stenographobe/cases/stenographobe-body-mx.stl
293.0 x 98.9 x 10.6
