sadekbaroudi/fingerpunch/keyboards/tenbit/cases/v1/tenbit-4x12-bot.stl

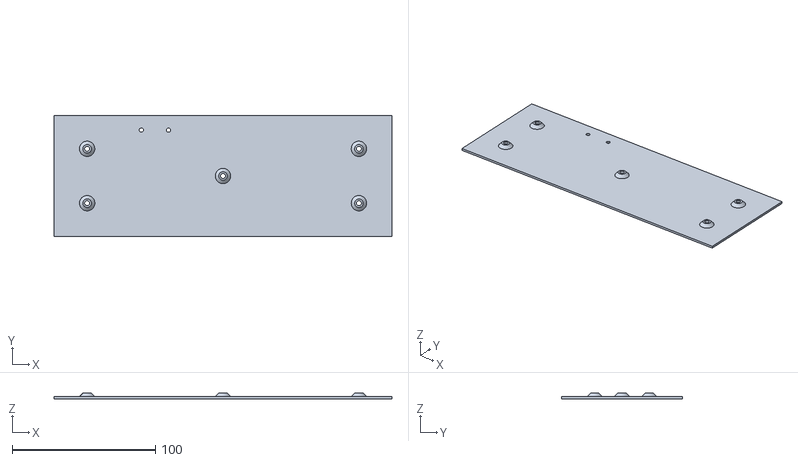
[picture p181: CAD file, 2023-05-06]
keyboards/tenbit/cases/v1/tenbit-4x12-bot.stl
236.3 x 84.3 x 4.00
