sadekbaroudi/fingerpunch/keyboards/vulpes-majora/v1/cases/stl/vmaj-6-choc-uni-tr-5w-3wt.stl

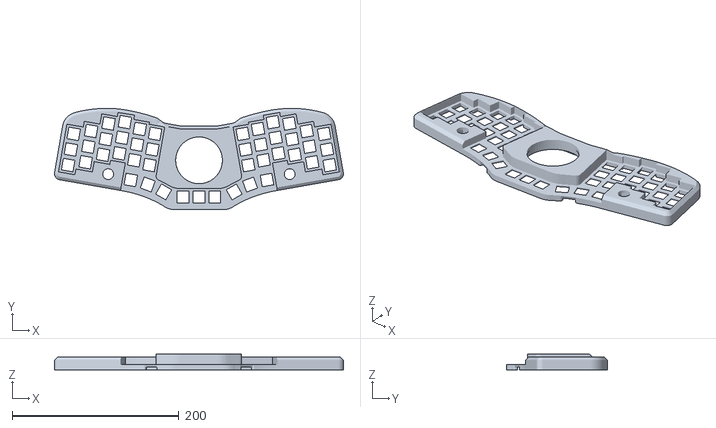
[picture p182: CAD file, 2023-11-06]
keyboards/vulpes-majora/v1/cases/stl/vmaj-6-choc-uni-tr-5w-3wt.stl
346.2 x 121.4 x 18.6
