sadekbaroudi/fingerpunch/keyboards/ximega/v1/cases/ximega-vik-gc9a01-display-holder.stl

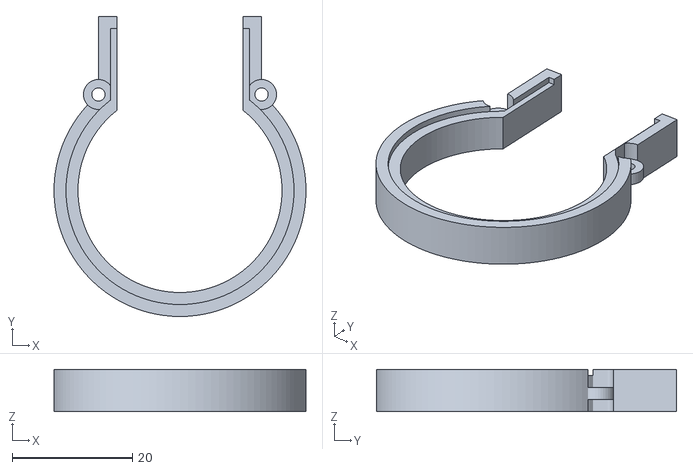
[picture p183: CAD file, 2024-06-27]
keyboards/ximega/v1/cases/ximega-vik-gc9a01-display-holder.stl
42.0 x 50.0 x 7.00
