sadekbaroudi/fingerpunch/keyboards/ximi/beta/cases/stl/xi-6-tr-bot.stl

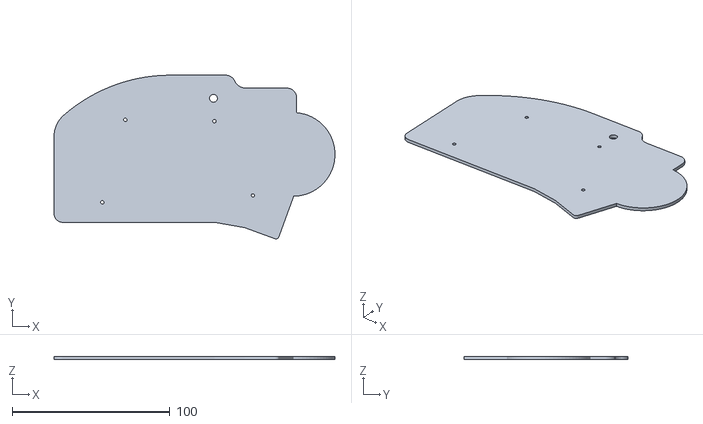
[picture p184: CAD file, 2023-08-06]
keyboards/ximi/beta/cases/stl/xi-6-tr-bot.stl
178.0 x 103.7 x 2.00
