sadekbaroudi/fingerpunch/keyboards/ximi/v2/cases/xi-6-mx-ne-vik-waveshare-22224-3wt-left.stl

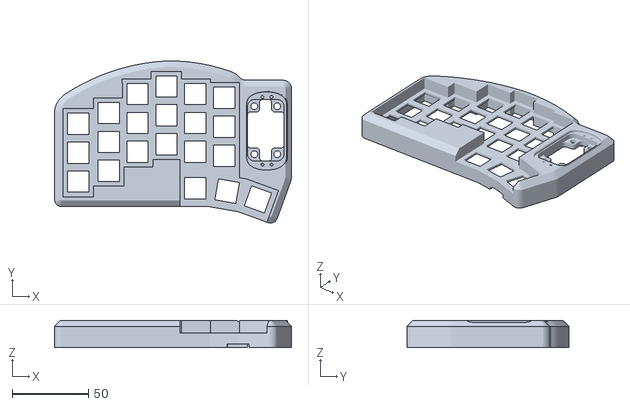
[picture p185: CAD file, 2024-05-18]
keyboards/ximi/v2/cases/xi-6-mx-ne-vik-waveshare-22224-3wt-left.stl
155.9 x 106.6 x 18.0
