sadekbaroudi/fingerpunch/keycaps/CMY/12-degree-flat-ends/CMY-MX-3x-lateral-sets-with-homing.stl

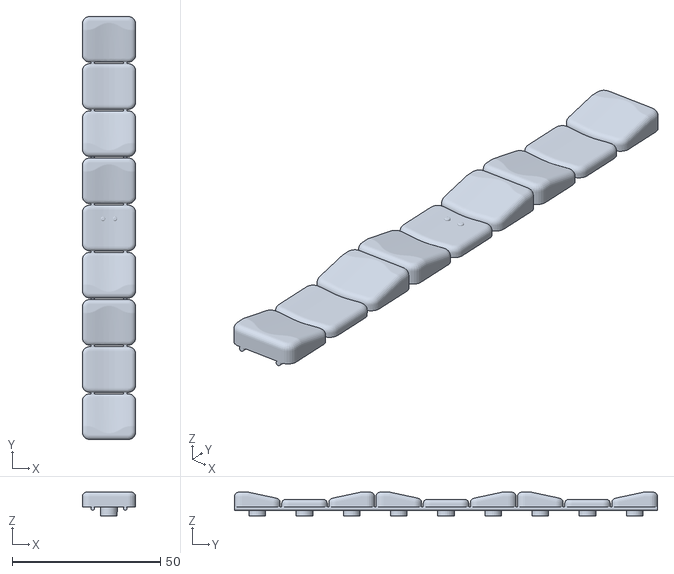
[picture p186: CAD file, 2024-02-02]
keycaps/CMY/12-degree-flat-ends/CMY-MX-3x-lateral-sets-with-homing.stl
18.0 x 142.6 x 8.03
