sadekbaroudi/fingerpunch/keycaps/CMY/12-degree/CMY-MX-2x-edge-col-sets.stl

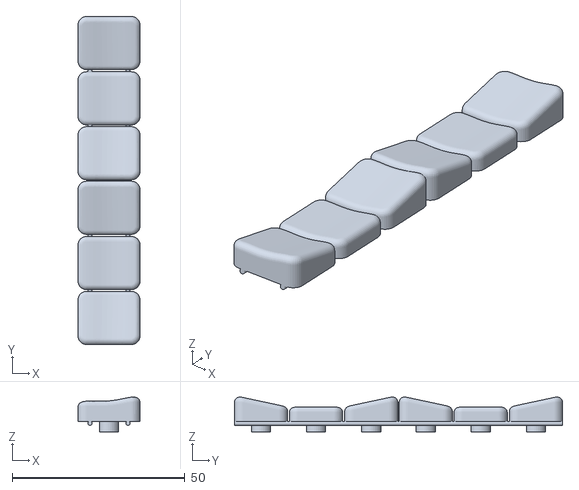
[picture p187: CAD file, 2024-02-02]
keycaps/CMY/12-degree/CMY-MX-2x-edge-col-sets.stl
18.0 x 95.0 x 10.1
