sadekbaroudi/fingerpunch/keycaps/CMY/5-degree/CMY-CHOC-9x-R1.stl

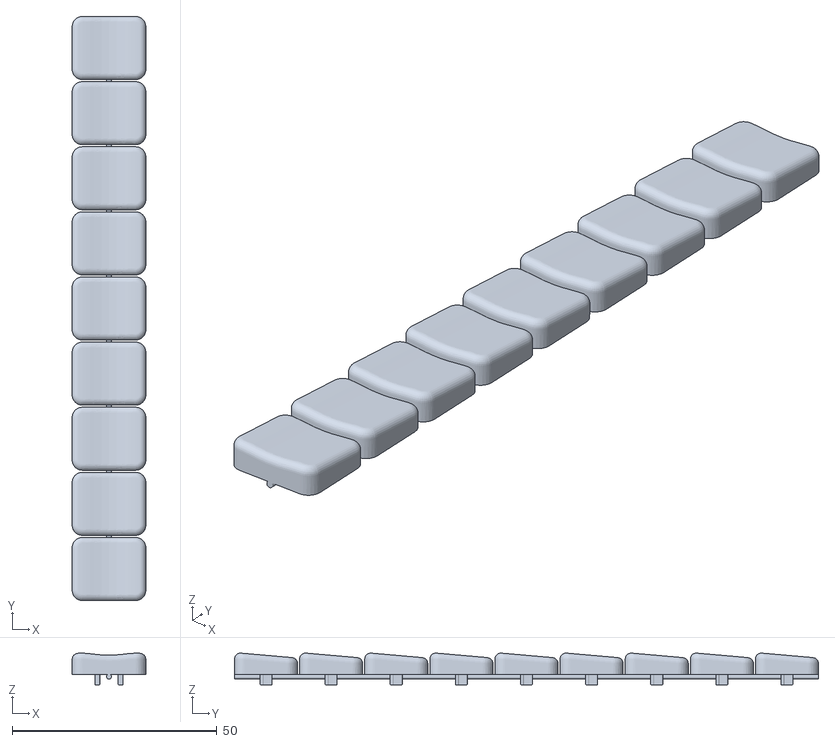
[picture p188: CAD file, 2024-03-06]
keycaps/CMY/5-degree/CMY-CHOC-9x-R1.stl
18.0 x 142.6 x 7.76
