sadekbaroudi/fingerpunch/keycaps/CMY/sculpted-thumbs/CMY-MX-2x-thumb-tilt-sets-of-3.stl

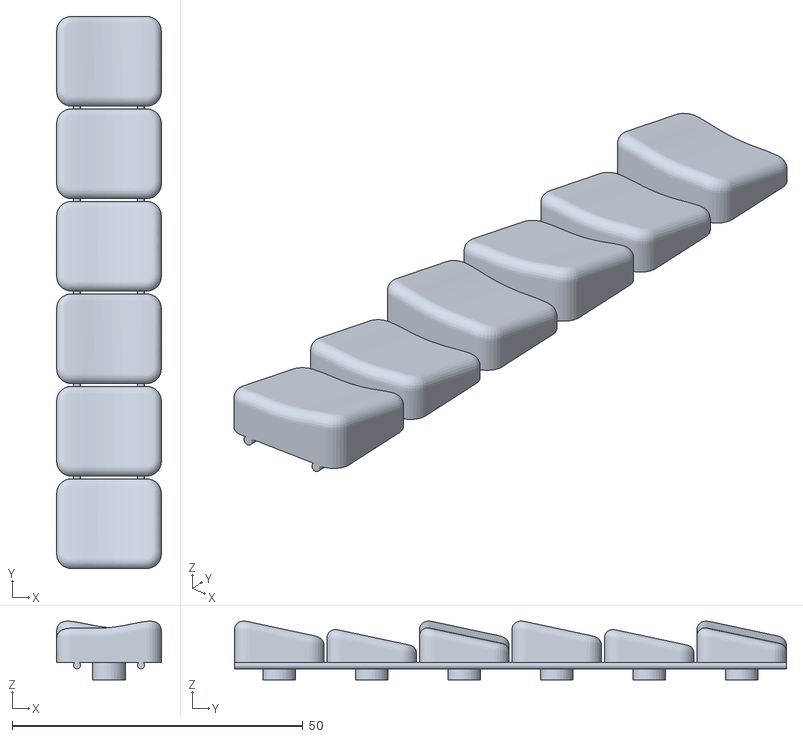
[picture p189: CAD file, 2024-02-02]
keycaps/CMY/sculpted-thumbs/CMY-MX-2x-thumb-tilt-sets-of-3.stl
18.0 x 94.9 x 10.1
