sadekbaroudi/fingerpunch/3d-models/5-way-tactile-switch-knobs/5-way-concave-directional.step

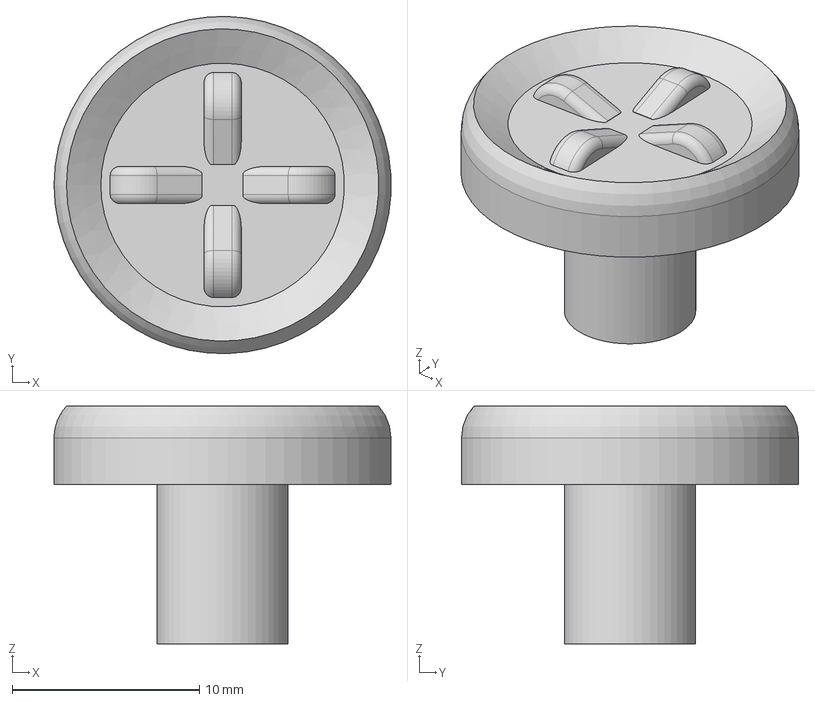
[picture p190: CAD file, 2024-04-17]
3d-models/5-way-tactile-switch-knobs/5-way-concave-directional.step
18.0 x 18.0 x 12.7 mm
