sadekbaroudi/fingerpunch/3d-models/ec11-knobs/D/simple-6.1mm.stl

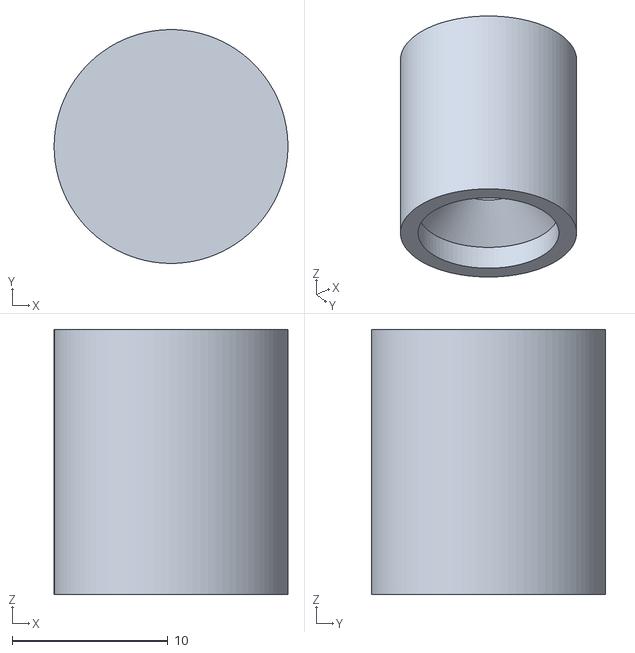
[picture p191: CAD file, 2023-10-12]
3d-models/ec11-knobs/D/simple-6.1mm.stl
15.0 x 15.0 x 17.0
