sadekbaroudi/fingerpunch/3d-models/trackball-thumb-helmet/trackball-thumb-helmet-backplate-vik-2mm-offset.step

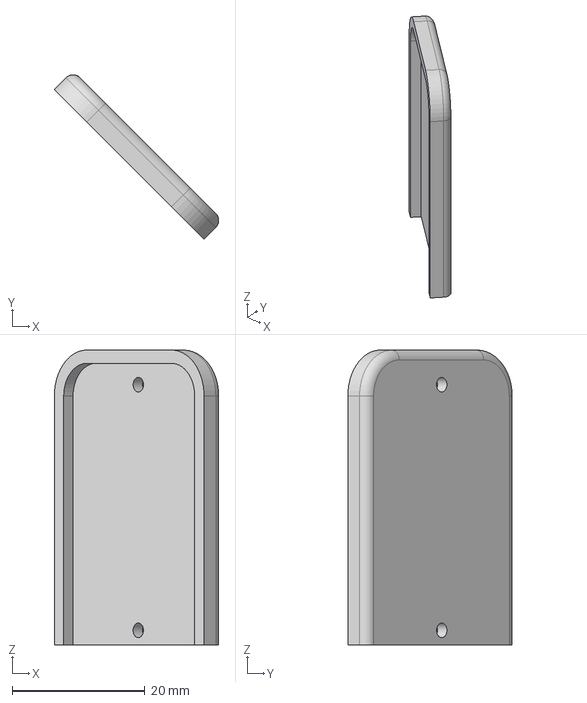
[picture p193: CAD file, 2024-04-19]
3d-models/trackball-thumb-helmet/trackball-thumb-helmet-backplate-vik-2mm-offset.step
24.8 x 24.8 x 44.4 mm
