sadekbaroudi/fingerpunch/keyboards/euclid36/cases/euclid36-recessed-with-large-hole.stl

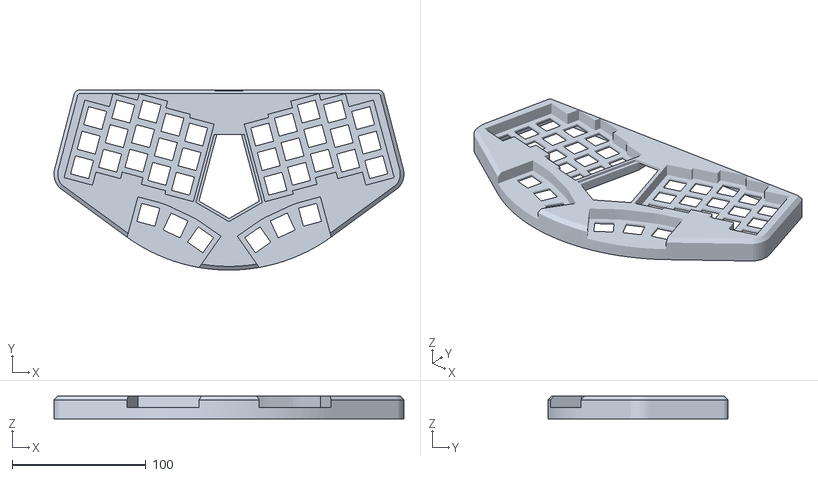
[picture p194: CAD file, 2023-03-30]
keyboards/euclid36/cases/euclid36-recessed-with-large-hole.stl
262.1 x 135.0 x 17.0
