sadekbaroudi/fingerpunch/keyboards/ffkb/cases/stls/lite/min-y/ffkb-LMY-6-choc-35mm-curved-cirque.stl

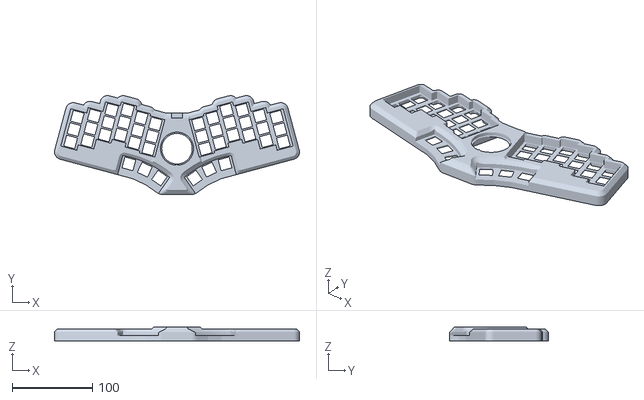
[picture p195: CAD file, 2023-12-12]
keyboards/ffkb/cases/stls/lite/min-y/ffkb-LMY-6-choc-35mm-curved-cirque.stl
304.6 x 122.9 x 17.0
