sadekbaroudi/fingerpunch/keyboards/ffkb/cases/stls/lite/standard/ffkb-lite-mx-5-body.stl

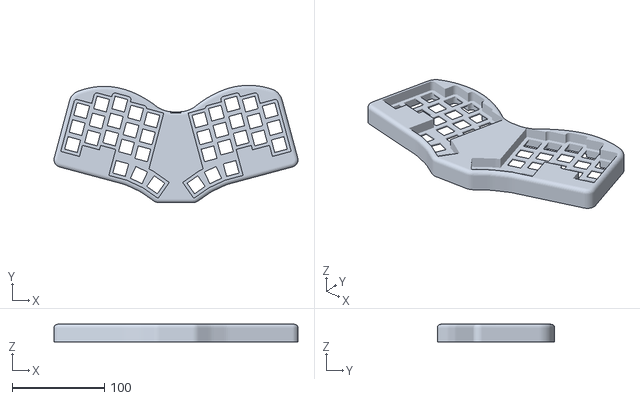
[picture p196: CAD file, 2024-05-08]
keyboards/ffkb/cases/stls/lite/standard/ffkb-lite-mx-5-body.stl
264.1 x 127.0 x 19.0
