sadekbaroudi/fingerpunch/keyboards/ffkb/cases/stls/lowpro-chunky/ff-lp-chunky-6-EC11-body-rectangle-unrecessed-thumb.stl

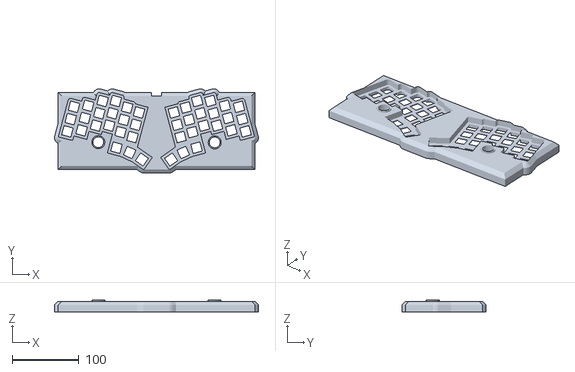
[picture p197: CAD file, 2023-02-04]
keyboards/ffkb/cases/stls/lowpro-chunky/ff-lp-chunky-6-EC11-body-rectangle-unrecessed-thumb.stl
304.6 x 125.8 x 18.0
