sadekbaroudi/fingerpunch/keyboards/ffkb/cases/stls/lowpro-led-ring/led-ring-arc-reactor-4x.stl

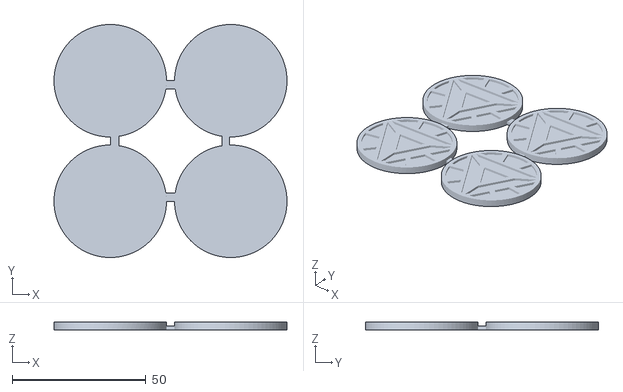
[picture p198: CAD file, 2023-02-12]
keyboards/ffkb/cases/stls/lowpro-led-ring/led-ring-arc-reactor-4x.stl
87.0 x 87.0 x 3.00
