sadekbaroudi/fingerpunch/(list of files, cad)

Other CAD files:
keyboards/bigbarobord/cases/stl/body-full-oled.3mf
keyboards/ffkb/cases/stls/wireless-edition-v1/fingerpunch-emblem-45mm-diameter-35mm-plug.stl
keyboards/bigbarobord/cases/stl/body-encoder.3mf
keyboards/rock-on/cases/stl/v3/high-pro-rectangular/ro-h3-choc-cir-rectangular.stl
keyboards/rock-on/cases/stl/v3/low-pro-rectangular/ro-v2-v3-bottom-rectangular.stl
keycaps/CMY/12-degree-flat-ends/CMY-MX-R3-homing.stl
keyboards/ffkb/plates/stl/ffkb-topmount-switchplate-5col-EVQx2.stl
keyboards/kucheza/v1/cases/kucheza-bottom-plate.stl
keyboards/rock-on/cases/stl/v3/high-pro-rectangular/ro-h3-rectangular-bottom.stl
keyboards/rock-on/cases/stl/v3/trackball/trackball-housing-trimmed-with-BTU.stl
keyboards/bigbarobord/cases/stl/body-wireless-encoder.3mf
keyboards/ffkb/cases/stls/holyiot/ffkb-holyiot-6-mx-ec-LRClarge-body.stl
3d-models/5-way-tactile-switch-knobs/5-way-11.5mm-8bit-tree.stl
3d-models/5-way-tactile-switch-knobs/5-way-11.5mm-concave-directional.stl
3d-models/5-way-tactile-switch-knobs/5-way-11.5mm-concave.stl
3d-models/5-way-tactile-switch-knobs/5-way-11.5mm-flat-chamfer.stl
3d-models/5-way-tactile-switch-knobs/5-way-11.5mm-flat.stl
3d-models/5-way-tactile-switch-knobs/5-way-11.5mm-mushroom-directional.stl
3d-models/5-way-tactile-switch-knobs/5-way-11.5mm-mushroom.stl
3d-models/5-way-tactile-switch-knobs/5-way-11.5mm-rounded.stl
3d-models/5-way-tactile-switch-knobs/5-way-3.5mm-8bit-tree.stl
3d-models/5-way-tactile-switch-knobs/5-way-3.5mm-concave-directional.stl
3d-models/5-way-tactile-switch-knobs/5-way-3.5mm-concave.stl
3d-models/5-way-tactile-switch-knobs/5-way-3.5mm-flat-chamfer.stl
3d-models/5-way-tactile-switch-knobs/5-way-3.5mm-flat.stl
3d-models/5-way-tactile-switch-knobs/5-way-3.5mm-mushroom-directional.stl
3d-models/5-way-tactile-switch-knobs/5-way-3.5mm-mushroom.stl
3d-models/5-way-tactile-switch-knobs/5-way-3.5mm-rounded.stl
3d-models/5-way-tactile-switch-knobs/5-way-5.5mm-8bit-tree.stl
3d-models/5-way-tactile-switch-knobs/5-way-5.5mm-concave-directional.stl
3d-models/5-way-tactile-switch-knobs/5-way-5.5mm-concave.stl
3d-models/5-way-tactile-switch-knobs/5-way-5.5mm-flat-chamfer.stl
3d-models/5-way-tactile-switch-knobs/5-way-5.5mm-flat.stl
3d-models/5-way-tactile-switch-knobs/5-way-5.5mm-mushroom-directional.stl
3d-models/5-way-tactile-switch-knobs/5-way-5.5mm-mushroom.stl
3d-models/5-way-tactile-switch-knobs/5-way-5.5mm-rounded.stl
3d-models/5-way-tactile-switch-knobs/5-way-8.5mm-8bit-tree.stl
3d-models/5-way-tactile-switch-knobs/5-way-8.5mm-concave-directional.stl
3d-models/5-way-tactile-switch-knobs/5-way-8.5mm-concave.stl
3d-models/5-way-tactile-switch-knobs/5-way-8.5mm-flat-chamfer.stl
3d-models/5-way-tactile-switch-knobs/5-way-8.5mm-flat.stl
3d-models/5-way-tactile-switch-knobs/5-way-8.5mm-mushroom-directional.stl
3d-models/5-way-tactile-switch-knobs/5-way-8.5mm-mushroom.stl
3d-models/5-way-tactile-switch-knobs/5-way-8.5mm-rounded.stl
3d-models/5-way-tactile-switch-knobs/5-way-8bit-tree.step
3d-models/5-way-tactile-switch-knobs/5-way-concave.step
3d-models/5-way-tactile-switch-knobs/5-way-flat.step
3d-models/5-way-tactile-switch-knobs/5-way-mushroom.step
3d-models/ec11-knobs/D/angry-robot-6.5mm.stl
3d-models/ec11-knobs/D/chamfered-6.1mm.stl
3d-models/ec11-knobs/D/chamfered-6.5mm.stl
3d-models/ec11-knobs/D/notch-handles-6.1mm.stl
3d-models/ec11-knobs/D/notch-handles-6.5mm.stl
3d-models/ec11-knobs/D/rounded-6.1mm.stl
3d-models/ec11-knobs/D/rounded-6.5mm.stl
3d-models/ec11-knobs/D/rounded-pocket-6.1mm.stl
3d-models/ec11-knobs/D/rounded-pocket-6.5mm.stl
3d-models/ec11-knobs/D/simple-6.5mm.stl
3d-models/ec11-knobs/D/wobble-wave-6.1mm.stl
3d-models/ec11-knobs/D/wobble-wave-6.5mm.stl
3d-models/solenoid/uxcell-a14092600ux0438/uxcell-a14092600ux0438-holder.f3d
3d-models/solenoid/uxcell-a14092600ux0438/uxcell-a14092600ux0438-object-in-holder.f3z
3d-models/solenoid/uxcell-a14092600ux0438/uxcell-a14092600ux0438-object.f3d
3d-models/tenting/print-in-place/device-tenting-stand-30percent.stl
3d-models/tenting/print-in-place/device-tenting-stand-50percent.stl
3d-models/tenting/print-in-place/device-tenting-stand-60percent.stl
3d-models/tenting/print-in-place/device-tenting-stand-80percent.stl
3d-models/tenting/print-in-place/device-tenting-stand-90percent.stl
3d-models/tenting/print-in-place/device-tenting-vertical-stand.stl
3d-models/trackball-housing-parametric/trackball-housing-parametric v12.f3z
3d-models/trackball-housing-parametric/trackball-housing-reduced-base-height-parametric_v4.f3z
3d-models/trackball-thumb-helmet/trackball-thumb-helmet-backplate-vik-2mm-offset.stl
3d-models/trackball-thumb-helmet/trackball-thumb-helmet-backplate-vik-xs-2mm-offset.step
3d-models/trackball-thumb-helmet/trackball-thumb-helmet-backplate-vik-xs-2mm-offset.stl
3d-models/trackball-thumb-helmet/trackball-thumb-helmet-backplate-vik-xs.step
3d-models/trackball-thumb-helmet/trackball-thumb-helmet-backplate-vik.step
3d-models/trackball-thumb-helmet/trackball-thumb-helmet-backplate-vik.stl
3d-models/trackball-thumb-helmet/trackball-thumb-helmet-housing-vik-xs.step
3d-models/trackball-thumb-helmet/trackball-thumb-helmet-housing-vik-xs.stl
3d-models/trackball-thumb-helmet/trackball-thumb-helmet-housing-vik.step
3d-models/trackball-thumb-helmet/trackball-thumb-helmet-housing-vik.stl
3d-models/trackball-thumb-helmet/trackball-thumb-helmet-vik-controller-optional-battery-backpack.stl
3d-models/trackball-thumb-helmet/trackball-thumb-helmet-vik-medium.f3z
3d-models/trackball-thumb-helmet/trackball-thumb-helmet-vik-xs.f3z
keyboards/bigbarobord/cases/stl/body-oled.3mf
keyboards/bigbarobord/cases/stl/body-wireless-oled.3mf
keyboards/bigbarobord/cases/stl/body-wireless-pimoroni.3mf
keyboards/euclid36/cases/euclid36-bottom-plate.stl
keyboards/euclid36/cases/euclid36-large-hole-cover.dxf
keyboards/euclid36/cases/euclid36-recessed-with-led-holes.stl
keyboards/ffkb/cases/stls/lite/min-y/ffkb-LMY-5-bot.stl
keyboards/ffkb/cases/stls/lite/min-y/ffkb-LMY-5-choc-gc9a01.stl
keyboards/ffkb/cases/stls/lite/min-y/ffkb-LMY-5-choc.stl
keyboards/ffkb/cases/stls/lite/min-y/ffkb-LMY-5-mx-25mm-tr.stl
keyboards/ffkb/cases/stls/lite/min-y/ffkb-LMY-5-mx.stl
keyboards/ffkb/cases/stls/lite/min-y/ffkb-LMY-6-bot.dxf
keyboards/ffkb/cases/stls/lite/min-y/ffkb-LMY-6-bot.stl
keyboards/ffkb/cases/stls/lite/min-y/ffkb-LMY-6-choc-gc9a01.stl
keyboards/ffkb/cases/stls/lite/min-y/ffkb-LMY-6-choc.stl
keyboards/ffkb/cases/stls/lite/min-y/ffkb-LMY-6-mx-25mm-tr.stl
keyboards/ffkb/cases/stls/lite/min-y/ffkb-LMY-6-mx.stl
keyboards/ffkb/cases/stls/lite/min-y/ffkb-LMY-gc9a01-cover.stl
keyboards/ffkb/cases/stls/lite/standard/ffkb-lite-5-bot.stl
keyboards/ffkb/cases/stls/lite/standard/ffkb-lite-6-bot.dxf
keyboards/ffkb/cases/stls/lite/standard/ffkb-lite-6-bot.step
keyboards/ffkb/cases/stls/lite/standard/ffkb-lite-6-fox-logo-body.step
keyboards/ffkb/cases/stls/lite/standard/ffkb-lite-choc-5-wireless-body.stl
keyboards/ffkb/cases/stls/lite/standard/ffkb-lite-choc-5-wireless-bot.stl
keyboards/ffkb/cases/stls/lite/standard/ffkb-lite-choc-6-body.stl
keyboards/ffkb/cases/stls/lite/standard/ffkb-lite-choc-6-fox-logo-body.stl
keyboards/ffkb/cases/stls/lite/standard/ffkb-lite-choc-6-no-led-body.stl
keyboards/ffkb/cases/stls/lite/standard/ffkb-lite-choc-6-wireless-body.stl
keyboards/ffkb/cases/stls/lite/standard/ffkb-lite-choc-6-wireless-bot.stl
keyboards/ffkb/cases/stls/lite/standard/ffkb-lite-choc-6-wireless-cirque-35mm-body.stl
keyboards/ffkb/cases/stls/lite/standard/ffkb-lite-mx-5-wireless-body.stl
keyboards/ffkb/cases/stls/lite/standard/ffkb-lite-mx-5-wireless-bot.stl
keyboards/ffkb/cases/stls/lite/standard/ffkb-lite-mx-5-wireless-cirque-35mm-body.stl
keyboards/ffkb/cases/stls/lite/standard/ffkb-lite-mx-6-body.stl
keyboards/ffkb/cases/stls/lite/standard/ffkb-lite-mx-6-cirque-35mm-body.stl
keyboards/ffkb/cases/stls/lite/standard/ffkb-lite-mx-6-vik-xs-mount-body.stl
keyboards/ffkb/cases/stls/lite/standard/ffkb-lite-mx-6-wireless-4.2mm-battery-bot.stl
keyboards/ffkb/cases/stls/lite/standard/ffkb-lite-mx-6-wireless-body.stl
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
