sadekbaroudi/fingerpunch/3d-models/tenting/print-in-place/README.md

# print in place tenting stand

Simply put, this is a print in place tenting stand for devices. You velcro or glue the tenting stand to the back of your device that you want to tent, and you're done!  

Note: The original model / STL is fairly small, and I don't know that FDM printers will be able to print that precisely. In my test, I scaled this model up by 200%. I left the smaller version here, as it's easy to scale up, but you lose resolution as you scale down.  

Also, I left a slight connection between the parts so the stl will be printable in one piece (hence the print in place). On FDM printers, I recommend printing it on its side for the best results (least amount of supports).  

See pictures and video below  

https://github.com/sadekbaroudi/fingerpunch/assets/299248/570b4dae-5ebb-4bdd-9a97-4ad69e94a5aa

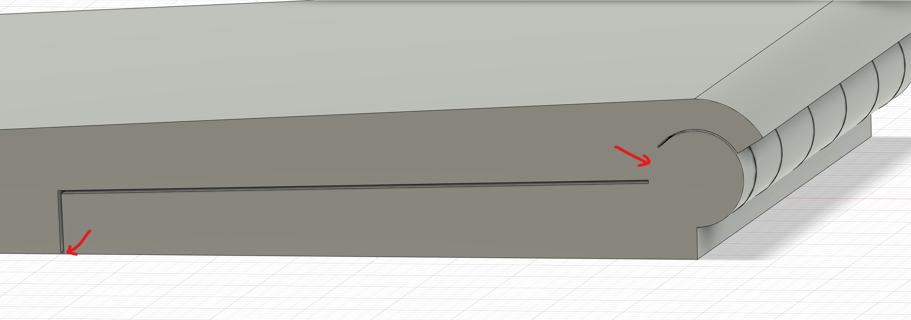
[picture p199: 3d-models/tenting/print-in-place/images/connections.png]
connections


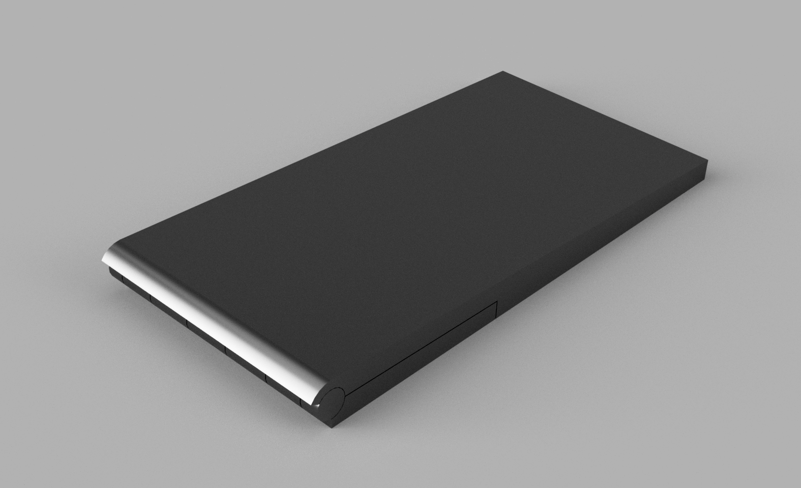
[picture p200: 3d-models/tenting/print-in-place/images/top.png]
top


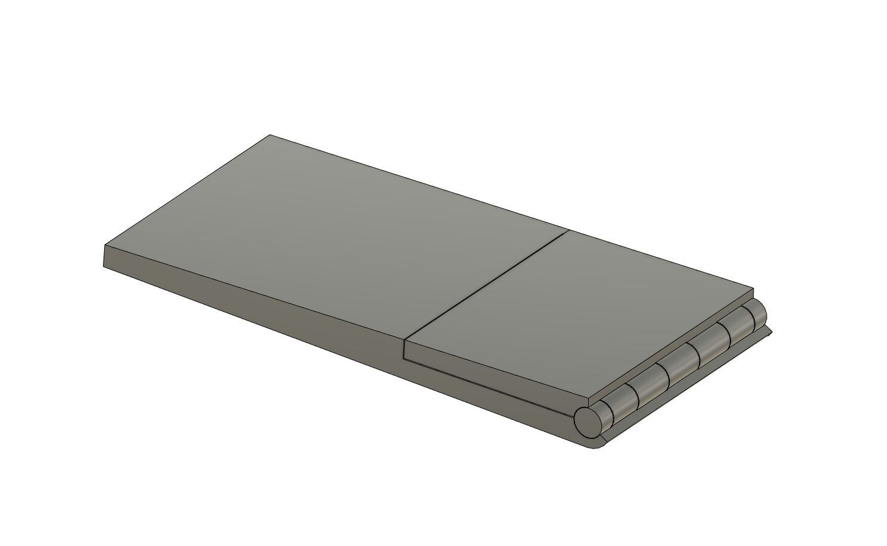
[picture p201: 3d-models/tenting/print-in-place/images/bottom.png]
bottom


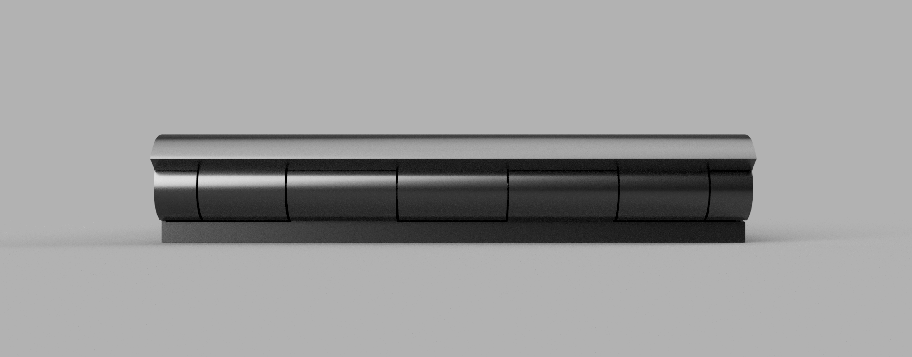
[picture p202: 3d-models/tenting/print-in-place/images/hinges.png]
hinges


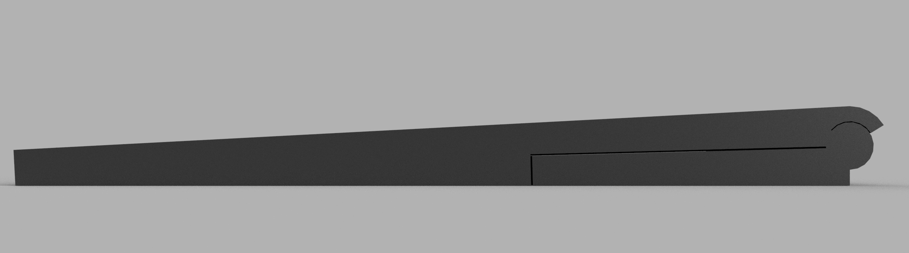
[picture p203: 3d-models/tenting/print-in-place/images/side1.png]
side1


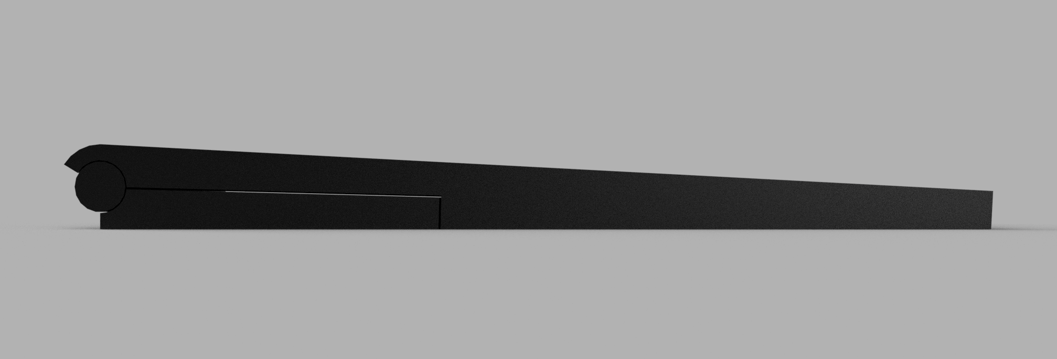
[picture p204: 3d-models/tenting/print-in-place/images/side2.png]
side2


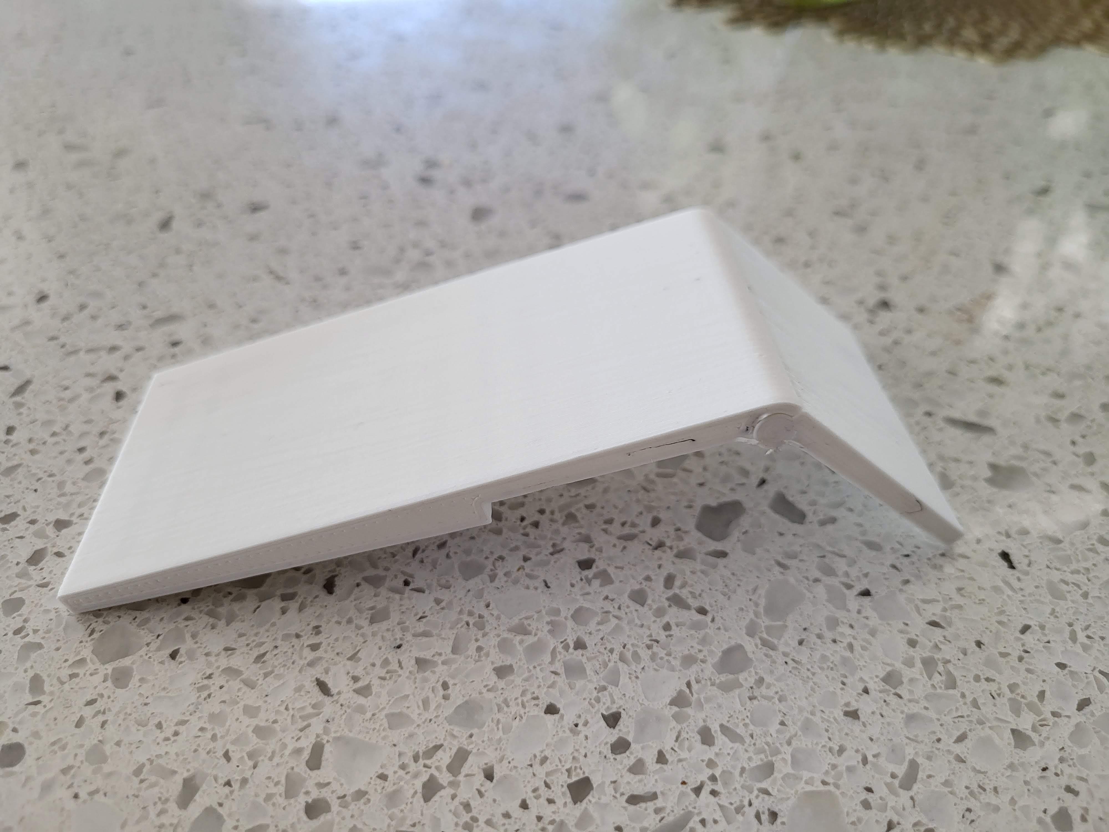
[picture p205: 3d-models/tenting/print-in-place/images/print1.jpg]
print1


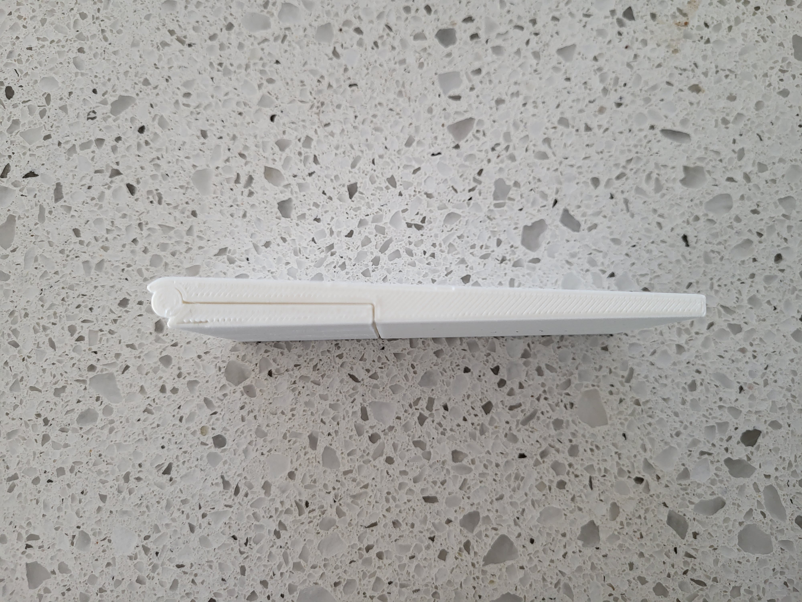
[picture p206: 3d-models/tenting/print-in-place/images/print2.jpg]
print2
