sadekbaroudi/fingerpunch/keyboards/ffkb/cases/stls/v1/center-covers/center-cover-instructions.txt

spiderman: start with black filament, and change color to white at 2.0mm
captain america: start with white filament, change to navy blue at 2.0mm, change to red at 2.8mm
iron man: start with gold filament, change to blue at 2.0mm, change to silver/gray at 2.8mm
