sadekbaroudi/fingerpunch/keyboards/rock-on/v3/mcu-footprint-wire-testing/01.jpg

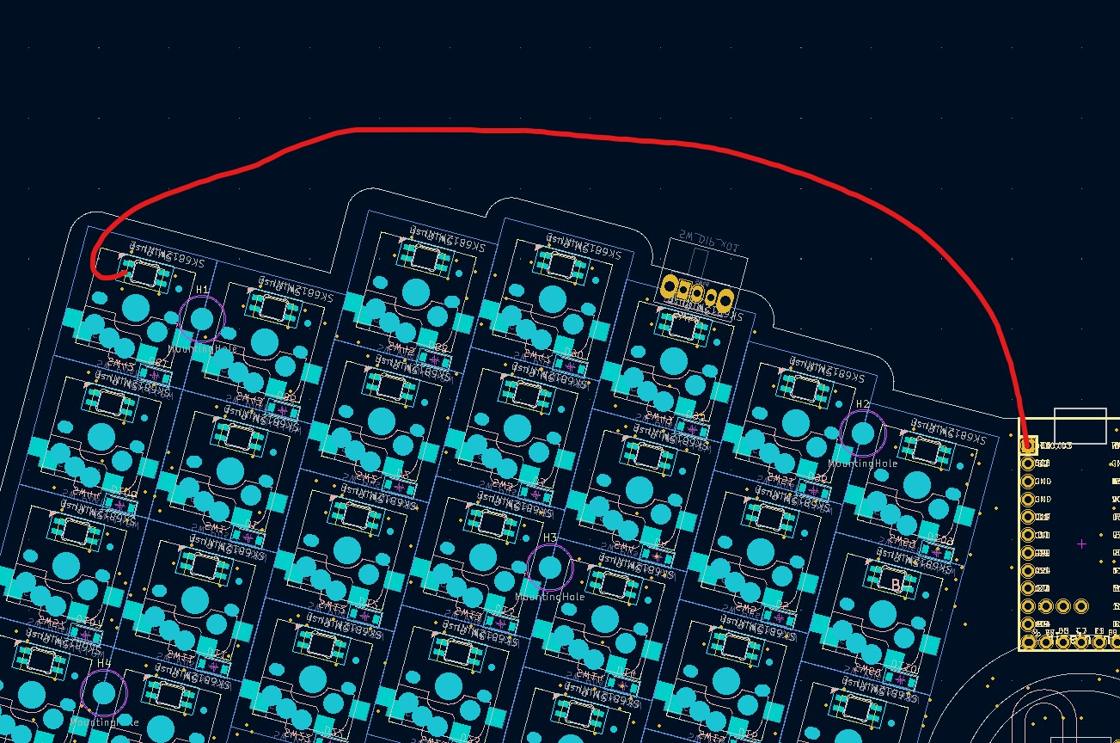
keyboards/rock-on/v3/mcu-footprint-wire-testing/01.jpg
