sadekbaroudi/fingerpunch/keyboards/rock-on/v3/mcu-footprint-wire-testing/02.jpg

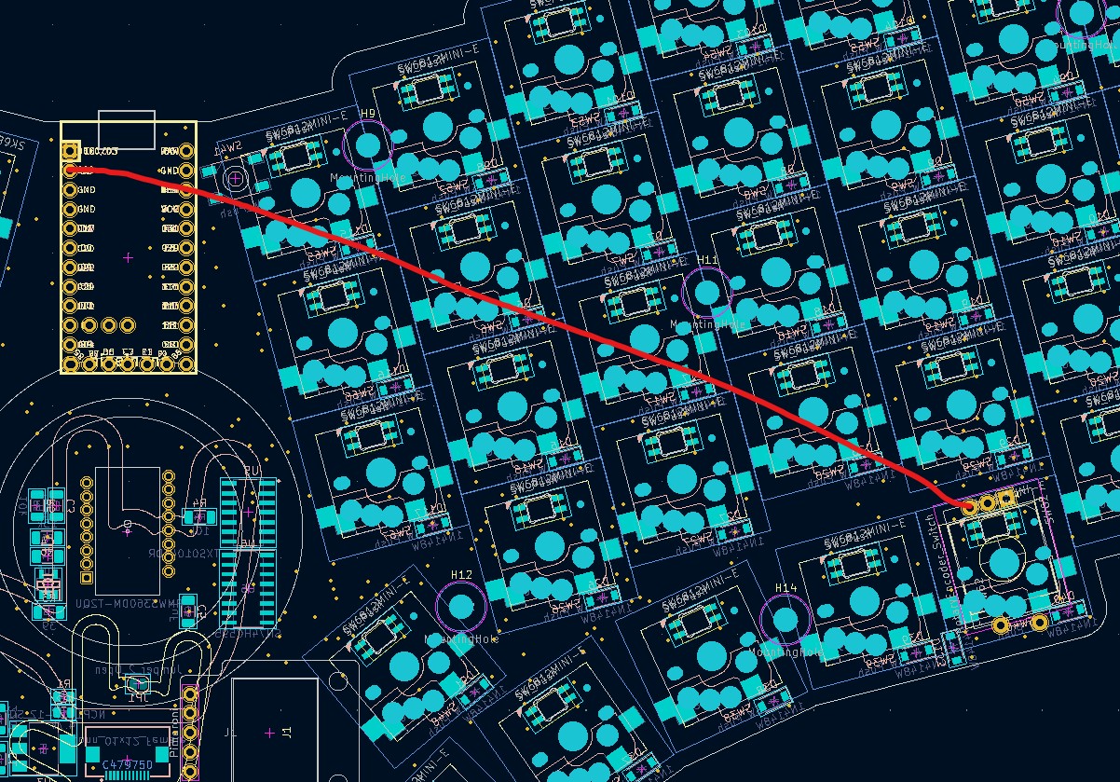
keyboards/rock-on/v3/mcu-footprint-wire-testing/02.jpg
