sadekbaroudi/fingerpunch/keyboards/rock-on/v3/mcu-footprint-wire-testing/03-04-28.jpg

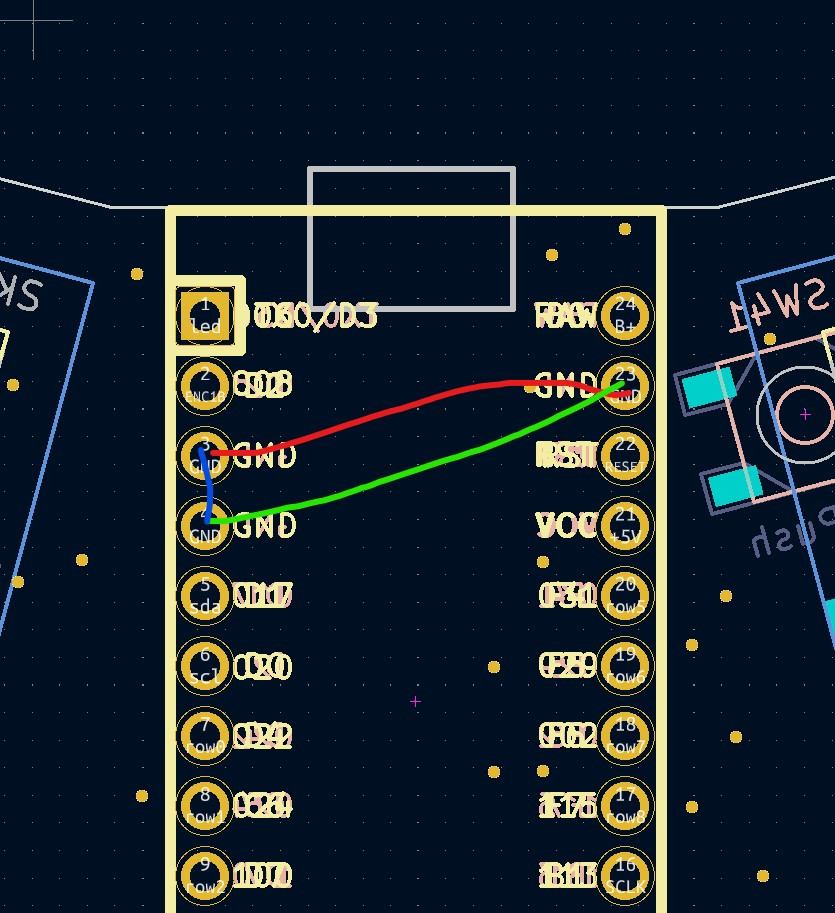
keyboards/rock-on/v3/mcu-footprint-wire-testing/03-04-28.jpg
