sadekbaroudi/fingerpunch/keyboards/rock-on/v3/mcu-footprint-wire-testing/05-06.jpg

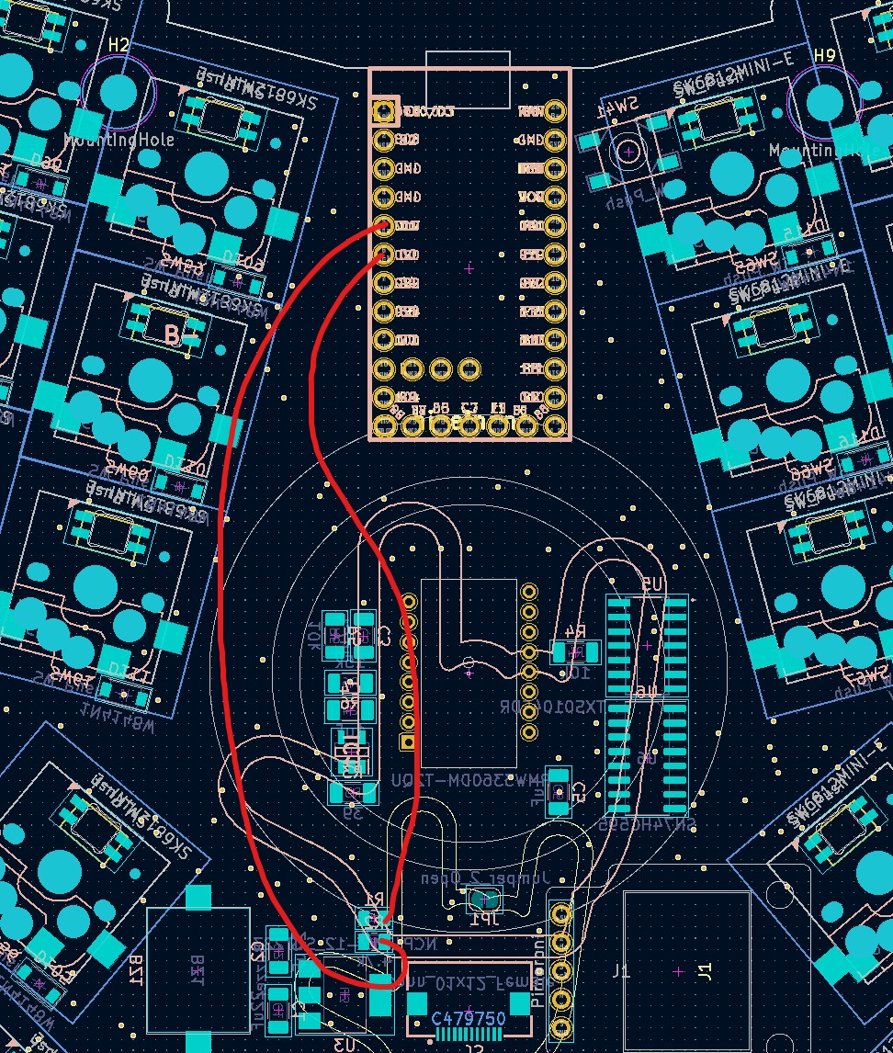
keyboards/rock-on/v3/mcu-footprint-wire-testing/05-06.jpg
