sadekbaroudi/fingerpunch/keyboards/rock-on/v3/mcu-footprint-wire-testing/26.jpg

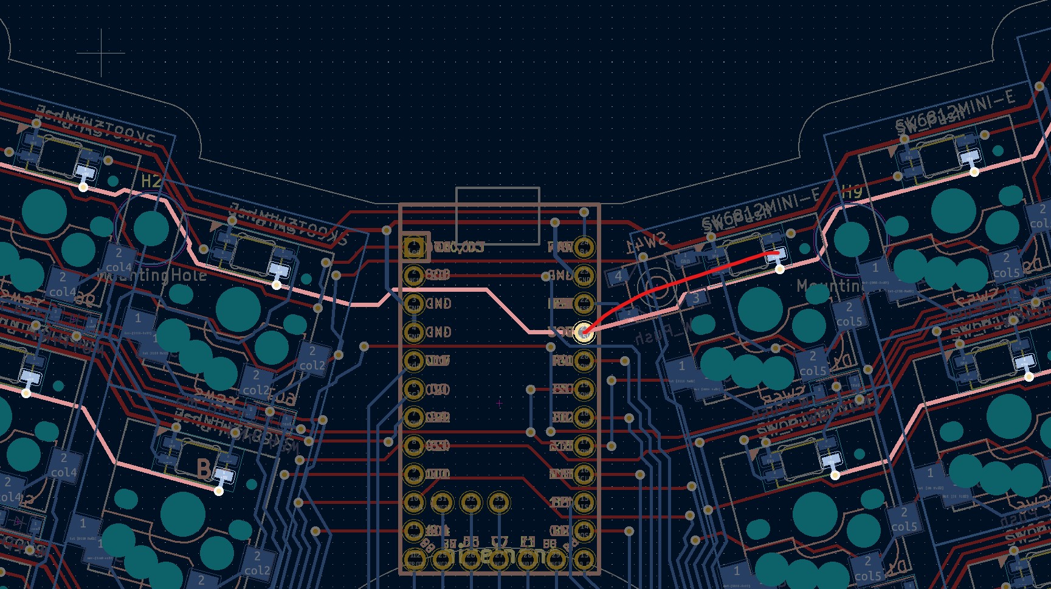
keyboards/rock-on/v3/mcu-footprint-wire-testing/26.jpg
