sadekbaroudi/fingerpunch/kicad/part-measurements/redragon-lowpro-measurements/redragon-lowpro.png

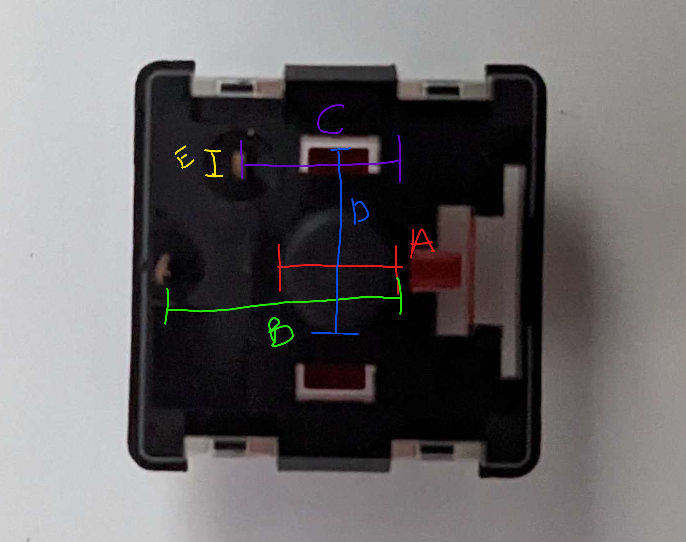
kicad/part-measurements/redragon-lowpro-measurements/redragon-lowpro.png
