sadekbaroudi/fingerpunch/kicad/part-measurements/SK6812_4020_side.jpg

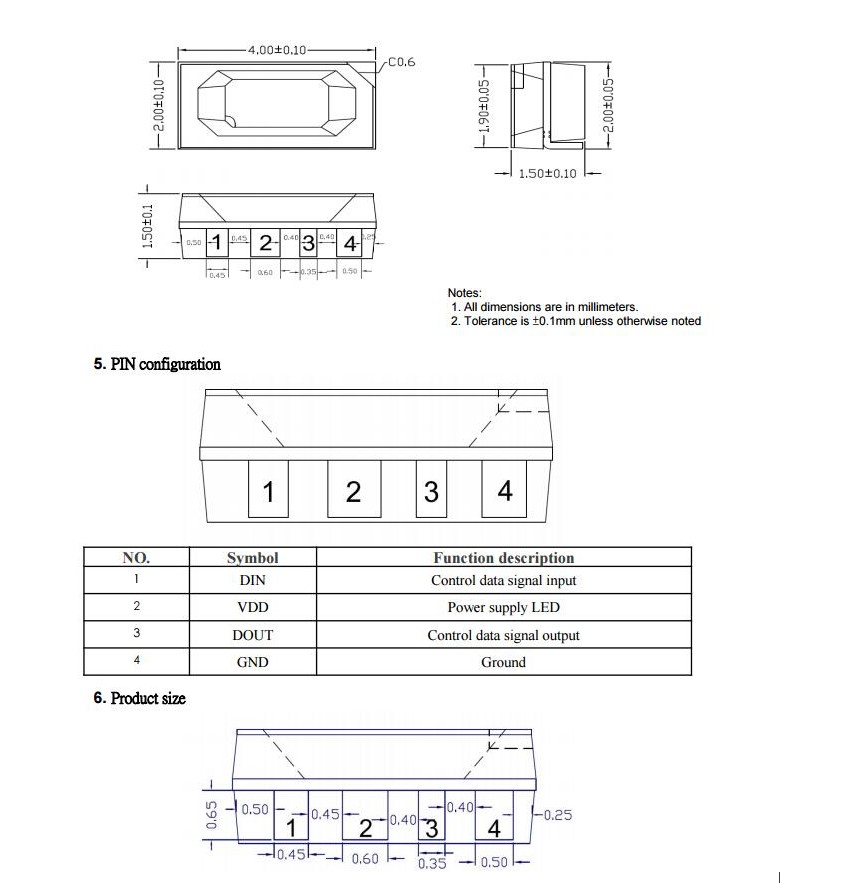
kicad/part-measurements/SK6812_4020_side.jpg
