sadekbaroudi/fingerpunch/keyboards/bigbarobord/big-barobord-layout-tester.pdf

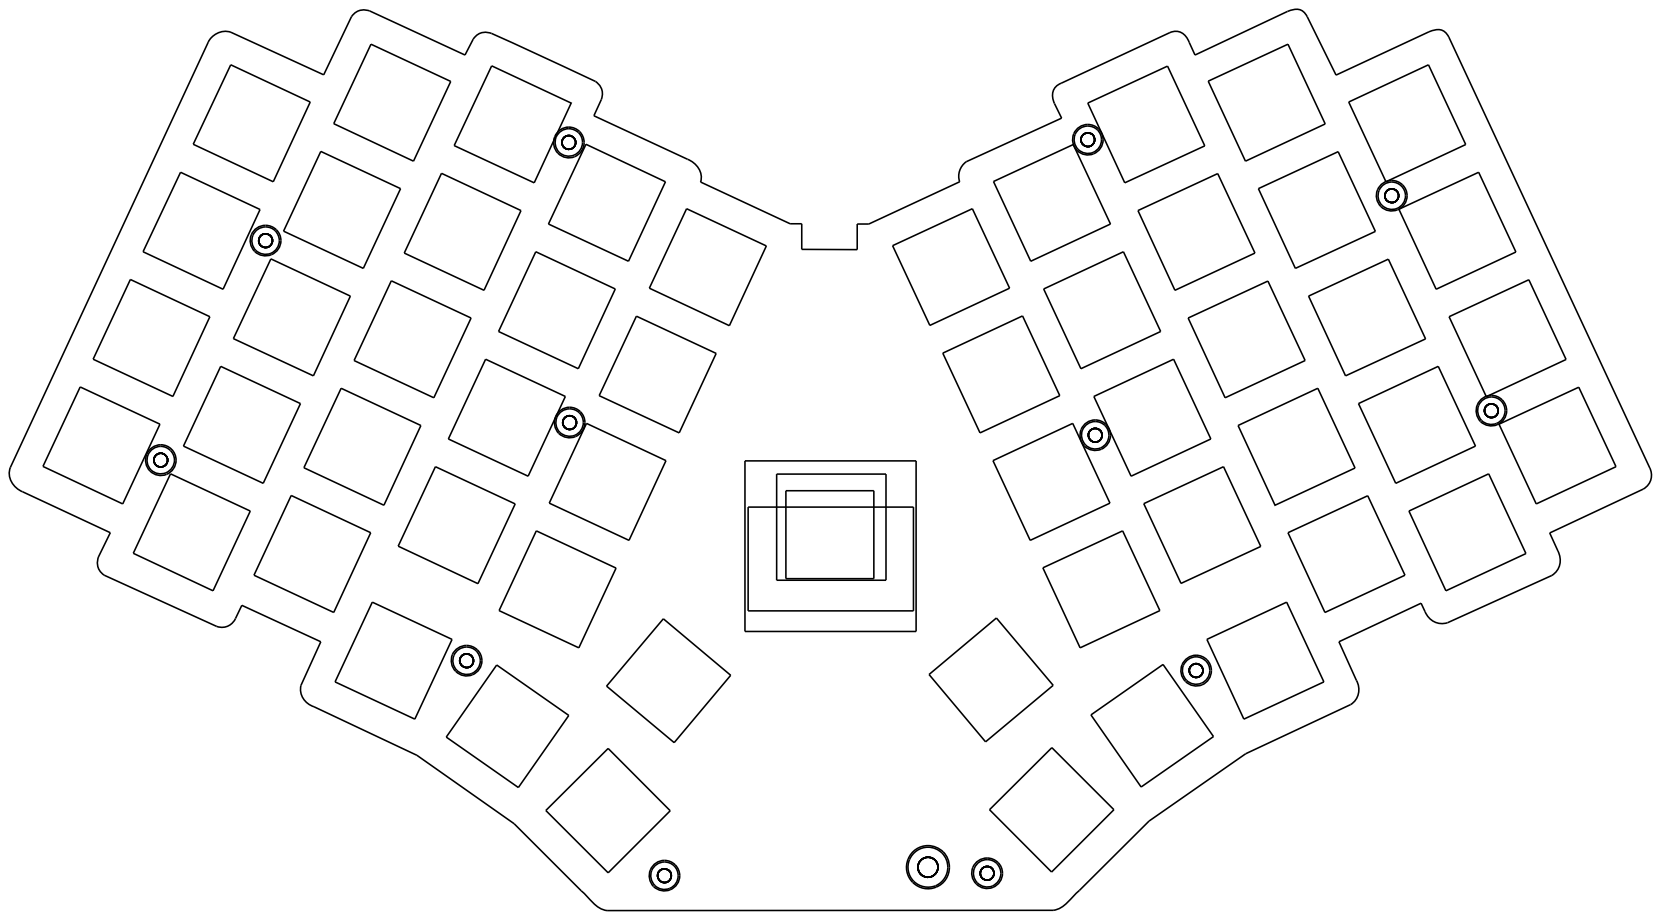
[picture p253: page 1]
