sadekbaroudi/fingerpunch/keyboards/ffkb/ffkb-layout-tester.pdf

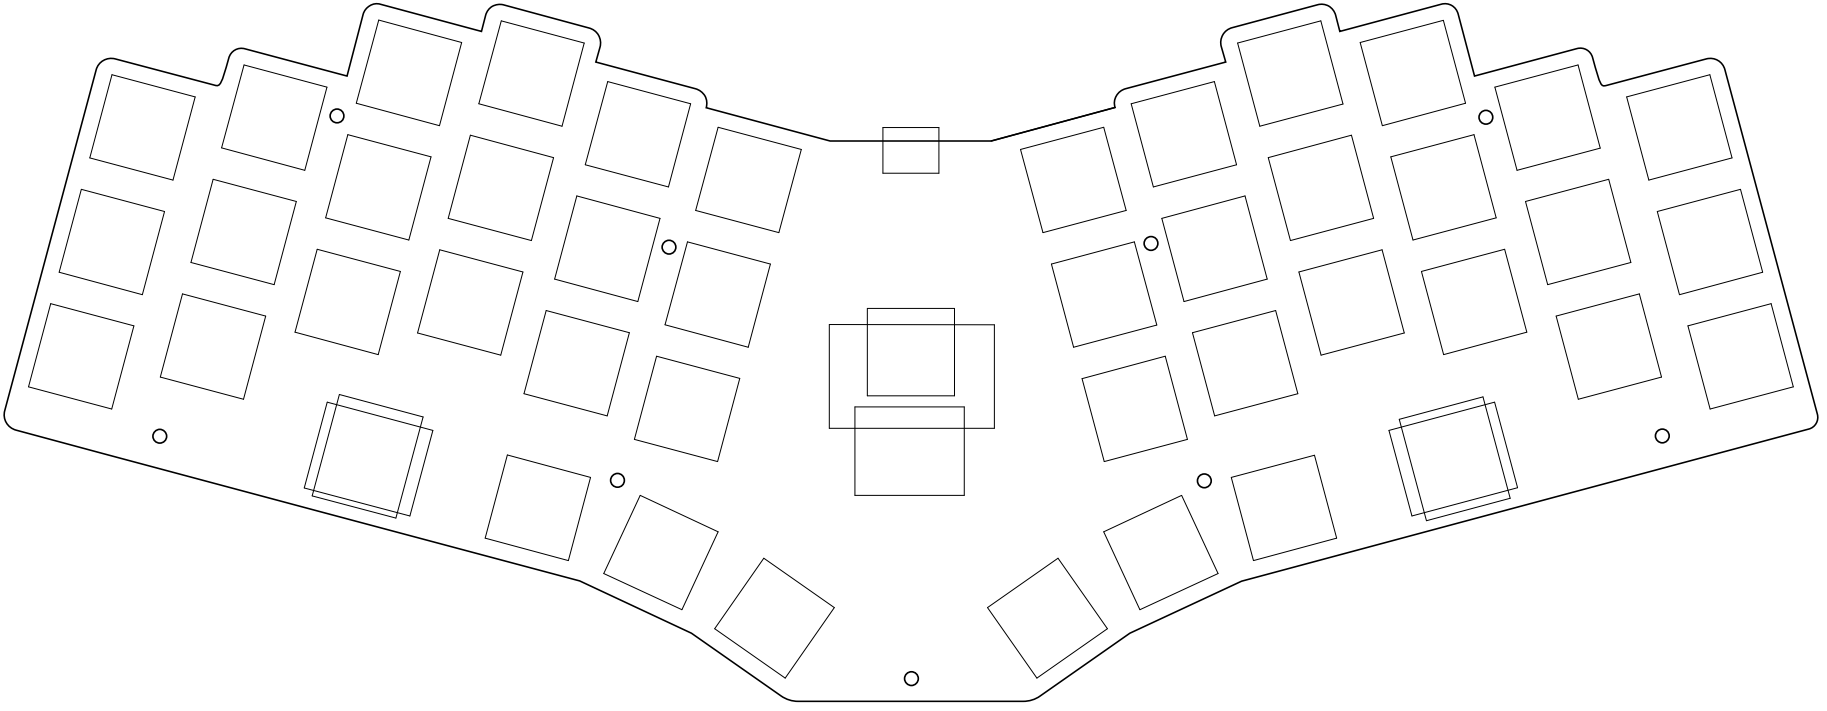
[picture p254: page 1]
