sadekbaroudi/fingerpunch/keyboards/rock-on/rock-on-layout-tester.pdf

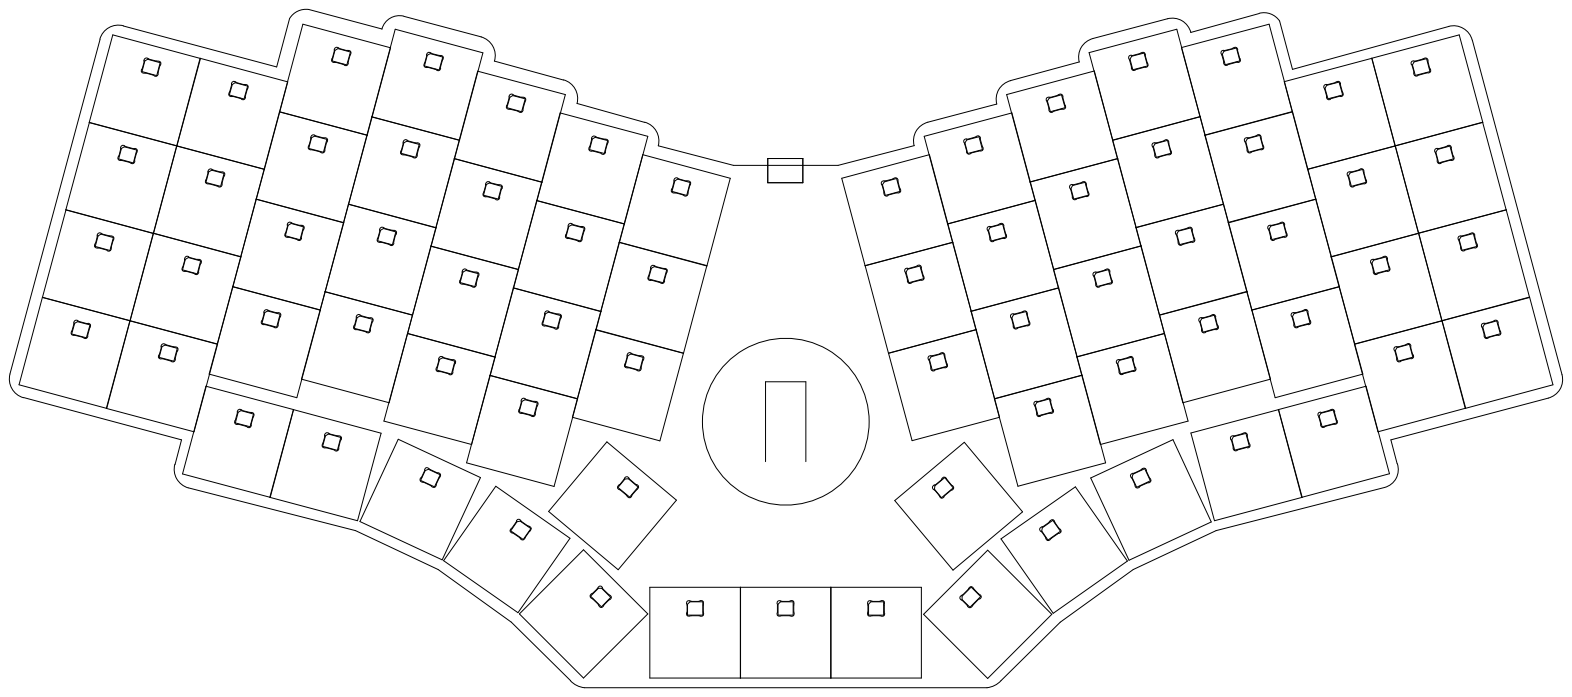
[picture p255: page 1]
