sadekbaroudi/fingerpunch/(commit log)

2022-05-07 a little more clarification around how to solder the OLED to sit flush with the underside of the case
2022-05-07 clarification on header sockets
2022-05-15 fixed the center encoder pin mapping for vial ffkb byomcu
2022-05-18 added comment about R1 resistor on trackpad
2022-05-29 added note about how to install pcb into case
2022-05-29 additional notes on the socket header height depending on the controller usb-c type
2022-05-30 added build video for v2.1 rock on with choc switches and per key leds
2022-06-06 Created new stemcell readme, and moved jumper soldering links to point to the new readme
2022-06-06 added help text for managing fingerpunch code within user's repository
2022-07-11 fflx plate variations
    [fflx-ec-c.stl, fflx-ec-split-left.stl, fflx-ec-split-right.stl, fflx-ec.stl, fflx-ev-c.stl, fflx-ev-split-left.stl, fflx-ev-split-right.stl, fflx-ev.stl]
2022-08-14 added custom led instructions for the ffkb
2022-08-21 added on/off switch reference
2022-08-26 updating stemcell firmware docs since I'm now using the fingerpunch_develop branch
2022-08-28 initial bom for ximi
2022-08-28 fix bom for ximi
2022-08-28 reordered required stuff on top for ximi bom
2022-08-29 added pre-soldered components to BOM
2022-08-29 starting to publish stls for fingerpunch boards
    [5col-bottom-plate.3mf, 5col-bottom-plate.stl, 5col-case-atmega.3mf, 5col-case-byomcu-wireless.3mf, 5col-case-byomcu-wireless.stl, 5col-case-byomcu.3mf, 5col-case-byomcu.stl, 5col-case-holyiot.3mf]
2022-08-29 slight fix to BTU holders in trackball mount
    [ff-h2-6-tr-ec-BTU.stl]
2022-08-30 ffkb v3 trackball case template svg
    [ffkb-v3-6col-trackball-template.dxf]
2022-08-31 ffkb plate stls
    [5col-bottom-plate.3mf, 5col-switchplate-nofeatures.3mf, 6col-bottom-plate.3mf, 6col-switchplate-EVQx2.3mf, ffkb-switchplate-5col-EC11x1-EVQx2.stl, ffkb-switchplate-5col-EC11x1.stl, ffkb-switchplate-5col-EC11x2.stl, ffkb-switchplate-5col-EC11x3.stl]
2022-08-31 ffkb fr4 switch plates
    [5col-EC11x1-EVQx2.kicad_pcb, 5col-EC11x1.kicad_pcb, 5col-EC11x2.kicad_pcb, 5col-EC11x3.kicad_pcb, 5col-EVQx2.kicad_pcb, 5col-OLED-EC11x2.kicad_pcb, 5col-OLED-EVQx2.kicad_pcb, 5col-OLED.kicad_pcb]
2022-09-03 acrylic case trackball cover
    [acrylic-case-trackball-cover.stl]
2022-09-04 updated some v3 case stuff, and added assembly instructions
    [btu-4mm-ball-housing.stl, ff-h2-6-tr-ec-ball-bearings.stl, ff-h2-6-tr-ec-modular.stl, ff-h2-6-tr-ev-BTU.stl, ff-h2-6-tr-ev-modular.stl, ff-h2-6-tr-ne-BTU.stl, ff-h2-6-tr-ne-modular.stl, trackball-housing.stl]
2022-09-04 chewiedies request to add step file for trackball housing to incorporate into some fingerpunch cases
    [trackball-housing.step]
2022-09-06 ffkb modular fr4 plate kicad files
    [ffkb-bottom-plate.kicad_pcb, ffkb-switchplate-template.kicad_pcb, ffkb-switchplate-template.kicad_sch]
2022-09-06 per Malachi's request, keychain hole for ffkb logo
    [ffkb-switchplate-template.kicad_pcb, ffkb-switchplate-template.kicad_sch]
2022-09-06 added stls for center components for ffkb fr4 modular plates
    [ffkb-bottom-plate.kicad_pcb, ffkb-fr4-modular-cirque-cover.stl, ffkb-fr4-modular-trackball-cover.stl, ffkb-switchplate-template-brd.dxf, ffkb-switchplate-template.kicad_pcb, ffkb-switchplate-template.kicad_sch]
2022-09-07 restructured fingerpunch repository, added my footprints
    [5col-EC11x1-EVQx2.kicad_pcb, 5col-EC11x1.kicad_pcb, 5col-EC11x2.kicad_pcb, 5col-EC11x3.kicad_pcb, 5col-EVQx2.kicad_pcb, 5col-OLED-EC11x2.kicad_pcb, 5col-OLED-EVQx2.kicad_pcb, 5col-OLED.kicad_pcb]
2022-09-11 test cases for ximi, do not use until sadek confirms
    [xi-6-3wt-right.stl, xi-6-c-3wt-left.stl]
2022-09-12 fixed mcu collision when using headers, reduced cutout for 3 way thumb switch, fixed cutout for trrs and mcu
    [xi-6-3wt-right.stl, xi-6-c-3wt-left.stl]
2022-09-14 Fix typo and switch to use master instead
2022-09-14 more ximi case updates
    [xi-6-bottom-plate.stl, xi-6-c-3wt-right.stl]
2022-09-15 added detail around the 4mm balls that I tested for the BTUs
2022-09-17 experimental ximi trackball cases
    [xi-6-tr-3wt-left.stl, ximi-trackball-cover.stl]
2022-09-19 updated trackball cover to snap in better
    [ximi-trackball-cover.stl]
2022-10-01 converting relevant lines to User.Comments for svg exports for convenient case modeling, see rock on v3 kicad layout for example
2022-10-01 test modular case for rock on v3 case
    [ro-h3-modular.stl]
2022-10-02 added trackball cover, moved case files, added trackball housing and BTU housing
    [btu-4mm-ball-housing.stl, ro-h3-modular.stl, ro-h3-trackball-cover.stl, trackball-housing.step, trackball-housing.stl]
2022-10-03 ffkb v3 first pcbs encoder fix
2022-10-09 added trackball covers with more exposure
    [ff-h2-tr-cover-tri-exposure.stl, ro-h3-tr-cover-tri-exposure.stl, ro-h3-tr-cover.stl]
2022-10-09 added all rock on cases to the fingerpunch repo
    [body-circque-encoders-center.3mf, body-circque-encoders-none.3mf, body-circque-encoders-palm.3mf, body-no-oled.3mf, body-oled-encoders-center.3mf, body-oled-encoders-none.3mf, body-oled-encoders-palm.3mf, body-oled.3mf]
2022-10-10 updated trackball cover for acrylic case, and added tri-exposure version
    [acrylic-case-trackball-cover-tri-exposure.stl, acrylic-case-trackball-cover.stl]
2022-10-11 added another low pro v2 case with no cirque
    [ff-ul-6-n-ec-tall-battery.stl, ff-ul-6-n-ev-tall-battery.stl]
2022-10-14 added a low pro cirque rock on v3 case
    [ro-v3-ul-bot.stl, ro-v3-ul-cir-ch.stl]
2022-10-15 added a new case for an ffkb v1 order, mid profile, low height for integrated atmega, no encoders
    [ff-m1-6-ne-ch-atmega.stl]
2022-10-16 added rock on v3 hi pro bottom plate
    [ro-h3-modular-bottom-plate.stl]
2022-10-17 center covers for ffkb v1 case as stls
    [center-cover-captain-america.stl, center-cover-ec11.stl, center-cover-ironman.stl, center-cover-no-feature.stl, center-cover-oled.stl, center-cover-pimoroni.stl, center-cover-spiderman.stl]
2022-10-17 ffkb v3 trackball case now in 5 column
    [ff-h2-5-bot.stl, ff-h2-5-tr-ec-modular.stl, ff-h2-5-tr-ev-modular.stl, ff-h2-5-tr-ne-modular.stl, ff-h2-6-bot.stl]
2022-10-25 more footprints and symbols
2022-11-01 added wiring screenshots to help people test the pcb wiring from the controller footprint
2022-11-08 added luakeeb case and assembly instructions
    [body.3mf, body.stl, bottom-plate.3mf, bottom-plate.stl]
2022-11-08 added a few new versions of the trackball housing
    [trackball-housing-trimmed-with-BTU.stl, trackball-housing-trimmed.stl, trackball-housing-with-BTU.stl]
2022-11-08 added trimmed housing step file
    [trackball-housing-trimmed.step]
2022-11-09 added step files for trackball housings with built in BTU
    [trackball-housing-trimmed-with-BTU.step, trackball-housing-with-BTU.step]
2022-11-16 added mx only and choc only footprints for reversible with per key leds
2022-11-22 added through hole / smd diode footprint
2022-11-27 fixed ffkb v3 trackball cover with tri exposure
    [ff-h2-tr-cover-tri-exposure.stl]
2022-11-27 reversible gateron ks-27 switch footprints
2022-11-29 rock on v3.1 rotary encoder center notes
2022-11-30 added a couple of alps footprints
2022-11-30 fixed up layers for footprints to be easier to export svg
2022-11-30 added trackball case assembly guide
2022-12-07 ffkb oled case and instructions, and new kicad footprints
    [ff-ul-5-oled-ch-w-template.step, ff-ul-5-oled-ec-ch-w.stl, ff-ul-5-oled-ec-ch.stl, ff-ul-5-oled-ec-mx-w.stl, ff-ul-5-oled-ec-mx.stl, ff-ul-5-oled-ev-ch-w.stl, ff-ul-5-oled-ev-ch.stl, ff-ul-5-oled-ev-mx-w.stl]
2022-12-07 rock on v2 cirque and led low pro mx case
    [ro-ul-cir-oled-mx.stl]
2022-12-13 led ring low pro case for ffkb
    [ff-ledring-5col-body.stl, ff-ledring-5col-bottom.stl, ff-ledring-6col-body.stl, ff-ledring-6col-bottom.stl, led-ring-cover-4x.stl, led-ring-cover.stl]
2022-12-13 rock on low pro oled bottom plate
    [ro-ul-cir-oled-bot-plate.stl]
2022-12-13 series of ffkb low pro 5 column oled cases
    [ff-ul-5-oled-ec-ch-w.stl, ff-ul-5-oled-ec-ch.stl, ff-ul-5-oled-ec-mx-w.stl, ff-ul-5-oled-ec-mx.stl, ff-ul-5-oled-ev-ch-w.stl, ff-ul-5-oled-ev-ch.stl, ff-ul-5-oled-ev-mx-w.stl, ff-ul-5-oled-ev-mx.stl]
2022-12-13 made case a bit taller, as it was a bit too short
    [ff-ledring-5col-3mm-bottom.stl, ff-ledring-5col-6mm-body.stl, ff-ledring-6col-3mm-bottom.stl, ff-ledring-6col-6mm-body.stl, led-ring-cover-4x.stl]
2022-12-15 redragon smd mx low pro 2 pin footprint
2022-12-18 chunky low profile case, modeled after the led ring case, but without the opening
    [ff-lp-chunky-5-body.stl, ff-lp-chunky-6-body.stl]
2022-12-20 made some tall center 5 col cases, fits battery on top of the controller, and low profile underneath
    [ff-ul-5-n-ev-ch-minimal-tall-center-10mm.stl, ff-ul-5-n-ev-ch-minimal-tall-center-11mm.stl, ff-ul-5-n-ev-ch-minimal-tall-center-12mm.stl, ff-ul-5-n-ev-ch-minimal-tall-center-8mm.stl, ff-ul-5-n-ev-ch-minimal-tall-center-9mm.stl]
2022-12-20 ec-11 encoder knobs
    [angry-robot.stl, chamfered.stl, rounded-pocket.stl, rounded.stl, simple.stl, wobble-wave.stl]
2022-12-20 needed to recess the D part of the shaft a bit
    [angry-robot.stl, chamfered.stl, rounded-pocket.stl, rounded.stl, simple.stl, wobble-wave.stl]
2022-12-23 updated ec11 knobs to have better mounting
    [angry-robot.stl, chamfered.stl, rounded-pocket.stl, rounded.stl, simple.stl, wobble-wave.stl]
2022-12-23 added some switchplates that support top mount controller
    [ffkb-topmount-switchplate-5col-EC11x2.stl, ffkb-topmount-switchplate-5col-EVQx2.stl, ffkb-topmount-switchplate-5col-nofeatures.stl]
2022-12-24 added a new euclid36 case
    [euclid36-bottom-plate.stl, euclid36-recessed-with-led-holes.stl]
2022-12-25 pinkies out plates
    [bottomplate-B_Cu.gbr, bottomplate-B_Mask.gbr, bottomplate-B_Paste.gbr, bottomplate-B_Silkscreen.gbr, bottomplate-Edge_Cuts.gbr, bottomplate-F_Cu.gbr, bottomplate-F_Mask.gbr, bottomplate-F_Paste.gbr]
2022-12-25 added cirque modular attachment for plates
    [pinkies-out-cirque-attachement.stl]
2022-12-26 led ring cover update
    [led-ring-cover.stl]
2022-12-26 added simple mx soldered footprint
2022-12-26 rock on svgs
    [v2-general-template-brd.dxf, v2-topmount-general-template-brd.dxf, v2-topmount-general-template-for-acrylic-2.2mm-center-mount.dxf, v2-topmount-general-template-for-acrylic.dxf, v2-topmount-pcb-only-for-acrylic-2.2mm-center-mount.dxf, v3-template.dxf]
2022-12-29 added led ring covers with fingerpunch logo on them
    [led-ring-cover-fp-logo-4x.stl, led-ring-cover-fp-logo.stl]
2023-01-02 more footprints
2023-01-04 added rectangular ffkb case and lp chunky bottom plates
    [ff-ledring-6col-body-rectangle.stl, ff-ledring-6col-bottom-rectangle.stl, ff-lp-chunky-5-bottom.stl, ff-lp-chunky-6-body-rectangle.stl, ff-lp-chunky-6-bottom-rectangle.stl, ff-lp-chunky-6-bottom.stl]
2023-01-04 adafruit neopixel 5mm bulb and 1x1 THT kicad footprints
2023-01-04 added a couple more rectangular cases for the 5 column
    [ff-ledring-5col-body-rectangle.stl, ff-ledring-5col-bottom-rectangle.stl, ff-lp-chunky-5-body-rectangle.stl, ff-lp-chunky-5-bottom-rectangle.stl]
2023-01-04 added EC11 versions, and cleaned up the extra opening at the bottom of the case for the ec11 encoder even though it wasn't there
    [ff-ledring-5col-EC11-body-rectangle.stl, ff-ledring-5col-body-rectangle.stl, ff-ledring-5col-body.stl, ff-ledring-5col-ec11-body.stl, ff-ledring-6col-EC11-body-rectangle.stl, ff-ledring-6col-body-rectangle.stl, ff-ledring-6col-body.stl, ff-ledring-6col-ec11-body.stl]
2023-01-04 fixed usb-c hole for 5 col rectangle cases
    [ff-ledring-5col-EC11-body-rectangle.stl, ff-ledring-5col-body-rectangle.stl, ff-lp-chunky-5-EC11-body-rectangle.stl, ff-lp-chunky-5-body-rectangle.stl]
2023-01-05 expanded the cutouts to better fit the controller
    [ro-h3-modular.stl, ro-h3-tr-cover-tri-exposure.stl, ro-h3-tr-cover.stl]
2023-01-11 copied ffkb trackball housings to rock on directory to avoid confusion
    [trackball-housing-trimmed-with-BTU.stl, trackball-housing-trimmed.stl, trackball-housing-with-BTU.stl]
2023-01-12 adding ffkb trackball case for low profile switches
    [ff-L2-5-bot.stl, ff-L2-5-tr-ne-modular.stl, ff-L2-6-bot.stl, ff-L2-6-tr-ne-modular.stl]
2023-01-22 added a prototype footprint that supports ks27, choc v1, and mx hotswap
2023-01-24 added custom zazu scroll ring, provided to me by Mabroum
    [scroll-ring-for-fingerpunch-trackball-housing.stl]
2023-01-28 made the ffkb v3 encoder fix clearer
2023-02-02 stenographobe cases
    [stenographobe-body-choc.stl, stenographobe-body-mx.stl, stenographobe-bottom-plate.stl]
2023-02-02 more lowpro chunky cases
    [ff-lp-chunky-5-bottom-rectangle-3mm.stl, ff-lp-chunky-6-bottom-rectangle-3mm.stl, ff-lp-chunky-6-cirque-body.stl]
2023-02-04 added unrecessed thumb versions of ffkb rectangle case, made for MX boards
    [ff-ledring-5col-EC11-body-rectangle-unrecessed-thumb.stl, ff-ledring-5col-body-rectangle-unrecessed-thumb.stl, ff-ledring-5col-bottom-rectangle-3mm.stl, ff-ledring-6col-EC11-body-rectangle-unrecessed-thumb.stl, ff-ledring-6col-body-rectangle-unrecessed-thumb.stl, ff-ledring-6col-bottom-rectangle-3mm.stl, ff-lp-chunky-5-EC11-body-rectangle-unrecessed-thumb.stl, ff-lp-chunky-5-body-rectangle-unrece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]
2023-02-08 rock on low pro modular and flat cover
    [ro-h3-flat-cover.stl, ro-h3-modular-choc-recessed-thumbs.stl]
2023-02-12 ffkb low profile trackball case with space and mount for usb-c extension
    [ff-L2-6-tr-ne-hsusb-modular.stl]
2023-02-12 arc reactor emblem for ffkb chunky case series
    [led-ring-arc-reactor-4x.stl, led-ring-arc-reactor.stl]
2023-02-15 fixed ks27-choc-mx hotswap footprint, and added a reversible choc with sk6812 mini, used in klor choc hotswap pcb
2023-02-15 added a couple of low profile cases that can be used with a hand soldered usb-c connector
    [ff-L2-5-hsusb-bot.stl, ff-L2-6-hsusb-bot.stl]
2023-02-16 fixed low pro trackball case to lower trackball by 0.5mm, and added 5 col version
    [ff-L2-5-tr-ne-hsusb-modular.stl, ff-L2-5-tr-ne-modular.stl, ff-L2-6-tr-ne-hsusb-modular.stl, ff-L2-6-tr-ne-modular.stl]
2023-02-18 added a no mount version of the charybdis breakout board
2023-02-22 first attempt at ultra low pro modular case
    [ro-v3-ul-modular.stl, ro-v3-ul-ne-modular.stl]
2023-02-22 new rock on cases, choc modular, and series of rectanglar modular rock on cases
    [ro-h3-choc-modular.stl, ro-h3-choc-ne-modular.stl, ro-h3-choc-ne-rectangular-modular.stl, ro-h3-choc-rectangular-modular.stl, ro-h3-modular-choc-recessed-thumbs.stl, ro-h3-mx-modular.stl, ro-h3-mx-rectangular-modular.stl, ro-h3-rectangular-bottom.stl]
2023-02-22 more rock on options, and led ring logo
    [led-ring-cover-storytel.stl, ro-h3-choc-tallbacklip-ne-modular.stl, ro-v3-choc-ne-modular.stl]
2023-02-23 v3 high pro choc to v2 cirque adapter
    [ro-v3-choc-tallbacklip-modular-v2-cirque-cover.stl]
2023-02-23 atari led ring
    [led-ring-arc-atari.stl]
2023-02-23 version of rock on choc v2 modular cover that's better for 3D printing
    [ro-v3-choc-tallbacklip-modular-v2-cirque-cover-for-3D-printing-with-supports.stl]
2023-02-27 added rock on v2 choc high pro case, and renamed existing cases to MX
    [ro-v2-choc-cir-ne.stl, ro-v2-choc-cir.stl, ro-v2-mx-cir-ec.3mf, ro-v2-mx-cir-w.3mf, ro-v2-mx-cir-w.stl, ro-v2-mx-cir.3mf, ro-v2-mx-cir.stl, ro-v2-mx-ec.3mf]
2023-03-05 added new USB-c footprint that's better for svg exports from kicad
2023-03-05 updated and new ffkb case stls
    [ff-ul-5-n-ne-mx-w.stl, ff-ul-6-bot.stl, ff-ul-6-n-ne-mx-w.stl]
2023-03-06 starting to put together ximi cases for the rp2040 version, now called v1
    [xi-6-3wt-right.stl, xi-6-bottom-plate.stl, xi-6-c-3wt-left.stl, xi-6-c-3wt-right.stl, xi-6-choc-c-ec-3wt-left.stl, xi-6-choc-c-ec-3wt-right.stl, xi-6-tr-3wt-left.stl, ximi-trackball-cover.stl]
2023-03-14 added new ximi cases, and updated 6 col cirque case
    [xi-6-choc-c-ec-3wt-left.stl, xi-6-choc-c-ec-3wt-right.stl, xi-6-mx-tr-ec-3wt-left.stl, xi-bot-2.8mm-cirque-left.stl, xi-bot-2.8mm-left.stl, xi-bot-cirque-left.stl, xi-bot-left.stl, xi-trackball-cover.stl]
2023-03-14 added ximi 6 column trackball bottom plates
    [xi-bot-2.8mm-trackball-left.stl, xi-bot-trackball-left.stl]
2023-03-15 added 3 variations of the ximi trackball cover to accommodate a good pressure fit using different printers
    [xi-trackball-cover-slim-bottom-edge.stl, xi-trackball-cover-wide-bottom-edge.stl, xi-trackball-cover.stl]
2023-03-16 added trackball cover with even wider bottom edge, this one works best on my snapmaker A350T
    [xi-trackball-cover-wider-bottom-edge.stl]
2023-03-16 added new ultra low profile case for rock on v3 with no center feature, and wireless support
    [ro-v3-ul-bot-w.stl, ro-v3-ul-n-ch-w.stl, ro-v3-ul-n-ch.stl]
2023-03-18 new footprints and updated neopixel bulb footprint from adafruit
2023-03-19 added gateron low profile KS-27, choc v1, mx footprint that is hotswap and solderable
2023-03-19 moved silks to the bottom of the pcb since that's where you're soldering it
2023-03-20 added stenographobe plates
    [stenographobe-fatplate-mx.stl, stenographobe-plate-choc.stl]
2023-03-22 adding basic mx tenbit case and plate
    [tenbit-fatplate-mx.stl, tenbit-preonic-rev3-case-mod.stl]
2023-03-23 tenbit case with cirque holder
    [tenbit-preonic-rev3-case-mod-with-cirque.stl]
2023-03-25 ximi - adding 5 column cases, and more 6 column options
    [xi-5-bot-2.8mm-left.stl, xi-5-bot-2.8mm-trackball-left.stl, xi-5-bot-left.stl, xi-5-bot-trackball-left.stl, xi-5-mx-tr-ec-3wt-left.stl, xi-5-mx-tr-ec-left.stl, xi-5-mx-tr-ne-3wt-left.stl, xi-5-mx-tr-ne-left.stl]
2023-03-28 new luakeeb case
    [body-hp-ec11.stl, body-hp.stl, bottom-plate-hp.stl]
2023-03-28 ffkb lite case
    [ffkb-lite-6-body.stl, ffkb-lite-6-bot.stl, ffkb-lite-6-no-led-body.stl]
2023-03-30 some case updates, euclid36 new case and ffkb lite updates to make it a bit taller
    [euclid36-large-hole-cover.stl, euclid36-recessed-with-large-hole.stl, ffkb-lite-6-body.stl, ffkb-lite-6-no-led-body.stl]
2023-03-30 fixed ffkb lite to bet better suited for indicator leds, and made top mount USB exposed
    [ffkb-lite-6-body.stl, ffkb-lite-6-no-led-body.stl]
2023-03-30 added dxf for hole cover
    [euclid36-large-hole-cover.dxf]
2023-03-31 added fox logo case for ffkb lite
    [ffkb-lite-6-fox-logo-body.stl]
2023-04-12 adding some ximi step files so people can modify if they like
    [xi-5-bot-2.8mm-trackball-left.step, xi-5-mx-tr-ec-3wt-left.step, xi-6-bot-2.8mm-trackball-left.step, xi-6-mx-tr-ec-3wt-left.step, xi-trackball-cover.step]
2023-04-12 restructured ximi directory
    [xi-5-bot-2.8mm-left.stl, xi-5-bot-2.8mm-trackball-left.step, xi-5-bot-2.8mm-trackball-left.stl, xi-5-bot-left.stl, xi-5-bot-trackball-left.stl, xi-5-mx-tr-ec-3wt-left.step, xi-5-mx-tr-ec-3wt-left.stl, xi-5-mx-tr-ec-left.stl]
2023-04-17 ffkb high pro cirque with evq on left only
    [ff-h2-5-c-ev-left-only.stl]
2023-04-17 more ximi cases, choc cirque no encoder, and 25mm trackball case prototypes
    [xi-6-choc-c-ne-3wt-left.stl, xi-6-choc-c-ne-3wt-right.stl, xi-6-choc-tr-25mm-ne-3wt-left.stl, xi-6-mx-tr-25mm-ne-3wt-left.stl, xi-trackball-25mm-choc-cover.stl, xi-trackball-25mm-mx-cover.stl]
2023-04-17 ximi cases, added mx cirque cases
    [xi-6-mx-c-ec-left.stl, xi-6-mx-c-ec-right.stl, xi-6-mx-c-ne-left.stl, xi-6-mx-c-ne-right.stl]
2023-04-18 added annotated breakout pins for ximi v1 pcb
2023-04-18 added more annotation for led strips for ximi pcb
2023-04-18 added no pointing device cases for ximi
    [xi-6-choc-np-ec-3wt-left.stl, xi-6-choc-np-ne-3wt-left.stl, xi-6-mx-np-ec-3wt-left.stl, xi-6-mx-np-ne-3wt-left.stl]
2023-04-18 added some more 25mm trackball covers for ximi
    [xi-trackball-25mm-choc-taller-cover.stl, xi-trackball-25mm-mx-cover.stl, xi-trackball-25mm-mx-taller-cover.stl]
2023-04-21 added new sideways mounted addressable led, provided by klackygears
2023-04-25 expanded 34mm trackball cases to better accommodate the fingerpunch trackball sensor pcb
    [xi-5-mx-tr-ec-3wt-left.stl, xi-5-mx-tr-ec-3wt-right.stl, xi-5-mx-tr-ne-3wt-left.stl, xi-5-mx-tr-ne-3wt-right.stl, xi-6-mx-tr-ec-3wt-left.stl, xi-6-mx-tr-ec-3wt-right.stl, xi-6-mx-tr-ne-3wt-left.stl, xi-6-mx-tr-ne-3wt-right.stl]
2023-04-25 ximi cases, added 5 column no pointing device cases
    [xi-5-mx-np-ec-3wt-left.stl, xi-5-mx-np-ne-3wt-left.stl]
2023-04-25 ffkb lite step files
    [ffkb-lite-6-bot.step, ffkb-lite-6-fox-logo-body.step]
2023-04-26 added 7 degree tented bottom plate
    [euclid36-7deg-tent-bottom-plate.stl]
2023-04-27 added a filet to the euclid36 tented bottom plate
    [euclid36-7deg-tent-bottom-plate.stl]
2023-05-02 added a few more usb-c footprints
2023-05-02 added clearer instructions for which files to use in ximi v1 case
    [xi-6-bot-2.8mm-cirque-left.stl, xi-6-bot-2.8mm-left.stl, xi-6-bot-2.8mm-trackball-left.stl, xi-6-bot-cirque-left.stl, xi-6-bot-left.stl, xi-6-bot-trackball-left.stl]
2023-05-04 experimental trackball thumb case, only in 6 column for now, both choc and mx support
    [xi-6-bottom-trth.stl, xi-6-choc-trth-ec-left.stl, xi-6-choc-trth-ne-left.stl, xi-6-mx-trth-ec-left.stl, xi-6-mx-trth-ne-left.stl]
2023-05-06 tenbit 4x12 choc case
    [tenbit-4x12-bot.stl, tenbit-4x12-choc.stl]
2023-05-06 added reset and bootloader holes in bottom plate
    [tenbit-4x12-bot.stl]
2023-05-08 added svgs for bottom plates for ximi
    [xi-5-bottom-no-pointing.dxf, xi-5-bottom-trackball.dxf, xi-6-bottom-cirque.dxf, xi-6-bottom-no-pointing.dxf, xi-6-bottom-trackball.dxf]
2023-05-11 added slimmer version, and some notes on which to use in some use cases
    [xi-trackball-cover-slimmer-bottom-edge.stl]
2023-05-12 added support for waveshare 1.47 inch display, sku 22224, to the ximi thumb trackball cases
    [xi-6-choc-trth-ec-disp-left.stl, xi-6-choc-trth-ne-disp-left.stl, xi-6-mx-trth-ec-disp-left.stl, xi-6-mx-trth-ne-disp-left.stl]
2023-05-16 rectangular rock on cases
    [ro-h3-choc-cir-rectangular.stl, ro-h3-cir-rectangular-bottom.stl, ro-v2-bottom-rectangular.stl, ro-v2-choc-cir-rectangular.stl]
2023-05-20 added a note about the resistors in some of the pictures, not required
2023-05-22 added ks27 choc v1 mx hotswap reversible footprint
2023-05-23 one new footprint for reversible WS2812B leds, and fixed the ks27-choc-mx hotswap reversible footprint
2023-05-24 added vik logo footprints
2023-05-25 added all bottom plates, and added hole for reset switch in bottom plate
    [xi-5-bot-2.8mm-left.stl, xi-5-bot-2.8mm-right.stl, xi-5-bot-2.8mm-trackball-left.stl, xi-5-bot-2.8mm-trackball-right.stl, xi-5-bot-left.stl, xi-5-bot-right.stl, xi-5-bot-trackball-left.stl, xi-5-bot-trackball-right.stl]
2023-05-28 unibody 57mm case for ximi
    [xi-6-mx-unibody-tr57-ec-mk-ring-pattern.3mf, xi-6-mx-unibody-tr57-ec-mk-ring-pattern.stl, xi-6-mx-unibody-tr57-ec-ring-pattern.stl, xi-6-mx-unibody-tr57-ec.stl, xi-trackball-57mm-cover.stl]
2023-05-29 added version with no ring pattern, along with step file
    [xi-6-mx-unibody-tr57-ec-mk.step, xi-6-mx-unibody-tr57-ec-mk.stl]
2023-05-30 added bottom plate for ximi unibody trackball 57mm case
    [xi-6-mx-unibody-tr57-bottom.stl]
2023-06-01 added spacer for extra height for acrylic bottom plates, as well as 5 column unibody 57mm trackball case
    [xi-5-middle-spacer-trackball-left.stl, xi-5-middle-spacer-trackball-right.stl, xi-5-mx-unibody-tr57-bottom.stl, xi-5-mx-unibody-tr57-ec-mk-ring-pattern.stl, xi-5-mx-unibody-trackball-57mm-cover.stl, xi-6-middle-spacer-trackball-left.stl, xi-6-middle-spacer-trackball-right.stl, xi-6-mx-unibody-trackball-57mm-cover.stl]
2023-06-01 updated footprints to have better drawings in comments later to export svgs, enables better sketch for 3d modeling a case
2023-06-05 added some vik footprints and symbols
2023-06-06 added instructions for fpc cable connection for trackball
2023-06-07 added case for ffkb rp2040 v3, with usb hub
    [ff-rp-u3-6-bottom.stl, ff-rp-u3-6-tr-ec.stl, ff-rp-u3-trackball-cover.stl, ff-rp-u3-trackball-housing.stl]
2023-06-11 template for ximi plates, to be completed later
    [ximi-plates-template.kicad_pcb, ximi-plates-template.kicad_sch]
2023-06-13 added usb-c and trrs plate cutout footprints
2023-06-13 more progress on ximi plates, now have pointing device plates template
    [ximi-plates-pointing-device-template.kicad_pcb, ximi-plates-pointing-device-template.kicad_sch, ximi-plates-template.kicad_pcb]
2023-06-13 finished up basic pointing device plates, along with the templates
    [ximi-plates-pointing-device-bottom.kicad_pcb, ximi-plates-pointing-device-bottom.kicad_sch, ximi-plates-pointing-device-bottom.step, ximi-plates-pointing-device-switchplate.kicad_pcb, ximi-plates-pointing-device-switchplate.kicad_sch, ximi-plates-pointing-device-switchplate.step]
2023-06-13 added 3d model for trackball holder for fr-4 plates, and moved kicad files into their own directory
    [ximi-fr4-trackball-cover.stl, ximi-fr4-trackball-holder.stl, ximi-plates-pointing-device-bottom.kicad_pcb, ximi-plates-pointing-device-bottom.kicad_sch, ximi-plates-pointing-device-bottom.step, ximi-plates-pointing-device-switchplate.kicad_pcb, ximi-plates-pointing-device-switchplate.kicad_sch, ximi-plates-pointing-device-switchplate.step]
2023-06-13 made room for the pcb mounting screw in the trackball holder
    [ximi-fr4-trackball-holder.stl]
2023-06-13 added ffkb rp2040 usb hub case for choc
    [ff-rp-u3-choc-6-tr-ec.stl, ff-rp-u3-choc-6-tr-ne.stl, ff-rp-u3-mx-6-tr-ec.stl, ff-rp-u3-mx-6-tr-ne.stl]
2023-06-15 new ffkb rp2040 usb-hub choc case with evq encoder cutouts
    [ff-rp-u3-choc-6-tr-ev.stl]
2023-06-15 ffkb rp2040 usb-hub 5 column cases and more renders
    [ff-rp-u3-5-bottom.stl, ff-rp-u3-choc-5-tr-ec.stl, ff-rp-u3-choc-5-tr-ev.stl, ff-rp-u3-choc-5-tr-ne.stl, ff-rp-u3-mx-5-tr-ec.stl, ff-rp-u3-mx-5-tr-ne.stl]
2023-06-17 fixed reversible 3 switch type footprints
2023-06-22 added trackball cover for ximi that extends to the edge, which looks nicer
    [xi-trackball-cover-alignment-boss-wider-bottom-edge.stl, xi-trackball-cover-alignment-boss.stl]
2023-06-25 added led footprint, and updated edge cuts on usb c plates footprint
2023-06-25 added 5 way tactile switches symbol and footprint
2023-06-26 tiny through hole footprint for breakout pins
2023-06-29 fixed hole size for better fit on D shafts, and added a new one with handles
    [angry-robot.stl, chamfered.stl, notch-handles.stl, rounded-pocket.stl, rounded.stl, simple.stl, wobble-wave.stl]
2023-06-30 SK6812MINI-E adjustments to remove DRC errors for edge cuts and pad overlap, and new multi-switch footprint with curved pads instead of square, also prevents DRC errors
2023-06-30 I had changed the footprint type to SMD, but should have stayed as through hole
2023-07-03 updated footprints to include user comments to help with exporting svgs for 3D modeling
2023-07-03 one more set of footprint updates to help with exporting svgs for 3D modeling
2023-07-07 fixed requirement for M2 screw count
2023-07-11 new ffkb cases for v3 that look a bit nicer with the raised palm area
    [ff-h2-5-bot-outside-mount-only.stl, ff-h2-5-tr-ec-raised-palm-modular.stl, ff-h2-5-tr-ne-raised-palm-modular.stl, ff-h2-6-bot-outside-mount-only.stl, ff-h2-6-tr-ec-raised-palm-modular.stl, ff-h2-6-tr-ne-raised-palm-modular.stl]
2023-07-11 added choc trackball cases for the ximi
    [xi-5-choc-tr-ec-3wt-left.stl, xi-5-choc-tr-ec-3wt-right.stl, xi-5-choc-tr-ne-3wt-left.stl, xi-5-choc-tr-ne-3wt-right.stl, xi-6-choc-tr-ec-3wt-left.stl, xi-6-choc-tr-ec-3wt-right.stl, xi-6-choc-tr-ne-3wt-left.stl, xi-6-choc-tr-ne-3wt-right.stl]
2023-07-12 removed lip on the top back side of the keyboard, as it blocks the controller USB
    [ff-h2-5-tr-ec-raised-palm-modular.stl, ff-h2-5-tr-ne-raised-palm-modular.stl, ff-h2-6-tr-ec-raised-palm-modular.stl, ff-h2-6-tr-ne-raised-palm-modular.stl]
2023-07-12 heat set insert depths were incorrect
    [xi-5-choc-tr-ec-3wt-left.stl, xi-5-choc-tr-ec-3wt-right.stl, xi-5-choc-tr-ne-3wt-left.stl, xi-5-choc-tr-ne-3wt-right.stl, xi-6-choc-tr-ec-3wt-left.stl, xi-6-choc-tr-ec-3wt-right.stl, xi-6-choc-tr-ne-3wt-left.stl, xi-6-choc-tr-ne-3wt-right.stl]
2023-07-13 ximi 5 col cirque cases
    [xi-5-bot-2.8mm-cirque-left.stl, xi-5-bot-2.8mm-cirque-right.stl, xi-5-bot-cirque-left.stl, xi-5-bot-cirque-right.stl, xi-5-choc-c-ec-left.stl, xi-5-choc-c-ec-right.stl, xi-5-choc-c-ne-left.stl, xi-5-choc-c-ne-right.stl]
2023-07-13 there was a slight notch in the 5 column cirque cases, fixed
    [xi-5-choc-c-ec-left.stl, xi-5-choc-c-ec-right.stl, xi-5-choc-c-ne-left.stl, xi-5-choc-c-ne-right.stl, xi-5-mx-c-ec-left.stl, xi-5-mx-c-ec-right.stl, xi-5-mx-c-ne-left.stl, xi-5-mx-c-ne-right.stl]
2023-07-13 new pinkies out v3 cirque holder model
    [pinkies-out-v2-cirque-attachement.stl, pinkies-out-v3-cirque-attachement.stl]
2023-07-16 first pass a vulpes majora cases
    [vmaj-5-uni-bot.stl, vmaj-5-uni-tr-5w-3wt.stl, vmaj-6-uni-bot.stl, vmaj-6-uni-tr-5w-3wt.stl]
2023-07-16 5 way switch mushroom cap
    [5-way-mushroom.stl]
2023-07-16 added cutout for scroll ring height, and expanded 5 way nav switch hole from 8.5mm to 11mm to allow for more play in the switch handle movement
    [vmaj-5-uni-tr-5w-3wt.stl, vmaj-6-uni-tr-5w-3wt.stl]
2023-07-19 vulpes majora - fixed spacing for PER56 scroll ring, expanded 5 way switch hole size, and made indents for 3 way thumb toggle
    [vmaj-5-uni-tr-5w-3wt.stl, vmaj-6-uni-tr-5w-3wt.stl]
2023-07-19 added a lot more 5 way tactile momentary switch handles
    [5-way-8bit-tree.stl, 5-way-concave-directional.stl, 5-way-concave.stl, 5-way-flat-chamfer.stl, 5-way-flat.stl, 5-way-mushroom-directional.stl, 5-way-mushroom.stl, 5-way-rounded.stl]
2023-07-19 updated ximi bottom plates to better fit usb port and 3 way thumb rocker
    [xi-5-bot-2.8mm-left.stl, xi-5-bot-2.8mm-right.stl, xi-5-bot-2.8mm-trackball-left.stl, xi-5-bot-2.8mm-trackball-right.stl, xi-5-bot-left.stl, xi-5-bot-right.stl, xi-5-bot-trackball-left.stl, xi-5-bot-trackball-right.stl]
2023-07-19 added 3 way thumb rocker cutout on bottom plates to match body
    [vmaj-5-uni-bot.stl, vmaj-6-uni-bot.stl]
2023-07-20 same as last commit, but for the cirque cases
    [xi-5-bot-2.8mm-cirque-left.stl, xi-5-bot-2.8mm-cirque-right.stl, xi-5-bot-cirque-left.stl, xi-5-bot-cirque-right.stl, xi-6-bot-2.8mm-cirque-left.stl, xi-6-bot-2.8mm-cirque-right.stl, xi-6-bot-cirque-left.stl, xi-6-bot-cirque-right.stl]
2023-07-21 ximi 5 col choc bodies were missing trrs and usb cutouts
    [xi-5-choc-c-ec-left.stl, xi-5-choc-c-ec-right.stl, xi-5-choc-c-ne-left.stl, xi-5-choc-c-ne-right.stl]
2023-07-22 in previous commit for ximi choc cirque cases, heat set insert holes were removed my mistake, adding back in
    [xi-5-choc-c-ec-left.stl, xi-5-choc-c-ec-right.stl, xi-5-choc-c-ne-left.stl, xi-5-choc-c-ne-right.stl]
2023-07-27 added middle spacers for ximi cirque cases
    [xi-5-middle-spacer-cirque-left.stl, xi-5-middle-spacer-cirque-right.stl, xi-6-middle-spacer-cirque-left.stl, xi-6-middle-spacer-cirque-right.stl]
2023-07-27 more pinkies out v3 center covers, and a printable bottom plate with spacer
    [pinkies-out-v3-center-cover.stl, pinkies-out-v3-cirque-attachement-no-evq.stl, pinkies-out-v3-cirque-attachement.stl, pinkiesout-v3-bottom-plate-with-spacer.stl]
2023-07-28 raised the plate of the pinkies out spacer to 4mm, so should be used with 4mm standoffs
    [pinkiesout-v3-bottom-plate-with-spacer.stl]
2023-07-28 renamed to make spacer height obvious
    [pinkiesout-v3-bottom-plate-with-4mm-spacer.stl]
2023-07-30 ximi cirque middle spacer and ffkb rp2040 evq cutout size
    [ff-rp-u3-choc-6-tr-ev.stl, xi-5-middle-spacer-cirque-left.stl, xi-5-middle-spacer-cirque-right.stl, xi-6-middle-spacer-cirque-left.stl, xi-6-middle-spacer-cirque-right.stl]
2023-08-01 vuples majora 52.5mm trackball for unibody case
    [vmaj-uni-trackball-52.5-cover.stl, vmaj-uni-trackball-52.5-holder-notch-lock.stl, vmaj-uni-trackball-52.5-holder.stl]
2023-08-02 added parametric trackball housing
    [trackball-housing-parametric v11.f3z]
2023-08-05 ximi beta cases for no pointing device and curved cirque
    [xi-6-cc-3wt-left.stl, xi-6-cc-3wt-right.stl, xi-6-np-3wt-left.stl]
2023-08-05 added ffkb soldered switch alignment template
    [ffkb-switch-alignment-template.stl]
2023-08-06 ximi beta case bottom plates
    [xi-6-bottom-plate.stl, xi-6-cc-bot.stl, xi-6-np-bot.stl, xi-6-tr-bot.stl]
2023-08-09 added 2mm thick bottom plate for euclid36
    [euclid36-bottom-plate-2mm.stl]
2023-08-10 added a simple chunky mx 5 col ffkb
    [ff-lp-chunky-5-mx-body.stl]
2023-08-10 ximi choc trackball case - a previous commit removed the EC11 cutout, added back in
    [xi-6-choc-tr-ec-3wt-right.stl]
2023-08-10 ffkb chunky high pro 6 col with no features
    [ff-lp-chunky-6-mx-body.stl]
2023-08-15 added some modular split vulpes majora cases
    [vmaj-split-6-bottom-left.stl, vmaj-split-6-bottom-right.stl, vmaj-split-6-choc-3wt-left.stl, vmaj-split-6-choc-3wt-right.stl, vmaj-split-6-choc-5way-3wt-left.stl, vmaj-split-6-choc-5way-3wt-right.stl, vmaj-uni-trackball-52.5-cover-large.stl]
2023-08-15 old ffkb high pro oled cases that I never committed
    [ff-h2-5-o-ec-w.stl, ff-h2-5-o-ec.stl, ff-h2-5-o-ev-w.stl, ff-h2-5-o-ev.stl, ff-h2-5-o-ne-w.stl, ff-h2-5-o-ne.stl, ff-h2-6-o-ec-w.stl, ff-h2-6-o-ec.stl]
2023-08-15 added a couple of magnet size variations for vulpes majora split
    [vmaj-split-6-choc-3wt-10mm-mag-left.stl, vmaj-split-6-choc-3wt-10mm-mag-right.stl, vmaj-split-6-choc-3wt-8mm-mag-left.stl, vmaj-split-6-choc-3wt-8mm-mag-right.stl, vmaj-split-6-choc-5way-3wt-10mm-mag-left.stl, vmaj-split-6-choc-5way-3wt-10mm-mag-right.stl, vmaj-split-6-choc-5way-3wt-8mm-mag-right.stl, vmaj-split-6-choc-5way-8mm-mag-3wt-left.stl]
2023-08-15 recessed usb c port a bit more for vulpes majora split bottom plate
    [vmaj-split-6-bottom-left.stl]
2023-08-15 fixed overlapping area on vik module stl with vulpes majora split case
    [vmaj-split-vik-per56-pmw3360-with-keys-stl.stl]
2023-08-16 added heat set inserts for vik module pcb mount, and lip for better alignment with case
    [vmaj-split-vik-per56-pmw3360-with-keys-stl.stl]
2023-08-16 forgot fpc cutouts in vik module on the last commit
    [vmaj-split-vik-per56-pmw3360-with-keys-stl.stl, vmaj-split-vik-per56-pmw3360-with-keys.stl]
2023-08-16 vulpes vik split - made the flap more stable, expanded fpc holes to allow you to more easily remove without disconnecting the cable
    [vmaj-split-vik-per56-pmw3360-with-keys.stl]
2023-08-16 5 way thumb switches in different heights, and fix to vulpes majora 5 way switch opening
    [5-way-11.5mm-8bit-tree.stl, 5-way-11.5mm-concave-directional.stl, 5-way-11.5mm-concave.stl, 5-way-11.5mm-flat-chamfer.stl, 5-way-11.5mm-flat.stl, 5-way-11.5mm-mushroom-directional.stl, 5-way-11.5mm-mushroom.stl, 5-way-11.5mm-rounded.stl]
2023-08-16 5.5mm stem 5 way switch handles
    [5-way-5.5mm-8bit-tree.stl, 5-way-5.5mm-concave-directional.stl, 5-way-5.5mm-concave.stl, 5-way-5.5mm-flat-chamfer.stl, 5-way-5.5mm-flat.stl, 5-way-5.5mm-mushroom-directional.stl, 5-way-5.5mm-mushroom.stl, 5-way-5.5mm-rounded.stl]
2023-08-17 per56 didn't fit into vulpes majora vik module case
    [vmaj-split-vik-per56-pmw3360-with-keys.stl]
2023-08-17 expanded vik fpc cutout to make it easier to plug the cable in
    [vmaj-split-vik-per56-pmw3360-with-keys.stl]
2023-09-19 added new vulpes majora case with weact st7735 mount support
    [vmaj-5-uni-st7735-5w-3wt.stl, vmaj-6-uni-st7735-5w-3wt.stl, vmaj-st7735-cover.stl]
2023-09-22 updated paramtetric trackball holder, the sensor cutout extended too far, and caused the bearing holes to be incomplete
    [trackball-housing-parametric v11.f3z, trackball-housing-parametric v12.f3z]
2023-09-24 per56 trackball models, to be used on any keyboard
    [per56-38mm-trackball-cover.stl, per56-38mm-trackball-housing-4mm-bearings.stl]
2023-10-01 first commit to test new CMY keycaps
    [CMY-3x-lateral-sets-rounded.stl, CMY-3x-lateral-sets.stl, CMY-9x-thumbs.stl, CMY-R2-R4.stl, CMY-R3.stl]
2023-10-02 renamed CMY keycap sets, and added choc versions
    [CMY-CHOC-3x-lateral-sets.stl, CMY-CHOC-9x-thumbs.stl, CMY-CHOC-R2-R4.stl, CMY-CHOC-R3.stl, CMY-MX-3x-lateral-sets-rounded.stl, CMY-MX-3x-lateral-sets.stl, CMY-MX-9x-thumbs.stl, CMY-MX-R2-R4.stl]
2023-10-02 added keys with homing bumps
    [CMY-CHOC-3x-lateral-sets-with-homing.stl, CMY-CHOC-R3-homing.stl, CMY-MX-3x-lateral-sets-with-homing.stl, CMY-MX-R3-homing.stl]
2023-10-02 renamed CMY keycap files to be less confusing
    [CMY-MX-3x-lateral-sets-SQUARE.stl, CMY-MX-3x-lateral-sets-rounded.stl, CMY-MX-3x-lateral-sets.stl]
2023-10-03 added new case and svg for ffkb lite min-y
    [ffkb-LMY-5-choc.stl, ffkb-LMY-6-choc.stl, ffkb-lite-6-body.stl, ffkb-lite-6-bot.step, ffkb-lite-6-bot.stl, ffkb-lite-6-fox-logo-body.step, ffkb-lite-6-fox-logo-body.stl, ffkb-lite-6-no-led-body.stl]
2023-10-04 added ffkb lite minimal y bottom plates and a chamfered thumbs case in case the keycaps aren't tall enough and the edges get in the way
    [ffkb-LMY-5-bot.stl, ffkb-LMY-5-choc-chamfered-thumbs.stl, ffkb-LMY-6-bot.stl, ffkb-LMY-6-choc-chamfered-thumbs.stl]
2023-10-06 added 34mm trackball housing and cover for per56 scroll ring
    [per56-34mm-trackball-cover.stl, per56-34mm-trackball-housing-4mm-bearings.stl]
2023-10-08 updated cirque holder models for pinkies out v3 to have tighter center circle
    [pinkies-out-v3-cirque-attachement-no-evq.stl, pinkies-out-v3-cirque-attachement.stl]
2023-10-11 added pinkies out v3 modular 3d model for FR-4 plates for 25mm trackball
    [pinkies-out-v3-trackball-25mm-attachment.stl, pinkies-out-v3-trackball-25mm-cover.stl]
2023-10-12 added 6.1mm EC11 knobs and added suffix to originals, indicating 6.5mm
    [angry-robot-6.1mm.stl, angry-robot-6.5mm.stl, chamfered-6.1mm.stl, chamfered-6.5mm.stl, notch-handles-6.1mm.stl, notch-handles-6.5mm.stl, rounded-6.1mm.stl, rounded-6.5mm.stl]
2023-10-12 new EC11 knob called bulb
    [bulb-6.1mm.stl]
2023-10-12 new EC11 knob called mushroom, suggestion by pyntiehet
    [mushroom-6.1mm.stl]
2023-10-14 reorganized tented cases, and added one without a trackball and a waveshare display
    [xi-6-choc-tented-np-ec-disp-left.stl, xi-6-choc-tented-trth-ec-disp-left.stl, xi-6-choc-tented-trth-ec-left.stl, xi-6-choc-tented-trth-ne-disp-left.stl, xi-6-choc-tented-trth-ne-left.stl, xi-6-mx-tented-trth-ec-disp-left.stl, xi-6-mx-tented-trth-ec-left.stl, xi-6-mx-tented-trth-ne-disp-left.stl]
2023-10-21 fixed MX stems for CMY keycaps
    [CMY-MX-3x-lateral-sets-with-homing.stl, CMY-MX-3x-lateral-sets.stl, CMY-MX-9x-thumbs.stl, CMY-MX-R2-R4.stl, CMY-MX-R3-homing.stl, CMY-MX-R3.stl]
2023-10-21 moved CMY into a 5 degree directory, in prep for the 12 degree version
    [CMY-CHOC-3x-lateral-sets-with-homing.stl, CMY-CHOC-3x-lateral-sets.stl, CMY-CHOC-9x-thumbs.stl, CMY-CHOC-R2-R4.stl, CMY-CHOC-R3-homing.stl, CMY-CHOC-R3.stl, CMY-MX-3x-lateral-sets-SQUARE.stl, CMY-MX-3x-lateral-sets-with-homing.stl]
2023-10-21 added 12 degree version of the CMY keycaps, untested
    [CMY-CHOC-3x-lateral-sets-with-homing.stl, CMY-CHOC-3x-lateral-sets.stl, CMY-CHOC-9x-thumbs.stl, CMY-CHOC-R2-R4.stl, CMY-CHOC-R3-homing.stl, CMY-CHOC-R3.stl, CMY-MX-3x-lateral-sets-with-homing.stl, CMY-MX-3x-lateral-sets.stl]
2023-10-21 syncing other cases, mostly ffkb min y cases
    [ffkb-LMY-5-choc-chamfered-thumbs.stl, ffkb-LMY-5-choc-gc9a01.stl, ffkb-LMY-5-choc.stl, ffkb-LMY-5-gc9a01-cover.stl, ffkb-LMY-6-choc-chamfered-thumbs.stl, ffkb-LMY-6-choc-gc9a01.stl, ffkb-LMY-6-choc.stl, pinkies-out-v3-trackball-25mm-attachment.stl]
2023-10-21 added a flat ends version of the 12 degree keycaps
    [CMY-CHOC-3x-lateral-sets-with-homing.stl, CMY-CHOC-3x-lateral-sets.stl, CMY-CHOC-R2-R4.stl, CMY-CHOC-R3-homing.stl, CMY-CHOC-R3.stl, CMY-MX-3x-lateral-sets-with-homing.stl, CMY-MX-3x-lateral-sets.stl, CMY-MX-R2-R4.stl]
2023-10-23 added ffkb lite min y mx cases
    [ffkb-LMY-5-gc9a01-cover.stl, ffkb-LMY-5-mx-25mm-tr.stl, ffkb-LMY-5-mx.stl, ffkb-LMY-6-mx-25mm-tr.stl, ffkb-LMY-6-mx.stl, ffkb-LMY-gc9a01-cover.stl]
2023-10-25 fixed magnet locations for vulpes majora 52.5 trackball cover
    [vmaj-uni-trackball-52.5-cover-large.stl]
2023-10-26 added CMY sculpted thumbs
    [CMY-CHOC-2x-thumb-tilt-sets-of-3.stl, CMY-CHOC-thumb-C.stl, CMY-CHOC-thumb-tilt-L.stl, CMY-CHOC-thumb-tilt-R.stl, CMY-MX-2x-thumb-tilt-sets-of-3.stl, CMY-MX-thumb-C.stl, CMY-MX-thumb-tilt-L.stl, CMY-MX-thumb-tilt-R.stl]
2023-10-26 accidentally commited some extra unneeded files
    [CMYMX3xlateralsetswithhoming.stl, CMYMX9xthumbs.stl]
2023-10-27 added sculpted edge column keycaps for CMY 12 degree
    [CMY-CHOC-2x-edge-col-sets.stl, CMY-CHOC-edge-col-R2R4-duplicate.stl, CMY-CHOC-edge-col-R2R4.stl, CMY-CHOC-edge-col-R3.stl, CMY-MX-2x-edge-col-sets.stl, CMY-MX-edge-col-R2R4-duplicate.stl, CMY-MX-edge-col-R2R4.stl, CMY-MX-edge-col-R3.stl]
2023-10-27 added support for MX steps for 12 degree keycaps
    [CMY-MX-2x-thumb-tilt-sets-of-3.3mf, CMY-MX-2x-thumb-tilt-sets-of-3.stl, CMY-MX-3x-lateral-sets-with-homing.stl, CMY-MX-3x-lateral-sets.stl, CMY-MX-R2-R4.stl, CMY-MX-R3-homing.stl, CMY-MX-R3.stl, CMY-MX-thumb-C.stl]
2023-10-27 added 2U 2 position keycaps by request
    [CMY-CHOC-2U-2POS.stl, CMY-MX-2U-2POS.stl]
2023-11-01 vulpes majora choc unibody trackball cases
    [vmaj-5-choc-uni-tr-5w-3wt.stl.stl, vmaj-6-choc-uni-tr-5w-3wt.stl]
2023-11-02 added heat set insert mounts for vulpes stock vik module
    [vmaj-5-choc-uni-tr-5w-3wt.stl.stl, vmaj-6-choc-uni-tr-5w-3wt.stl]
2023-11-03 added 35mm trackball cover for ximi, requested by autoferrit
    [xi-trackball-35mm-cover.stl]
2023-11-06 fixed 5 way nav cutout, and usb pcb cutout in vulpes majora choc trackball cases
    [vmaj-5-choc-uni-tr-5w-3wt.stl.stl, vmaj-6-choc-uni-tr-5w-3wt.stl]
2023-11-09 added azoteq tps65 case for vulpes majora
    [vmaj-5-mx-uni-tps65-5w-3wt.stl, vmaj-6-mx-uni-tps65-5w-3wt.stl]
2023-11-09 added a couple of kicad footprints for 2mm pitch pads, both regular and castellated
2023-11-10 moved ffkb v4 cases into their own folder
    [ff-rp-u3-5-bottom.stl, ff-rp-u3-6-bottom.stl, ff-rp-u3-choc-5-tr-ec.stl, ff-rp-u3-choc-5-tr-ev.stl, ff-rp-u3-choc-5-tr-ne.stl, ff-rp-u3-choc-6-tr-ec.stl, ff-rp-u3-choc-6-tr-ev.stl, ff-rp-u3-choc-6-tr-ne.stl]
2023-12-05 ws2812b 2020 for pcba
2023-12-05 step file for USB-C for kicad
    [HRO_TYPE-C-31-M-12.step]
2023-12-08 added new led footprints for top mount SMD
2023-12-08 new gaming keyboard, kucheza, prototype case
    [kucheza-mx-body-prototype.stl]
2023-12-11 added some joystick symbols and footprints
2023-12-11 first actual test case for the kucheza pcb
    [kucheza-mx-body-3wt-5way-trrs.stl]
2023-12-11 removing vik footprints since they are now in the vik repo
2023-12-12 kucheza bottom plate
    [kucheza-bottom-plate.stl]
2023-12-12 ffkb lite curved cirque 6 column case
    [ffkb-LMY-6-choc-35mm-curved-cirque.stl]
2023-12-24 renamed ffkb lite cases based on choc or mx, added ffkb light mx case with vik xs mount support and ec11 cover
    [ffkb-lite-choc-6-body.stl, ffkb-lite-choc-6-fox-logo-body.stl, ffkb-lite-choc-6-no-led-body.stl, ffkb-lite-mx-6-vik-xs-mount-body.stl, ffkb-lite-vik-ec11-cover.stl]
2023-12-24 added more vik ec11 module covers for ffkb lite
    [ffkb-lite-vik-ec11-14mm-cover.stl, ffkb-lite-vik-ec11-16mm-cover.stl, ffkb-lite-vik-ec11-18mm-cover.stl, ffkb-lite-vik-ec11-20mm-cover.stl, ffkb-lite-vik-ec11-22mm-cover.stl, ffkb-lite-vik-ec11-25mm-cover.stl, ffkb-lite-vik-ec11-26mm-cover.stl]
2023-12-25 based on feedback from Holiday, increased center pin for red dragon switch footprint from 4.2mm to 4.6mm
2023-12-25 added dxf for various bottom plate dxf so you can cut a frosted acrylic bottom plate to show off an underglow setup
    [ffkb-LMY-6-bot.dxf, ffkb-lite-6-bot.dxf, kucheza-bottom-plate.dxf]
2023-12-31 ximi with a hole for the trackpoint, and made the height 2mm taller to give room under the PCB for the trackpoint module
    [xi-6-mx-tp-ne-10mm-under-left.stl]
2023-12-31 ximi 6 col trackpoint bottom plate
    [xi-6-tp-10mm-under-bottom-left.stl]
2023-12-31 accidentally removed heat set inserts in ximi 6 trackpoint mx case
    [xi-6-mx-tp-ne-10mm-under-left.stl]
2024-01-07 print in place tenting stand
    [device-tenting-stand.stl]
2024-01-08 added various tenting angles by adjusting the percentage of the legnth that folds
    [device-tenting-stand-10percent.stl, device-tenting-stand-20percent.stl, device-tenting-stand-30percent.stl, device-tenting-stand-40percent.stl, device-tenting-stand-50percent.stl, device-tenting-stand-60percent.stl, device-tenting-stand-70percent.stl, device-tenting-stand-80percent.stl]
2024-01-08 added vertical stand as well, stops at much higher angle, the making the stand more upright
    [device-tenting-vertical-stand.stl]
2024-01-10 added filet on the end to make it nicer, made contact points smaller, increased gaps between hinges to print better at smaller sizes
    [device-tenting-stand-10percent.stl, device-tenting-stand-20percent.stl, device-tenting-stand-30percent.stl, device-tenting-stand-40percent.stl, device-tenting-stand-50percent.stl, device-tenting-stand-60percent.stl, device-tenting-stand-70percent.stl, device-tenting-stand-80percent.stl]
2024-01-21 added ssbb's trackpoint sensor, with attribution
2024-01-21 also added ssbb's trackpoint pcb footprint
2024-01-29 new ffkb lite mx cases
    [ffkb-lite-mx-6-body.stl, ffkb-lite-mx-6-cirque-35mm-body.stl]
2024-01-29 new ffkb v4 rp2040 cases
    [ff-rp-u3-6-tp-2.4mm-spacer-bottom.stl, ff-rp-u3-6-tp-bottom.stl, ff-rp-u3-choc-6-tp-cover-acrylic-cutout.stl, ff-rp-u3-choc-6-tp-cover-blank.stl, ff-rp-u3-choc-6-tp-ne-modular.stl]
2024-01-31 ffkb v4 choc cirque cases with all encoder options
    [ff-rp-u3-choc-5-c-ec.stl, ff-rp-u3-choc-5-c-ev.stl, ff-rp-u3-choc-5-c-ne.stl, ff-rp-u3-choc-6-c-ec.stl, ff-rp-u3-choc-6-c-ev.stl, ff-rp-u3-choc-6-c-ne.stl]
2024-01-31 ffkb lite wireless bodies and bottom plate, and fingerpunch emblem plug for 35mm cirque hole
    [ffkb-lite-6-wireless-bot.stl, ffkb-lite-mx-6-wireless-body.stl, ffkb-lite-mx-6-wireless-cirque-35mm-body.stl, fingerpunch-emblem-45mm-diameter-35mm-plug.stl]
2024-02-01 tenbit choc 5x12 case
    [tenbit-5x12-bot.stl, tenbit-5x12-choc.stl]
2024-02-02 adjusted emblem fitting to closer to 35mm to make a tighter fit
    [fingerpunch-emblem-45mm-diameter-35mm-plug.stl]
2024-02-02 changed MX stem width from 1.35mm to 1.20mm, since the MX keycaps were fitting a bit loose in most, if not all, materials
    [CMY-MX-2x-edge-col-sets.stl, CMY-MX-2x-thumb-tilt-sets-of-3.stl, CMY-MX-3x-lateral-sets-with-homing.stl, CMY-MX-3x-lateral-sets.stl, CMY-MX-9x-thumbs.stl, CMY-MX-R2-R4.stl, CMY-MX-R3-homing.stl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]
2024-02-11 added a low pro choc pimoroni evq case for ffkb v1 atmega
    [ffkb-atmega-choc-6col-evq-pim447-body.stl, ffkb-atmega-choc-6col-evq-pim447-bottom-plate.stl]
2024-02-20 choc no pointing cases for ximi
    [xi-5-choc-np-ec-left.stl, xi-5-choc-np-ec-right.stl, xi-5-choc-np-ne-left.stl, xi-5-choc-np-ne-right.stl, xi-6-choc-np-ec-left.stl, xi-6-choc-np-ec-right.stl, xi-6-choc-np-ne-left.stl, xi-6-choc-np-ne-right.stl]
2024-02-26 new ffkb v3 trackball evq raised palm case
    [ff-h2-5-tr-ev-raised-palm-modular.stl]
2024-02-26 experimental labret covers for trackpoint stem
    [trackpoint-cover-labret-5Dx3Hx3mmCutout.stl, trackpoint-cover-labret-8Dx3Hx3mmCutout.stl]
2024-02-28 kucheza choc or low pro gateron case
    [kucheza-choc-body-3wt-5way-trrs.stl]
2024-02-29 kucheza 5 way switch needed additional cutout in choc version to make room for switch housing
    [kucheza-choc-body-3wt-5way-trrs.stl]
2024-03-04 fixed reset hole position on kucheza
    [kucheza-bottom-plate.dxf, kucheza-bottom-plate.stl]
2024-03-06 R1 keycaps for CMY 5 degree
    [CMY-CHOC-9x-R1.stl, CMY-CHOC-R1.stl, CMY-MX-2x-thumb-tilt-sets-of-3.3mf, CMY-MX-9x-R1.stl, CMY-MX-R1.stl]
2024-03-06 ffkb v2 low pro choc case with no encoders and wireless and room for battery
    [ff-ul-5-c-ne-ch-w-tall-battery.stl]
2024-03-07 ffkb atmega choc 5 col evq pimoroni case
    [ffkb-atmega-choc-5col-evq-pim447-body.stl, ffkb-atmega-choc-5col-evq-pim447-bottom-plate.stl]
2024-03-11 kucheza - added diffused led window version for choc
    [kucheza-choc-body-3wt-5way-trrs-diffused-leds.stl, kucheza-diffused-led-window.stl]
2024-03-13 added 3.5mm 5 way switch knobs
    [5-way-3.5mm-8bit-tree.stl, 5-way-3.5mm-concave-directional.stl, 5-way-3.5mm-concave.stl, 5-way-3.5mm-flat-chamfer.stl, 5-way-3.5mm-flat.stl, 5-way-3.5mm-mushroom-directional.stl, 5-way-3.5mm-mushroom.stl, 5-way-3.5mm-rounded.stl]
2024-03-26 new bottom plate for ffkb lite min-y, with lip and bump on cutouts
    [ffkb-LMY-6-bot-raisedlip-bumpon7.5mm-cutouts.stl]
2024-04-08 moved modular plates around, and added svgs for the 5 col ffkb
    [5col-ffkb-bottom-plate.kicad_pcb, 5col-ffkb-switchplate.kicad_pcb, ffkb-bottom-plate.kicad_pcb, ffkb-fr4-modular-cirque-cover.stl, ffkb-fr4-modular-trackball-cover.stl, ffkb-switchplate-template-brd.dxf, ffkb-switchplate-template.kicad_pcb, ffkb-switchplate-template.kicad_sch]
2024-04-17 step files for 5 way switch knobs
    [5-way-8bit-tree.step, 5-way-concave-directional.step, 5-way-concave.step, 5-way-flat-chamfer.step, 5-way-flat.step, 5-way-mushroom-directional.step, 5-way-mushroom.step, 5-way-rounded.step]
2024-04-18 trackball thumb helmet case with readme
    [trackball-thumb-helmet-backplate-vik-2mm-offset.stl, trackball-thumb-helmet-backplate-vik-xs-2mm-offset.stl, trackball-thumb-helmet-backplate-vik.stl, trackball-thumb-helmet-housing-vik-xs.stl, trackball-thumb-helmet-housing-vik.stl, trackball-thumb-helmet-vik-controller-optional-battery-backpack.stl]
2024-04-18 broken image link to M2 mounting screws
2024-04-19 including all step and fusion 360 files for trackball thumb helmet
    [trackball-thumb-helmet-backplate-vik-2mm-offset.step, trackball-thumb-helmet-backplate-vik-xs-2mm-offset.step, trackball-thumb-helmet-backplate-vik-xs.step, trackball-thumb-helmet-backplate-vik.step, trackball-thumb-helmet-housing-vik-xs.step, trackball-thumb-helmet-housing-vik.step, trackball-thumb-helmet-vik-controller-optional-battery-backpack.step, trackball-thumb-helmet-vik-medium.f3z]
2024-04-19 added bearings to the readme
2024-04-22 no stand off version of rock on v3 mx modular case
    [ro-h3-mx-no-standoffs-modular.stl, ro-h3-no-standoffs-modular-bottom-plate.stl]
2024-04-22 ffkb oled cover support
    [ff-h2-oled-cover.stl]
2024-04-23 ximi v2 per56 trackball case for 6 column mx
    [xi-6-bot-vik-per56-left.stl, xi-6-bot-vik-per56-right-bot.stl, xi-6-mx-ec-vik-per56-3wt-left.stl, xi-6-mx-ec-vik-per56-3wt-right.stl, xi-6-mx-ne-vik-per56-3wt-left.stl, xi-6-mx-ne-vik-per56-3wt-right.stl, xi-vik-per56-34mm-trackball-cover.stl]
2024-04-23 added note about using i2c vs spi for ximi v1 vs v1.1 and later
2024-04-23 had wrong version, mx was actually choc, swapped name and added real MX version
    [ro-h3-choc-no-standoffs-modular.stl, ro-h3-mx-no-standoffs-modular.stl]
2024-04-26 fixed large screw hole in ffkb lite bottom plates, added new tall battery bottom plate
    [ffkb-lite-6-bot.stl, ffkb-lite-6-wireless-4.2mm-battery-bot.stl, ffkb-lite-6-wireless-bot.stl]
2024-04-26 explanation about ffkb lite bottom plate selection
2024-04-29 ffkb holyiot mx cases
    [ffkb-holyiot-6-mx-body.stl, ffkb-holyiot-6-mx-bottom.stl, ffkb-holyiot-6-mx-ec-LR-body.stl, ffkb-holyiot-6-mx-ec-LRClarge-body.stl]
2024-05-06 vikropad case files
    [vikropad-choc-glp-body.stl, vikropad-choc-glp-bottom-xivik.stl]
2024-05-08 ffkb lite choc wireless case bodies
    [ffkb-lite-choc-6-wireless-body.stl, ffkb-lite-choc-6-wireless-cirque-35mm-body.stl]
2024-05-08 ffkb lite 5 col wired and wireless cases
    [ffkb-lite-5-bot.stl, ffkb-lite-choc-5-wireless-body.stl, ffkb-lite-choc-5-wireless-bot.stl, ffkb-lite-choc-5-wireless-cirque-35mm-body.stl, ffkb-lite-choc-6-wireless-bot.stl, ffkb-lite-mx-5-body.stl, ffkb-lite-mx-5-wireless-body.stl, ffkb-lite-mx-5-wireless-bot.stl]
2024-05-10 ximi v2 per56 case cutout for per56 was a bit too large
    [xi-6-mx-ec-vik-per56-3wt-left.stl, xi-6-mx-ec-vik-per56-3wt-right.stl, xi-6-mx-ne-vik-per56-3wt-left.stl, xi-6-mx-ne-vik-per56-3wt-right.stl]
2024-05-10 ximi per56 trackball cover with wide top, and trackball holder
    [xi-vik-per56-34mm-trackball-cover-wide-top.stl, xi-vik-per56-34mm-trackball-holder.stl]
2024-05-13 lowered bearing positions plane down by 0.5mm and added filets on bearing cutouts
    [trackball-thumb-helmet-housing-vik.stl]
2024-05-13 added switch cutouts for thumb trackball backpack
    [trackball-thumb-helmet-vik-controller-optional-battery-backpack-w-switch-cutouts.stl]
2024-05-14 lowered bearing mounts by 0.2mm instead of previous lowering by 0.5mm and added filet
    [trackball-thumb-helmet-housing-vik-xs.stl, trackball-thumb-helmet-housing-vik.stl]
2024-05-14 trackball thumb helmet vik housing with cutout for battery backpack with switches, more room for switches
    [trackball-thumb-helmet-housing-for-switch-cutouts-vik.stl]
2024-05-15 added wing bearings to thumb trackball vik xs for better stability
    [trackball-thumb-helmet-housing-vik-xs.stl]
2024-05-18 ximi waveshare 22224 6 column mx case with cover
    [waveshare-22224-cover.stl, xi-6-mx-ec-vik-waveshare-22224-3wt-left.stl, xi-6-mx-ne-vik-waveshare-22224-3wt-left.stl]
2024-05-20 ffkb case for v2 high pro and bottom plate with battery space
    [ff-h2-6-bot-outside-only.stl, ff-h2-6-np-ne-w-tall-for-battery.stl]
2024-05-20 pinkies out v2 cover using v3 plates
    [pinkies-out-v2-pcb-v3-plates-center-cover.stl]
2024-06-04 uxcell a14092600ux0438 solenoid model and holder
    [uxcell-a14092600ux0438-holder.f3d, uxcell-a14092600ux0438-holder.stl, uxcell-a14092600ux0438-object-in-holder.f3z, uxcell-a14092600ux0438-object.f3d]
2024-06-04 ffkb lite min y 6 column uxcell a14092600ux0438 solenoid support
    [ffkb-LMY-6-mx-solenoid-25mm-tr.stl]
2024-06-13 added ffkb lite mx 5 column with solenoid housing
    [ffkb-lite-mx-5-solenoid-body.stl]
2024-06-14 ili9341 display module housing and cover
    [ili9341-4inch-cover.step, ili9341-4inch-housing.step]
2024-06-14 ffkb lite standard 5 col case bottom plate with more spacing underneath the pcb, used for solenoid build to make space for the transistor
    [ffkb-lite-5-bot-3.5mm-under-pcb.stl]
2024-06-20 initial case support for ximega
    [ximega-base.stl, ximega-choc-glp-cover-no-vik.stl, ximega-choc-glp-switchplate.stl, ximega-mx-cover-no-vik.stl, ximega-mx-switchplate.stl]
2024-06-20 ximega case readme
2024-06-21 a lot more ximega cases, wawa weewa
    [ximega-choc-glp-cover-cirque-35mm-left.stl, ximega-choc-glp-cover-cirque-35mm-right.stl, ximega-choc-glp-cover-no-vik-lower-profile.stl, ximega-choc-glp-cover-no-vik.stl, ximega-choc-glp-cover-vik-azoteq-tps65-left.stl, ximega-choc-glp-cover-vik-azoteq-tps65-right.stl, ximega-choc-glp-cover-vik-pmw3360-25mm-left.stl, ximega-choc-glp-cover-vik-pmw3360-25mm-right.stl]
2024-06-21 updates to ximega case readme file
2024-06-21 ximega weact st7735 cover
    [ximega-mx-cover-vik-weact-st7735-left.stl, ximega-mx-cover-vik-weact-st7735-right.stl, ximega-vik-weact-st7735-cover.stl]
2024-06-24 ximega - added 0.2mm gap between switch plate and top cover by shrinking the switch plate by 0.2mm around the perimeter
    [ximega-choc-glp-switchplate.stl, ximega-mx-switchplate.stl]
2024-06-24 new version of parametric trackball housing that lowers the base height
    [trackball-housing-reduced-base-height-parametric_v4.f3z]
2024-06-25 small adjustments to weact st7735 body and cover
    [ximega-mx-cover-vik-weact-st7735-left.stl, ximega-mx-cover-vik-weact-st7735-right.stl, ximega-vik-weact-st7735-cover.stl]
2024-06-27 pinkies out v3 bottom plate to surround choc plates
    [pinkiesout-v3-bottom-plate-with-4mm-spacer-choc-border.stl]
2024-06-27 ximega mx gc9a01 diplay top cover
    [ximega-mx-cover-vik-gc9a01-display.stl, ximega-vik-gc9a01-display-holder.stl]
2024-07-01 ffkb v4 mx 5 column cirque body
    [ff-rp-u3-mx-5-cirque.stl]
2024-07-06 custom low pro ffkb v4 choc cirque 6 column case
    [ff-rp-u3-choc-6-c-ev-lowpro-2.stl, ff-rp-u3-choc-6-c-ev-lowpro.stl]
2024-07-07 added pinkies out v3 cases
    [po-v3-choc-body.stl, po-v3-choc-bottom-plate.stl, po-v3-choc-evq-body.stl, po-v3-mx-body.stl, po-v3-mx-bottom-plate.stl, po-v3-mx-evq-body.stl]
2024-07-07 better support for mounting points on pinkies out v3 cases for center module
    [po-v3-choc-body.stl, po-v3-choc-evq-body.stl, po-v3-mx-body.stl, po-v3-mx-evq-body.stl]
2024-07-07 first few vik module covers for the pinkies out v3
    [po-v3-choc-vik-blank.stl, po-v3-choc-vik-cirque.stl, po-v3-mx-vik-blank.stl]
2024-07-08 pinkies out v3 mx vik cirque
    [po-v3-mx-vik-cirque.stl]
2024-07-09 pinkies out v3 choc vik 25mm trackball and cover
    [po-v3-choc-vik-trackball-25mm-cover.stl, po-v3-choc-vik-trackball-25mm.stl]
2024-07-09 pinkies out v3 choc vik 24mm trackball and cover
    [po-v3-choc-vik-trackball-24mm-cover.stl, po-v3-choc-vik-trackball-24mm.stl]
2024-07-09 added space in pinkies out v3 vik xs trackball for the fpc cable to run
    [po-v3-choc-vik-trackball-24mm.stl]
2024-07-15 pinkies out v3 mx trackball options
    [po-v3-mx-body-non-modular-25mm-vik-xs.stl, po-v3-mx-vik-trackball-25mm-cover.stl, po-v3-mx-vik-trackball-25mm.stl]
2024-07-24 pinkies out v3 case - added cutout for boot switch or through holes
    [po-v3-choc-bottom-plate.stl]
2024-07-24 combined bottom plates, since they are identical
    [po-v3-bottom-plate.stl, po-v3-mx-bottom-plate.stl]
2024-07-24 sync ximega base with local
    [ximega-base.stl]
2024-08-06 pinkies out v3 case for vik xs with 24mm trackball
    [po-v3-mx-body-non-modular-24mm-vik-xs.stl]
2024-08-10 pinkies out v3 - adding an integrated blank vik cases with evq support
    [po-v3-choc-bottom-plate.stl, po-v3-mx-body-non-modular-vik-blank-evq.stl, po-v3-mx-bottom-plate.stl, po-v3-mx-vik-trackball-25mm-cover.stl, po-v3-vik-trackball-24mm-cover.stl, po-v3-vik-trackball-25mm-cover.stl]
2024-08-12 ffkb lite min-y 6 column case with 25mm trackball support
    [ffkb-LMY-6-mx-wireless-25mm-trackball.stl]
2024-08-13 ximi fr4 trackball holder with integrated cover
    [ximi-fr4-trackball-holder-integrated-cover.stl]
2024-08-18 small modifications to ximi build guide to give clarity on trackball sensor orientation, and removed hand wiring instructions
2024-08-24 rock on v2 mx case with evq cutouts
    [ro-v2-mx-cir-evq.stl]
2024-08-24 4x bearing version of trackball housing for ffkb v3
    [trackball-housing-with-BTU-4x-bearings.stl]
2024-08-25 rock on v2 evq orientation was incorrect
    [ro-v2-mx-cir-evq.stl]
2024-08-27 rock on v2 high pro mx with evq - expanded evq cutouts a bit for better fit
    [ro-v2-mx-cir-evq.stl]
2024-08-30 pinkies out v3 non-modular evq case, evq cutouts were off by a bit
    [po-v3-mx-body-non-modular-vik-blank-evq.stl]
2024-08-31 kucheza byomcu special edition case
    [kucheza-byomcu-bottom-plate.stl, kucheza-byomcu-choc-body-3wt-5way-trrs.stl]
2024-09-01 replaced kucheza byomcu case with a version that has a little more space for the controller and JST connector
    [kucheza-byomcu-choc-body-3wt-5way-trrs-wireless.stl, kucheza-byomcu-choc-body-3wt-5way-trrs.stl]
2024-09-01 kucheza byomcu case bottom plate cutout for on off switch wasn't long enough
    [kucheza-byomcu-bottom-plate.stl]
2024-09-30 rock on v2 or v3 rectangular low pro
    [ro-v2-v3-bottom-rectangular.stl, ro-v2-v3-choc-cirque-rectangular.step, ro-v2-v3-choc-cirque-rectangular.stl]
2024-09-30 ffkb v1 atmega low pro with 3 encoder cutouts
    [ffkb-atmega-choc-6col-ec11-left-right-center-body.stl, ffkb-atmega-choc-6col-ec11-left-right-center-bottom-plate.stl]
2024-10-18 added no encover versions of unibody ximi 6 column mx case, by request, along with step files
    [xi-6-mx-unibody-tr57-ne-mk-ring-pattern.step, xi-6-mx-unibody-tr57-ne-mk-ring-pattern.stl, xi-6-mx-unibody-tr57-ne-mk.step, xi-6-mx-unibody-tr57-ne-mk.stl]
2024-10-19 additional step files for ximi unibody 57mm trackball case
    [xi-6-mx-unibody-tr57-bottom.step, xi-6-mx-unibody-trackball-57mm-cover.step]
2024-11-08 ffkb low pro no center feature right evq only
    [ff-ul-6-n-ev-rightonly-tall-battery.stl]
2024-11-18 some of the chamfers missing on the pinkies out v3 plate center feature models
    [pinkies-out-v3-cirque-attachement-no-evq.stl, pinkies-out-v3-trackball-25mm-attachment.stl]
2025-01-04 choc regtangular body with encoder cutouts
    [ro-v2-choc-cir-ec_center-rectangular.stl, ro-v2-choc-cir-ec_under_palm-rectangular.stl]
2025-02-07 rock on v3 mx modular case with 6 degree tent
    [ro-h3-mx-6-deg-tent-no-standoffs-bottom-plate.stl, ro-h3-mx-6-deg-tent-no-standoffs-modular.stl]
2025-02-11 ffkb v2 and v3 - some cleaner no pointing device cases, wired and wireless
    [ff-h2-5-np-ec-raised-palm-non-modular.stl, ff-h2-5-np-ec-w-raised-palm-non-modular.stl, ff-h2-5-np-ne-raised-palm-non-modular.stl, ff-h2-5-np-ne-w-raised-palm-non-modular.stl]
2025-03-11 rock on v3 low pro mx cases
    [ro-v3-ul-cir-mx-w.stl, ro-v3-ul-cir-mx.stl, ro-v3-ul-n-mx-w.stl, ro-v3-ul-n-mx.stl]
2025-03-13 ximi case - fixed pmw3360 spacing for choc trackball
    [xi-5-choc-tr-ec-3wt-left.stl, xi-5-choc-tr-ec-3wt-right.stl, xi-5-choc-tr-ne-3wt-left.stl, xi-5-choc-tr-ne-3wt-right.stl, xi-6-choc-tr-ec-3wt-left.stl, xi-6-choc-tr-ec-3wt-right.stl, xi-6-choc-tr-ne-3wt-left.stl, xi-6-choc-tr-ne-3wt-right.stl]
2025-04-07 ffkb wireless edition v1 cases
    [ffkb-we-choc-slim-5-battery-on-bottom.stl, ffkb-we-choc-slim-5-battery-on-top-no-cirque.stl, ffkb-we-choc-slim-6-battery-on-bottom.stl, ffkb-we-choc-slim-6-battery-on-top-no-cirque.stl, ffkb-we-mx-slim-5-battery-on-top-no-cirque.stl.stl, ffkb-we-mx-slim-6-battery-on-top-no-cirque.stl, ffkb-we-slim-5-bot.stl, ffkb-we-slim-6-bot.stl]
2025-04-08 ffkb wireless edition case, updated aesthetics, and new flat bottom plate for the thick case
    [ffkb-wireless-edition-5-bot.stl, ffkb-wireless-edition-5-flat-bot.stl, ffkb-wireless-edition-6-bot.stl, ffkb-wireless-edition-6-flat-bot.stl, ffkb-wireless-edition-choc-5-body.stl, ffkb-wireless-edition-choc-6-body.stl, ffkb-wireless-edition-mx-5-body.stl, ffkb-wireless-edition-mx-6-body.stl]
2025-04-09 refined ffkb wireless edition cases readme, added mid-bot plates
    [ffkb-wireless-edition-5-mid-bot.stl, ffkb-wireless-edition-6-mid-bot.stl]
2025-04-09 final adjustments based on test prints
    [ffkb-wireless-edition-5-flat-bot.stl, ffkb-wireless-edition-5-mid-bot.stl, ffkb-wireless-edition-6-flat-bot.stl, ffkb-wireless-edition-6-mid-bot.stl]
2025-07-29 fixed ffkb we slim bot plates, and renamed double extension
    [ffkb-we-mx-slim-5-battery-on-top-no-cirque.stl, ffkb-we-slim-5-bot.stl, ffkb-we-slim-6-bot.stl]
2025-07-31 ffkb v4 tri exposure trackball cover
    [ff-rp-u3-trackball-cover-tri-exposure.stl]
